eddiematos/iosolar/README.md

# iosolar
Design files for a modular solar power system. These files are licensed with an open-source hardware license based on the Apache License Version 2.0, known as the Solderpad Hardware Licence Version 2.
