eddiematos/iosolar/04 3D CAD/20141228_tooling/Draft Angle Images/B Grommet Draft.jpg

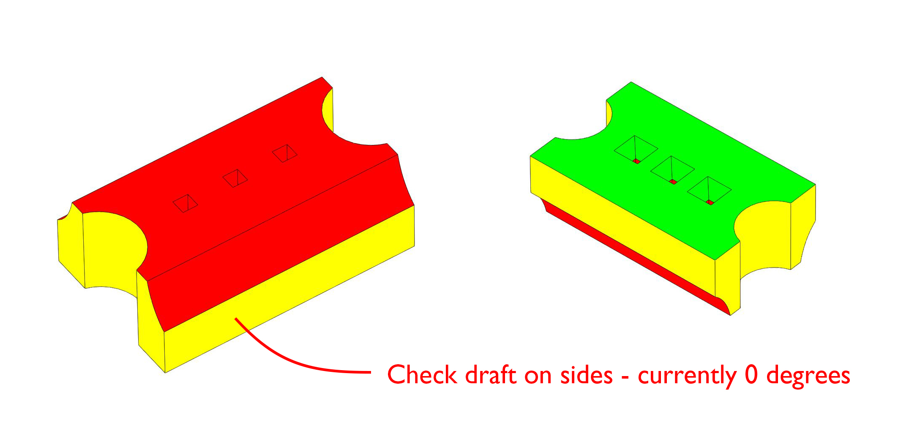
04 3D CAD/20141228_tooling/Draft Angle Images/B Grommet Draft.jpg
