eddiematos/iosolar/04 3D CAD/20141228_tooling/Draft Angle Images/Bottom Cover S 2.1.2 Draft.jpg

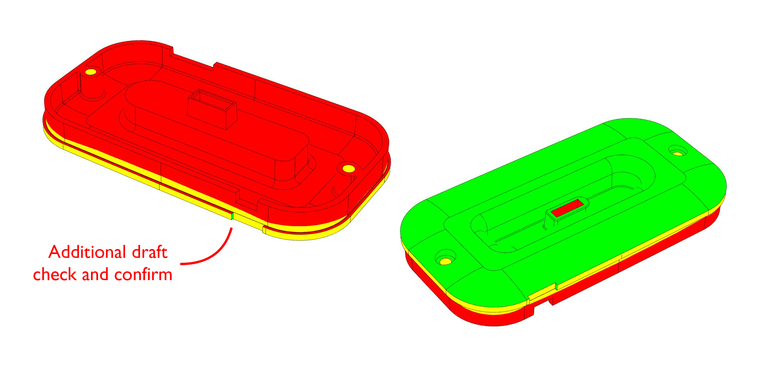
04 3D CAD/20141228_tooling/Draft Angle Images/Bottom Cover S 2.1.2 Draft.jpg
