eddiematos/iosolar/04 3D CAD/20141228_tooling/Draft Angle Images/Cross Section Across Pins.jpg

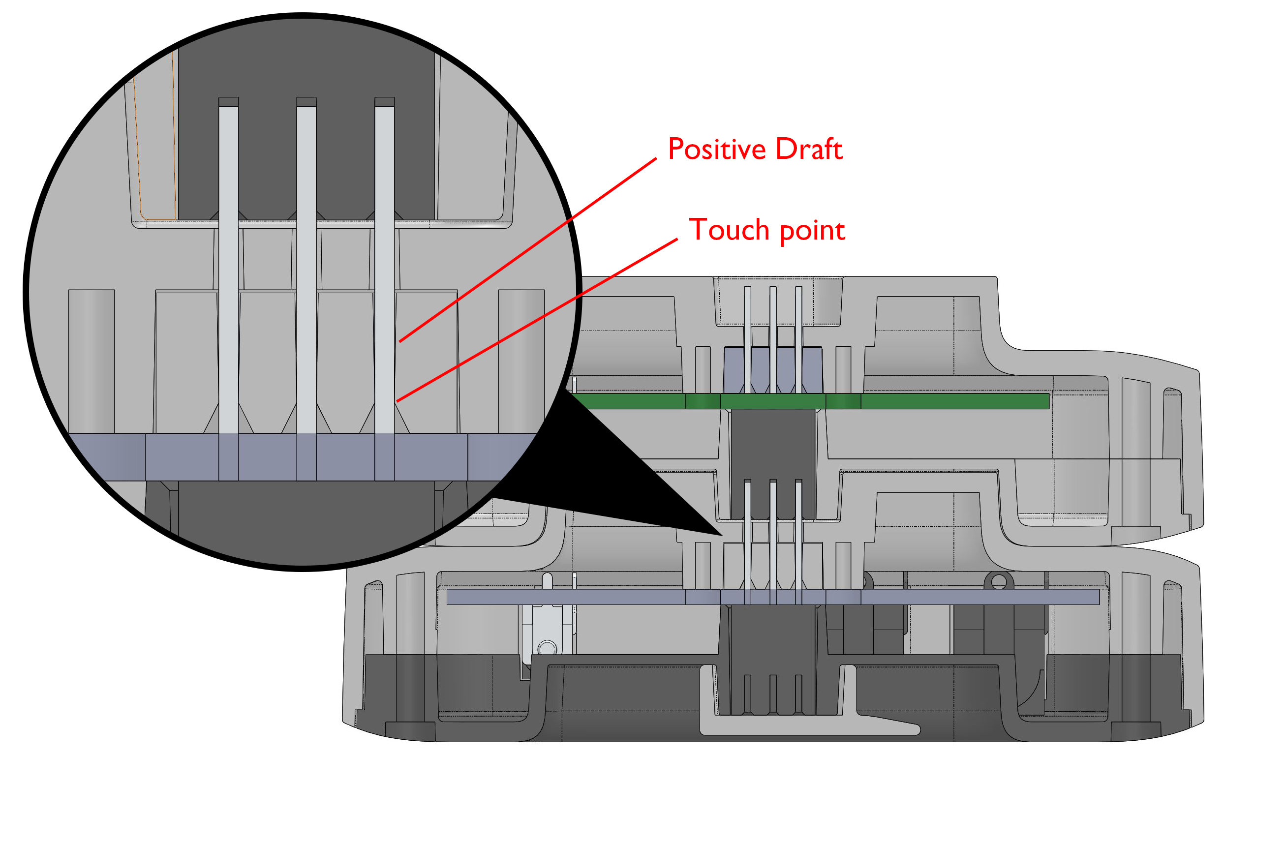
04 3D CAD/20141228_tooling/Draft Angle Images/Cross Section Across Pins.jpg
