eddiematos/iosolar/04 3D CAD/20141228_tooling/Draft Angle Images/Top Cover S 2.1.1 Draft.jpg

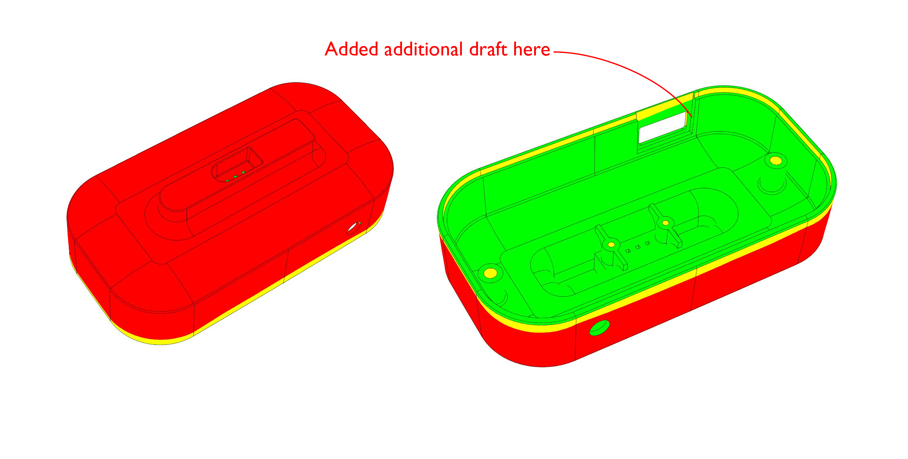
04 3D CAD/20141228_tooling/Draft Angle Images/Top Cover S 2.1.1 Draft.jpg
