eddiematos/iosolar/01 Printed Circuit Board/Charger/PCB extra cost to accomodate stacking connectors.xlsx

Estimate of extra cost of PCB space needed to be able to accommodate the stacking connectors.
PCB cost estimate
 | Cost | Size (mm²) | Cost/mm² | Doubled (because the copper thickness is double!)
Starter | £0.167 | 1925 | £0.0000867 | £0.0001733
Battery | £0.188 | 2275 | £0.0000825 | £0.0001650
Extra PCB space needed to accommodate stacking connectors
 | Size (mm²)
Without stacking connectors | 4788
With stacking connectors | 7740
Extra PCB space needed | 2952
Extra cost | £0.487
