eddiematos/iosolar/03 Bill of materials (electronics)/Battery 100/20150206 BOM_Battery100.xlsx

Sheet: PCB_spec
Part number | Part name | Spec ID | Spec description
B2.2.1 | Pre-assembled PCB-A | B2.2.1_handling | Normal precautions against electro-static discharge (ESD) shall be put into effect during handling and assembly of the PCB-As.
B2.2.2 | Pre-assembled PCB-A | B2.2.1_width | The width of the PCB shall be 35.0mm
B2.2.3 | Pre-assembled PCB-A | B2.2.1_length | The length of the PCB shall be 65.0mm.
B2.2.4 | Pre-assembled PCB-A | B2.2.4_thickness | The thickness of the PCB shall be 1.50mm.
B2.2.5 | Pre-assembled PCB-A | B2.2.5_material | The material of the PCB shall be FR4.
B2.2.6 | Pre-assembled PCB-A | B2.2.6_layers | The PCB shall have two layers (top and bottom)
B2.2.7 | Pre-assembled PCB-A | B2.2.7_copper | The copper layer thickness shall be 35 microns (1oz/ft²).
B2.2.8 | Pre-assembled PCB-A | B2.2.8_rohs | The PCB assembly shall be RoHS compliant.
B2.2.9 | Pre-assembled PCB-A | B2.2.9_soldermask | The soldermask colour shall be green.
B2.2.10 | Pre-assembled PCB-A | B2.2.10_silkscreen | The silkscreen printing shall be white.
B2.2.11 | Pre-assembled PCB-A | B2.2.11_coating | A basic protective conformal coating is desirable. Please advise with information about protective conformal coating options and their costs.

Sheet: BOM_spec
BOM Specification
Part ID | Part description | Manufacturer | Part number | Leadsintec spec (green - approved) | Replacable? | PCS | Spec 1 | Value (min) | Value (max) | Spec 2 | Value (min) | Value (max) | Spec 3 | Value (min) | Value (max) | Spec 4 | Value (min) | Value (max) | Spec 5 | Value (min) | Value (max)
C1 | Capacitor (MLCC) | Any | 0603 | 0603 1UF 10V X7R 10% (ROHS) | Yes | 1 | Capacitance (F) | 1e-06 |  | V_max (V) | 5 |  | Type | X7R
C12 | Capacitor (MLCC) | Any | 0805 | 0805 10UF 10V X5R 10% (ROHS) | Yes | 1 | Capacitance (F) | 1e-05 |  | V_max (V) | 5
C14 | Capacitor (MLCC) | Any | 0603 | 0603 1NF 50V 5% (ROHS) | Yes | 1 | Capacitance (F) | 1e-09 |  | V_max (V) | 5
C2 | Capacitor (MLCC) | Any | 0603 | 0603 2.2NF 50V X7R 10% (ROHS) | Yes | 1 | Capacitance (F) | 2.2e-09 |  | V_max (V) | 5
C3,7,8,9,10,13,15 | Capacitor (MLCC) | Any | 0603 | 0603 100NF 50V X7R 10% (ROHS) | Yes | 7 | Capacitance (F) | 1e-07 |  | V_max (V) | 5
C4 | Capacitor (MLCC) | Any | 0603 | 0603 100NF 50V X7R 10% (ROHS) | Yes | 1 | Capacitance (F) | 1e-07 |  | V_max (V) | 30 |  | Type | X7R
C6 | Capacitor (Aluminium electrolytic) | Lelon | VZH101M1VTR-0810 | 100UF 35V 20% 8*10.2MM PN:SANYO 35CE100AX (ROHS) | Yes | 1 | Capacitance (F) | 0.0001 |  | V_max (V) | 25 |  | Height (mm) |  | 11.0 | Lifetime (hours) | 5000
C11 | Capacitor (Aluminium electrolytic) | Lelon | VZH101M1VTR-0810 | 100UF 35V 20% 8*10.2MM PN:SANYO 35CE100AX (ROHS) | Yes | 1 | Capacitance (F) | 0.0001 |  | V_max (V) | 20 |  | Height (mm) |  | 11.0 | Lifetime (hours) | 5000 |  | Ir_max (RMS, mA, @50kHz) | 190
LED1 | Red/Green LED, common cathode | Multicomp | MCL039PURGW | MULTICOMP Red Green PN:MCL039PURGW (ROHS) | No | 1
D2,5,8 | Schottky diode, low Vf | NXP | PMEG3010BEA | NXP PMEG3010BEA SOD323 (ROHS) | Yes | 3 | V_f @ 0.2A, 85C (V) |  | 0.4 | I_fmax (av.) (A) | 0.5 |  | I_frm (A) | 1 |  | Vr_max (V) | 30
D3 | Schottky diode, low Vf, high I_fsm | Diodes Inc. | B340-13-F | DIODES B340-13-F SMC (ROHS) | Yes | 1 | V_f @ 0.2A, 85C (V) |  | 0.4 | I_f (av.) (A) | 2.5 |  | I_fsm (8.3mS) (A) | 20 |  | Vr_max (V) | 30
D6(A/B) | Dual schottky diode (common cathode) | Any | BAT54CWT1G | ON BAT54CWT1G SOT323 (ROHS) | Yes | 1 | I_f_max (A) | 0.2
F1 | PTC resettable fuse | Multicomp | MC36218 | MULTICOMP 750MAA 0.29R PN:MC36218 (ROHS) | Yes | 1 | V_max (V) | 20 |  | I_hold (A) | 0.75 |  | I_trip (A) |  | 1.5 | I_8.3ms (A) |  | 20
IC1 | 16-bit MCU | TI | MSP430G2332IPW20 | TI MSP430G2332IPW20 TSSOP-20 (ROHS) | No | 1
IC2 | MCU power supply, 3.3V | TI | TPS71533DCKR | TI TPS71533DCKR SC70 (ROHS) | No | 1
IC3 | DC/DC Converter controller | TI | MC33063AD | TI MC33063AD SOIC-8 (ROHS) | No | 1
J1,2 | DC barrel connector, 2.5mm, CUI, PJ-037BH | CUI | PJ-037BH | Socket ø2.5MM 90Degree 14.5*9*11MM PN:PJ-037BH (ROHS) | Yes | 2 | V_max (V) | 15 |  | I_max (A) | 3
J3 | DC barrel connector, 1.7mm, CUI, PJ-018 | CUI | PJ-017 | Socket ø1.65MM (PN:PJ-018）(ROHS) | Yes | 1 | V_max (V) | 25 |  | I_max (A) | 1
J4 | Right-angle JST connector, 5 way | JST | S5B-PH-K-S | JST BOX HEADER 5PIN 90Degree 2.0MM PN:S5B-PH-K-S (ROHS) | No | 1
J6 | Long header receptacle, Samtec, 3-way | Samtec | ESQ-103-14-T-S | SAMTEC 1*3PIN 2.54MM PN:ESQ-103-14-T-S/ESQ-103-14-L-S (ROHS) | No | 1
L1 | Inductor | NIC | NPIS65LS221MTRF | NPIS 220UH 20% 6*6*4.5MM PN:NPIS65LS221MTRF (ROHS) | Yes | 1 | Inductance (uH) | 220 |  | R_dc_max (Ω) |  | 1 | I_rms_max (A) | 0.4 |  | Diameter (mm) |  | 12.7 | Height (mm) |  | 11.0
Q1 | P-channel MOSFET, high surge current | Diodes Inc. | DMG3407SSN-7 | DIODES DMG3407SSN-7 SC59 (ROHS) | Yes | 1 | R_on_max (Ω) |  | 0.15 | I_max (av.) @ 70C (A) | 2.5 |  | I_max (8.3ms) (A) | 20 |  | Vds_max (V) | 17 |  | Vgs_max (V) | 17
Q2(A/B), Q5(A/B) | Dual NPN transistor | On Semi | BC846BDW1T1G | ON BC846BDW1T1G SOT-363 (ROHS) | Yes | 2 | Vceo_max (V) | 20 |  | Ic_max (mA) | 10
Q3(A/B), Q4(A/B) | Dual P-channel MOSFET | NXP | NX3008PBKV | NXP NX3008PBKV SOT666 (ROHS) | Yes | 2 | R_on_max (Ω) |  | 10 | I_max (av.) @ 70C (mA) | 60 |  | Vds_max (V) | 10 |  | Vgs_max (V) | 8
R1,3,5,7 | Resistor | Any | 0805 | 0805 1M 1% (ROHS) | Yes | 4 | Resistance (Ω) | 1000000 |  | Tolerance |  | 0.1%
R10 | Resistor | Any | 0603 | 0603 10K 5% (ROHS) | Yes | 1 | Resistance (Ω) | 10000 |  | Tolerance |  | 5%
R11 | Resistor | Any | 0603 | 0603 33K 5% (ROHS) | Yes | 1 | Resistance (Ω) | 33000 |  | Tolerance |  | 5%
R12 | Resistor | Any | 0603 | 0603 3.3K 5% (ROHS) | Yes | 1 | Resistance (Ω) | 3300 |  | Tolerance |  | 5%
R13 | Resistor | Any | 1206 | 1206 0.47R 5% (ROHS) | Yes | 1 | Resistance (Ω) | 0.47 |  | Tolerance |  | 5% | P_max (W) | 0.250
R14 | Resistor | Any | 0603 | 0603 9.1K 1% (ROHS) | Yes | 1 | Resistance (Ω) | 9100 |  | Tolerance |  | 1%
R15 | Resistor | Any | 0603 | 0603 1.3K 1% (ROHS) | Yes | 1 | Resistance (Ω) | 1300 |  | Tolerance |  | 1%
R16,21,30,31,32,33,34 | Resistor | Any | 0603 | 0603 100K 5% (ROHS) | Yes | 7 | Resistance (Ω) | 100000 |  | Tolerance |  | 5%
R17,19 | Resistor | Any | 0603 | 0603 1.2K 1% (ROHS) | Yes | 2 | Resistance (Ω) | 1200 |  | Tolerance |  | 1%
R2,4,6,8 | Resistor | Any | 0805 | 0805 100K 1% (ROHS) | Yes | 4 | Resistance (Ω) | 100000 |  | Tolerance |  | 0.1%
R20 | Resistor | Any | 0603 | 0603 1M 1% (ROHS) | Yes | 1 | Resistance (Ω) | 1000000 |  | Tolerance |  | 1%
R22 | Resistor | Any | 0603 | 0603 2.2K 1% (ROHS) | Yes | 1 | Resistance (Ω) | 2200 |  | Tolerance |  | 1%
R23 | Resistor | Any | 0603 | 0603 33K 1% (ROHS) | Yes | 1 | Resistance (Ω) | 33000 |  | Tolerance |  | 1%
R35,36,37,38 | Resistor | Any | 1206 | 1206 100R 1% (ROHS) | Yes | 4 | Resistance (Ω) | 100 |  | Tolerance |  | 1% | P_max (W) | 0.125
R9,18 | Resistor | Any | 0603 | 0603 47K 1% (ROHS) | Yes | 2 | Resistance (Ω) | 47000 |  | Tolerance |  | 1%

Sheet: BOM_EM
EM sourcing
Part ID | Part description | PCS | Spec 1 | Value | Spec 2 | Value | Spec 3 | Value | Spec 4 | Value | Spec 5 | Value | Source | Order code | Price (1000pcs) | Currency | Total component price (USD) | Assembly points (per unit) | Assembly type | Unit assembly cost (USD) | Total assembly price (USD) | Total price (USD) | Package size | Part number | CNY | 0.1612903226
C1 | Capacitor (MLCC) | 1 | Capacitance (F) | 1e-06 | V_max (V) | 10 | Type | X7R |  |  |  |  | Farnell | 2112849 | 0.080 | CNY | 0.0129 | 1.0 | smt | 0.007 | 0.007 | 0.020 | 0603 |  | GBP | 1.53 | 0.375
C12 | Capacitor (MLCC) | 1 | Capacitance (F) | 1e-05 | V_max (V) | 10 |  |  |  |  |  |  | Farnell | 1735335 | 0.147 | CNY | 0.0237 | 1.0 | smt | 0.007 | 0.007 | 0.031 | 0805 |  | USD | 1
C14 | Capacitor (MLCC) | 1 | Capacitance (F) | 1e-09 | V_max (V) | 50 |  |  |  |  |  |  | Farnell | 499134 | 0.023 | CNY | 0.0037 | 1.0 | smt | 0.007 | 0.007 | 0.011 | 0603
C2 | Capacitor (MLCC) | 1 | Capacitance (F) | 2.2e-09 | V_max (V) | 50 |  |  |  |  |  |  | Farnell | 2320806 | 0.024 | CNY | 0.0039 | 1.0 | smt | 0.007 | 0.007 | 0.011 | 0603
C3,7,8,9,10,13,15 | Capacitor (MLCC) | 7 | Capacitance (F) | 1e-07 | V_max (V) | 50 |  |  |  |  |  |  | Farnell | 1759016 | 0.018 | CNY | 0.0203 | 1.0 | smt | 0.007 | 0.049 | 0.069 | 0603
C4 | Capacitor (MLCC) | 1 | Capacitance (F) | 1e-07 | V_max (V) | 50 | Type | X7R |  |  |  |  | Farnell | 1759122 | 0.031 | CNY | 0.0050 | 1.0 | smt | 0.007 | 0.007 | 0.012 | 0603
C6 | Capacitor (Aluminium electrolytic) | 1 | Capacitance (F) | 0.0001 | V_max (V) | 35 | Height (mm) | 10.0 | Diameter (mm) | 8.0 | Ir_max (mA) | 450 | Arrow | - | 0.062 | USD | 0.0625 | 1.0 | smt | 0.007 | 0.007 | 0.070 | 8MM Radial Can SMD | VZH101M1VTR-0810
C11 | Capacitor (Aluminium electrolytic) | 1 | Capacitance (F) | 0.0001 | V_max (V) | 35 | Height (mm) | 10.0 | Diameter (mm) | 8.0 | Ir_max (mA) | 450 | Arrow | - | 0.062 | USD | 0.0625 | 1.0 | smt | 0.007 | 0.007 | 0.070 | 8MM Radial Can SMD | VZH101M1VTR-0810
LED1 | Red/Green LED, common cathode | 1 | Manufacturer | Multicomp | Model | MCL039PURGW |  |  |  |  |  |  | Farnell | 1581194 | 1.900 | CNY | 0.3065 | 3.0 | pth | 0.042 | 0.042 | 0.348 | 3MM (T1)
D2,5,8 | Schottky diode, low Vf | 3 | V_f @ 0.2A, 85C (V) | 0.24 | I_fmax (av.) (A) | 1 | I_frm (A) | 3.5 | Vr_max (V) | 30 |  |  | Farnell | 8737991 | 0.325 | CNY | 0.1573 | 1.5 | smt | 0.011 | 0.0315 | 0.189 | SOD-323 | PMEG3010BEA
D3 | Schottky diode, low Vf, high I_fsm | 1 | V_f @ 0.2A, 85C (V) | 0.25 | I_f (av.) (A) | 3 | I_fsm (8.3mS) (A) | 100 | Vr_max (V) | 40 |  |  | Farnell/Arrow | 1843695 | 0.083 | USD | 0.0825 | 1.5 | smt | 0.011 | 0.0105 | 0.093 | SMC (6mm x 7mm) | B340-13-F
D6(A/B) | Dual schottky diode (common cathode) | 1 |  |  |  |  |  |  |  |  |  |  | Farnell | 2322475 | 0.190 | CNY | 0.0306 | 1.5 | smt | 0.011 | 0.0105 | 0.041 | SOT-323 | BAT54CWT1G
F1 | PTC resettable fuse | 1 | V_max (V) | 24 | I_hold (A) | 0.75 | I_trip (A) | 1.5 | I_8ms (A) | 15 |  |  | Farnell | 1861163 | 0.900 | CNY | 0.1452 | 2.0 | smt | 0.014 | 0.014 | 0.159 | 1812 | MC36218
IC1 | 16-bit MCU | 1 | Manufacturer | TI | Model | MSP430G2332IPW20 |  |  |  |  |  |  | Farnell | 1866892 | 5.060 | CNY | 0.8161 | 10.0 | smt | 0.070 | 0.07 | 0.886 | TSSOP-20 | MSP430G2332IPW20
IC2 | MCU power supply, 3.3V | 1 | Manufacturer | TI | Model | TPS71533DCK |  |  |  |  |  |  | Farnell/Arrow | 1135383 | 0.364 | USD | 0.3643 | 2.5 | smt | 0.018 | 0.0175 | 0.382 | SC-70-5 | TPS71533DCKR
IC3 | DC/DC Converter controller | 1 | Manufacturer | TI | Model | MC33063AD |  |  |  |  |  |  | Farnell/Arrow | 1053587 | 1.600 | CNY | 0.2581 | 4.0 | smt | 0.028 | 0.028 | 0.286 | SOIC-08 | MC33063AD
J1,2 | DC barrel connector, 2.5mm, CUI, PJ-037BH | 2 | V_max (V) | 16 | I_max (A) | 5 |  |  |  |  |  |  | DigiKey | CP-037BH-ND | 2.939 | CNY | 0.9480 | 2.0 | pth | 0.028 | 0.056 | 1.004 | 11.4mm x 5.0mm | PJ-037BH
J3 | DC barrel connector, 1.7mm, CUI, PJ-018 | 1 | V_max (V) | 16 | I_max (A) | 2 |  |  |  |  |  |  | DigiKey | CP-018PJ-ND | 2.595 | CNY | 0.4185 | 3.0 | pth | 0.042 | 0.042 | 0.461 | 14.5mm x 9.0mm | PJ-018
J4 | Right-angle JST connector, 5 way | 1 | Manufacturer | JST | Model | S5B-PH-K-S |  |  |  |  |  |  | Farnell | 9492496 | 0.391 | CNY | 0.0631 | 5.0 | pth | 0.070 | 0.07 | 0.133 | 5 x 2.0mm
J6 | Long header connector, Samtec, 3-way | 1 | Manufacturer | Samtec | Model | ESQ-103-14-T-S |  |  |  |  |  |  | Samtec | - | 0.281 | GBP | 0.4299 | 3.0 | pth | 0.042 | 0.042 | 0.472 | 3 x 2.54mm | ESQ-103-14-T-S
L1 | Inductor | 1 | Inductance (uH) | 220uH | R_dc_max (Ω) | 0.834 | I_rms_max (A) | 0.59 | Diameter (mm) | 6.3 | Height (mm) | 4.5 | Arrow | - | 0.130 | USD | 0.1300 | 2.0 | smt | 0.014 | 0.014 | 0.144 | 6.3Lx6.3Wx4.5Hmm | NPIS65LS221MTRF
Q1 | P-channel MOSFET, high surge current | 1 | R_on_max (Ω) | 0.05 | I_max (av.) @ 70C (A) | 3.2 | I_max (10ms) (A) | 23 | Vds_max (V) | 30 | Vgs_max (V) | 20 | Arrow | - | 0.078 | USD | 0.0780 | 1.5 | smt | 0.011 | 0.0105 | 0.088 | SC-59 | DMG3407SSN-7
Q2(A/B), Q5(A/B) | Dual NPN transistor | 2 | Vceo_max (V) | 65 | Ic_max (mA) | 100 |  |  |  |  |  |  | Farnell/Arrow | 2317636 | 0.043 | USD | 0.0866 | 3.0 | smt | 0.021 | 0.042 | 0.129 | SOT-363 | BC846BDW1T1G
Q3(A/B), Q4(A/B) | Dual P-channel MOSFET | 2 | R_on_max (Ω) | 4.1 | I_max (av.) @ 70C (mA) | 140 | Vds_max (V) | 30 | Vgs_max (V) | 8 |  |  | Farnell | 2069550 | 0.690 | CNY | 0.2226 | 3.0 | smt | 0.021 | 0.042 | 0.265 | SOT-666 | NX3008PBKV
R1,3,5,7 | Resistor | 4 | Resistance (Ω) | 1000000 | Tolerance | 0.1% |  |  |  |  |  |  | Farnell | 1638448 | 0.300 | CNY | 0.1935 | 1.0 | smt | 0.007 | 0.028 | 0.222 | 0805
R10 | Resistor | 1 | Resistance (Ω) | 10000 | Tolerance | 5% |  |  |  |  |  |  | Farnell | 2073356 | 0.010 | CNY | 0.0016 | 1.0 | smt | 0.007 | 0.007 | 0.009 | 0603
R11 | Resistor | 1 | Resistance (Ω) | 33000 | Tolerance | 1% |  |  |  |  |  |  | Farnell | 2447342 | 0.070 | CNY | 0.0113 | 1.0 | smt | 0.007 | 0.007 | 0.018 | 0603
R12 | Resistor | 1 | Resistance (Ω) | 3300 | Tolerance | 5% |  |  |  |  |  |  | Farnell | 9233440 | 0.005 | CNY | 0.0009 | 1.0 | smt | 0.007 | 0.007 | 0.008 | 0603
R13 | Resistor | 1 | Resistance (Ω) | 0.47 | Tolerance | 5% | P_max (W) | 0.5 |  |  |  |  | Farnell | 2116435 | 0.350 | CNY | 0.0565 | 2.0 | smt | 0.014 | 0.014 | 0.070 | 1206
R14 | Resistor | 1 | Resistance (Ω) | 9100 | Tolerance | 1% |  |  |  |  |  |  | Farnell | 9331611 | 0.009 | CNY | 0.0015 | 1.0 | smt | 0.007 | 0.007 | 0.008 | 0603
R15 | Resistor | 1 | Resistance (Ω) | 1300 | Tolerance | 1% |  |  |  |  |  |  | Farnell | 9330550 | 0.011 | CNY | 0.0018 | 1.0 | smt | 0.007 | 0.007 | 0.009 | 0603
R16,21,30,31,32,33,34 | Resistor | 7 | Resistance (Ω) | 100000 | Tolerance | 5% |  |  |  |  |  |  | Farnell | 9233628 | 0.065 | CNY | 0.0734 | 1.0 | smt | 0.007 | 0.049 | 0.122 | 0603
R17,19 | Resistor | 2 | Resistance (Ω) | 1200 | Tolerance | 1% |  |  |  |  |  |  | Farnell | 9238492 | 0.009 | CNY | 0.0029 | 1.0 | smt | 0.007 | 0.014 | 0.017 | 0603
R2,4,6,8 | Resistor | 4 | Resistance (Ω) | 100000 | Tolerance | 0.10% |  |  |  |  |  |  | Farnell | 1638446 | 0.200 | CNY | 0.1290 | 1.0 | smt | 0.007 | 0.028 | 0.157 | 0805
R20 | Resistor | 1 | Resistance (Ω) | 1000000 | Tolerance | 1% |  |  |  |  |  |  | Farnell | 9238840 | 0.010 | CNY | 0.0016 | 1.0 | smt | 0.007 | 0.007 | 0.009 | 0603
R22 | Resistor | 1 | Resistance (Ω) | 2200 | Tolerance | 1% |  |  |  |  |  |  | Farnell | 1255637 | 0.009 | CNY | 0.0015 | 1.0 | smt | 0.007 | 0.007 | 0.008 | 0603
R23 | Resistor | 1 | Resistance (Ω) | 33000 | Tolerance | 1% |  |  |  |  |  |  | Farnell | 9238662 | 0.009 | CNY | 0.0015 | 1.0 | smt | 0.007 | 0.007 | 0.008 | 0603
R35,36,37,38 | Resistor | 4 | Resistance (Ω) | 100 | Tolerance | 1% | Pmax (W) | 0.125 |  |  |  |  | Farnell | 9335749 | 0.020 | CNY | 0.0129 | 2.0 | smt | 0.014 | 0.056 | 0.069 | 1206
R9,18 | Resistor | 2 | Resistance (Ω) | 47000 | Tolerance | 1% |  |  |  |  |  |  | Farnell | 9331255 | 0.006 | CNY | 0.0019 | 1.0 | smt | 0.007 | 0.014 | 0.016 | 0603
 |  |  |  |  |  |  |  |  |  |  |  |  |  |  |  |  | 5.2234 |  |  |  | 0.8995 | 6.123
 |  |  |  |  |  |  |  |  |  |  |  |  |  |  |  |  |  | smt points | 57.5
 |  |  |  |  |  |  |  |  |  |  |  |  |  |  |  |  |  | pth points | 16

Sheet: BOM_FP
FastPCB sourcing
Part ID | Part description | PCS | Spec 1 | Value | Spec 2 | Value | Spec 3 | Value | Spec 4 | Value | Spec 5 | Value | Source | Order code | Price (1000pcs) | Currency | Total price (USD) | Cost difference | Package size | Part number | Price | CNY | 0.1612903226
C1 | Capacitor (MLCC) | 1 | Capacitance (F) | 1e-06 | V_max (V) | 5V | Type | X7R |  |  |  |  |  |  | 0.060 | CNY | 0.010 | 0.010 | 0603 |  |  | USD | 1
C12 | Capacitor (MLCC) | 1 | Capacitance (F) | 1e-05 | V_max (V) | 5V |  |  |  |  |  |  |  |  | 0.080 | CNY | 0.013 | 0.018 | 0805
C14 | Capacitor (MLCC) | 1 | Capacitance (F) | 1e-09 | V_max (V) | 5V |  |  |  |  |  |  |  |  | 0.050 | CNY | 0.008 | 0.003 | 0603
C2 | Capacitor (MLCC) | 1 | Capacitance (F) | 2.2e-09 | V_max (V) | 5V |  |  |  |  |  |  |  |  | 0.050 | CNY | 0.008 | 0.003 | 0603
C3,7,8,9,10,13,15 | Capacitor (MLCC) | 7 | Capacitance (F) | 1e-07 | V_max (V) | 5V |  |  |  |  |  |  |  |  | 0.009 | CNY | 0.010 | 0.059 | 0603
C4 | Capacitor (MLCC) | 1 | Capacitance (F) | 1e-07 | V_max (V) | 50V | Type | X7R |  |  |  |  |  |  | 0.060 | CNY | 0.010 | 0.002 | 0603
C6 | Capacitor (Aluminium electrolytic) | 1 | Capacitance (F) | 0.0001 | V_max (V) | 50V | Height (mm) | 12.0 | Diameter (mm) | 8.0 | Ir_max (mA) |  |  |  | 0.800 | CNY | 0.129 | -0.060
C11 | Capacitor (Aluminium electrolytic) | 1 | Capacitance (F) | 0.0001 | V_max (V) | 50V | Height (mm) | 10.0 | Diameter (mm) | 8.0 | Ir_max (mA) |  |  |  | 0.800 | CNY | 0.129 | -0.060
LED1 | Red/Green LED, common cathode | 1 | Manufacturer | - | Model | - |  |  |  |  |  |  |  |  | 0.250 | CNY | 0.040 | 0.308
D2,5,8 | Schottky diode, low Vf | 3 | V_f @ 0.2A, 85C (V) | 0.24 | I_fmax (av.) (A) | 1 | I_frm (A) | 3.5 | Vr_max (V) | 30 |  |  |  |  | 0.380 | CNY | 0.184 | 0.005 | SOD-323 | PMEG3010BEA
D3 | Schottky diode, low Vf, high I_fsm | 1 | V_f @ 0.2A, 85C (V) | 0.25 | I_f (av.) (A) | 3 | I_fsm (8.3mS) (A) | 100 | Vr_max (V) | 40 |  |  |  |  | 0.390 | CNY | 0.063 | 0.030 | SMC (6mm x 7mm) | B340B-13-F
D6(A/B) | Dual schottky diode (common cathode) | 1 |  |  |  |  |  |  |  |  |  |  |  |  | 0.180 | CNY | 0.029 | 0.012 | SOT-323 | BAT54CWT1G
F1 | PTC resettable fuse | 1 | V_max (V) | 24 | I_hold (A) | 0.75 | I_trip (A) | 1.5 | I_8ms (A) | 15 |  |  |  |  | 0.970 | CNY | 0.156 | 0.003 | 1812 | MC36218
IC1 | 16-bit MCU | 1 | Manufacturer | TI | Model | MSP430G2332IPW20 |  |  |  |  |  |  |  |  | 4.500 | CNY | 0.726 | 0.160 | TSSOP-20 | MSP430G2332IPW20
IC2 | MCU power supply, 3.3V | 1 | Manufacturer | TI | Model | TPS71533DCK |  |  |  |  |  |  |  |  | 1.800 | CNY | 0.290 | 0.091 | SC-70 | TPS71533DCKR
IC3 | DC/DC Converter controller | 1 | Manufacturer | TI | Model | MC33063AD |  |  |  |  |  |  |  |  | 1.400 | CNY | 0.226 | 0.060 | SOIC-08 | MC33063AD
J1,2 | DC barrel connector, 2.5mm, CUI, PJ-037BH | 2 | V_max (V) | 16 | I_max (A) | 5 |  |  |  |  |  |  |  |  | 2.960 | CNY | 0.955 | 0.049 | 11.4mm x 5.0mm | PJ-037BH
J3 | DC barrel connector, 1.7mm, CUI, PJ-018 | 1 | V_max (V) | 16 | I_max (A) | 2 |  |  |  |  |  |  |  |  | 2.500 | CNY | 0.403 | 0.057 | 14.5mm x 9.0mm | PJ-018
J4 | Right-angle JST connector, 5 way | 1 | Manufacturer | JST | Model | S5B-PH-K-S |  |  |  |  |  |  |  |  | 0.500 | CNY | 0.081 | 0.052 | 5 x 2.0mm
J6 | Long header connector, Samtec, 3-way | 1 | Manufacturer | Samtec | Model | SSQ |  |  |  |  |  |  |  |  | 2.200 | CNY | 0.355 | 0.117 | 3 x 2.54mm | SSQ-103-04-T-S
L1 | Inductor | 1 | Inductance (uH) | 220uH | R_dc_max (Ω) | 0.834 | I_rms_max (A) | 0.59 | Diameter (mm) | 6.3 | Height (mm) | 4.5 |  |  | 0.910 | CNY | 0.147 | -0.003 | 6.3Lx6.3Wx4.5Hmm | NPIS65LS221MTRF
Q1 | P-channel MOSFET, high surge current | 1 | R_on_max (Ω) | 0.05 | I_max (av.) @ 70C (A) | 3.2 | I_max (10ms) (A) | 23 | Vds_max (V) | 30 | Vgs_max (V) | 20 |  |  | 0.700 | CNY | 0.113 | -0.024 | SC-59 | DMG3407SSN-7
Q2(A/B), Q5(A/B) | Dual NPN transistor | 2 | Vceo_max (V) | 65 | Ic_max (mA) | 100 |  |  |  |  |  |  |  |  | 0.150 | CNY | 0.048 | 0.080 | SOT-363 | BC846BDW1T1G
Q3(A/B), Q4(A/B) | Dual P-channel MOSFET | 2 | R_on_max (Ω) | 4.1 | I_max (av.) @ 70C (mA) | 140 | Vds_max (V) | 30 | Vgs_max (V) | 8 |  |  |  |  | 0.500 | CNY | 0.161 | 0.103 | SOT-666 | NX3008PBKV
R1,3,5,7 | Resistor | 4 | Resistance (Ω) | 1000000 | Tolerance | 0.1% |  |  |  |  |  |  |  |  | 0.186 | CNY | 0.120 | 0.102 | 0805
R10 | Resistor | 1 | Resistance (Ω) | 10000 | Tolerance | 5% |  |  |  |  |  |  |  |  | 0.010 | CNY | 0.002 | 0.007 | 0603
R11 | Resistor | 1 | Resistance (Ω) | 33000 | Tolerance | 5% |  |  |  |  |  |  |  |  | 0.010 | CNY | 0.002 | 0.017 | 0603
R12 | Resistor | 1 | Resistance (Ω) | 3300 | Tolerance | 5% |  |  |  |  |  |  |  |  | 0.010 | CNY | 0.002 | 0.006 | 0603
R13 | Resistor | 1 | Resistance (Ω) | 0.56 | Tolerance | 1% | P_max (W) | 0.25 |  |  |  |  |  |  | 0.150 | CNY | 0.024 | 0.046 | 1206
R14 | Resistor | 1 | Resistance (Ω) | 9100 | Tolerance | 1% |  |  |  |  |  |  |  |  | 0.010 | CNY | 0.002 | 0.007 | 0603
R15 | Resistor | 1 | Resistance (Ω) | 1300 | Tolerance | 1% |  |  |  |  |  |  |  |  | 0.010 | CNY | 0.002 | 0.007 | 0603
R16,21,30,31,32,33,34 | Resistor | 7 | Resistance (Ω) | 100000 | Tolerance | 1% |  |  |  |  |  |  |  |  | 0.004 | CNY | 0.005 | 0.118 | 0603
R17,19 | Resistor | 2 | Resistance (Ω) | 1200 | Tolerance | 1% |  |  |  |  |  |  |  |  | 0.010 | CNY | 0.003 | 0.014 | 0603
R2,4,6,8 | Resistor | 4 | Resistance (Ω) | 100000 | Tolerance | 0.10% |  |  |  |  |  |  |  |  | 0.186 | CNY | 0.120 | 0.037 | 0805
R20 | Resistor | 1 | Resistance (Ω) | 1000000 | Tolerance | 1% |  |  |  |  |  |  |  |  | 0.010 | CNY | 0.002 | 0.007 | 0603
R22 | Resistor | 1 | Resistance (Ω) | 2200 | Tolerance | 1% |  |  |  |  |  |  |  |  | 0.010 | CNY | 0.002 | 0.007 | 0603
R23 | Resistor | 1 | Resistance (Ω) | 33000 | Tolerance | 1% |  |  |  |  |  |  |  |  | 0.010 | CNY | 0.002 | 0.007 | 0603
R35,36,37,38 | Resistor | 4 | Resistance (Ω) | 100 | Tolerance | 1% | Pmax (W) | 0.125 |  |  |  |  |  |  | 0.004 | CNY | 0.003 | 0.066 | 1206
R9,18 | Resistor | 2 | Resistance (Ω) | 47000 | Tolerance | 1% |  |  |  |  |  |  |  |  | 0.010 | CNY | 0.003 | 0.013 | 0603
 |  |  |  |  |  |  |  |  |  |  |  |  |  |  |  |  | 4.585 | 1.538 | 33.55168338%
