eddiematos/iosolar/03 Bill of materials (electronics)/Charger/20160209 BOM_Charger.xlsx

Sheet: BOM_spec
BOM Specification
Part ID | Part description | Manufacturer | Part number | Package | Proto OC | Order margin | Est. unit cost (1000 units) | Replacable? | PCS | Est. total cost (1000 units) | Spec 1 | Value (min) | Value (max) | Spec 2 | Value (min) | Value (max) | Spec 3 | Value (min) | Value (max) | Spec 4 | Value (min) | Value (max) | Spec 5 | Value (min) | Value (max)
C1,13,14,19 | Capacitor (MLCC) | Any | 0603 | 0603 | 2211179 | 2 | £0.027 | Yes | 4 | £0.107 | Capacitance (F) | 1e-06 |  | V_max | 35 |  | Dielectric | X5R
C2,10 | Capacitor (MLCC) | Any | 0603 | 0603 | 2211179 | 2 | £0.007 | Yes | 2 | £0.013 | Capacitance (F) | 1e-06 |  | V_max | 15 |  | Dielectric | X5R
C3,12 | Capacitor (MLCC) | Any | 0603 | 0603 | 2309012 | 2 | £0.004 | Yes | 2 | £0.007 | Capacitance (F) | 2.2e-11 |  | V_max | 35 |  | Dielectric | X5R
C4,5 | Capacitor (MLCC) | Murata | GRM31CR6YA106KA12L | 1206 | 1797011 | 2 | £0.125 | No | 2 | £0.250 | Capacitance (F) | 1e-05 |  | V_max | 35 |  | Dielectric | X5R |  | I_rms_max (@600kHz) (A) | 0.267
C6,7 | Capacitor (MLCC) | Murata | GRM31CR6YA106KA12L | 1206 | 1797011 | 2 | £0.125 | No | 2 | £0.250 | Capacitance (F) | 1e-05 |  | V_max | 35 |  | Dielectric | X5R |  | I_rms_max (@600kHz) (A) | 1.667
C8,9,00 | Capacitor (MLCC) | Any | 0603 | 0603 | 1759037 | 2 | £0.003 | Yes | 3 | £0.009 | Capacitance (F) | 1e-07 |  | V_max | 15 |  | Dielectric | X5R
C11 | Capacitor (MLCC) | Any | 0603 | 0603 | 2211185 | 2 | £0.036 | Yes | 1 | £0.036 | Capacitance (F) | 2.2e-06 |  | V_max | 35 |  | Dielectric | X5R
C15 | Capacitor (MLCC) | Any | 0603 | 0603 | 2320814 | 2 | £0.018 | Yes | 1 | £0.018 | Capacitance (F) | 1e-06 |  | V_max | 6.3 |  | Dielectric | X5R
C16,18,20,21,22 | Capacitor (MLCC) | Any | 0603 | 0603 | 1759016 | 2 | £0.003 | Yes | 5 | £0.015 | Capacitance (F) | 1e-07 |  | V_max | 6.3 |  | Dielectric | X5R
C17 | Capacitor (MLCC) | Any | 0603 | 0603 | 1759093 | 2 | £0.005 | Yes | 1 | £0.005 | Capacitance (F) | 2.2e-09 |  | V_max | 6.3 |  | Dielectric | X5R
C23 | Capacitor (MLCC) | Any | 0603 | 0603 | 1759122 | 2 | £0.005 | Yes | 1 | £0.005 | Capacitance (F) | 1e-07 |  | V_max | 35 |  | Dielectric | X5R
LED1 | Red/Green LED, common cathode | Multicomp | MCL039PURGW | T1 - 3MM | 1581194 | 1.2 | £0.140 | No | 1 | £0.140
D1 | Power schottky diode | On Semi | MBRD835LG | 6.17x11.78MM DPAK | 9556249 | 1.2 | £0.166 | Yes | 1 | £0.166 | V_f @ 0.2A, 85C (V) |  | 0.4 | I_fmax (av.) (A) | 6.0 |  | Vr_max (V) | 30
D3,5 | Small-signal schottky diode | Fairchild | BAT54XV2 | SOD-523F | 2322476 | added 09/02/2013 | £0.025 | Yes | 2 | £0.049 | I_f_max (A) | 0.2 |  | V_r_repetitive (V) | 30
D4 | Power schottky diode | On Semi | NTS1545MFST | SO-8 FLAT | 2452050 | 1.2 | £0.180 | Maybe | 1 | £0.180
D2,6(A/B) | Dual schottky diode (common cathode) | Fairchild | BAT54C | SOT-23 | 1467518 | added 09/02/2013 | £0.026 | Yes | 2 | £0.052 | I_f_max (A) | 0.2 |  | V_r_repetitive (V) | 30
F1 | PTC resettable fuse | Bourns | MF-LSMF300/24X-2 | 2920 | 2057925 | 1.2 | £0.243 | No | 1 | £0.243
IC1 | Solar battery charge controller ASIC | TI | BQ24650 | QFN-16 | Digikey | 1.2 | £1.930 | No | 1 | £1.930
IC2 | 16bit - MCU | TI | MSP430G2432IPW20 | TSSOP-20 | 1866910 | 1.5 | £0.581 | No | 1 | £0.581
IC3 | Current sense monitor | TI | INA199A2DCKR | SC70-6 | Digikey | 1.2 | £0.274 | No | 1 | £0.274
IC4 | MCU power supply, 3.3V | TI | TPS71533DCKR | SC70-5 | 1135383 | added 09/02/2013 | £0.253 | No | 1 | £0.253
J1 | 6-pos terminal block, screw | Multicomp | MC000038 |  | 2008008 | 1.2 | £0.393 | Yes | 1 | £0.393 | Contacts | 6 |  | Current_max (A) | 15 |  | Min. wire size | 26AWG or thinner |  | Max. wire size | 12AWG or fatter
J2 | 3-pos male header | Samtec | TSW-103-17-T-S |  | Samtec | 2 | £0.104 | No | 1 | £0.104
J3,4 | 3-pos terminal block, screw | Multicomp | MC000027 |  | 2007996 | 1.2 | £0.183 | Yes | 2 | £0.366 | Contacts | 3 |  | Current_max (A) | 15 |  | Min. wire size | 26AWG or thinner |  | Max. wire size | 12AWG or fatter
L1 | Inductor | Any | 12.5mm x 12.5mm x 6.0mm | 12.5mm x 12.5mm x 6.0mm | 1864449 | 1.2 | £0.200 | Yes | 1 | £0.200 | Inductance (H) | 6.8e-06 |  | I_rms_max (A) | 4.5 |  | I_sat (A) | 5
Q1(A/B) | Dual N-channel Power MOSFET | Vishay Siliconix | Si7288DP | PowerPAK SO-8 | Digikey | 1.2 | £0.491 | No | 1 | £0.491
Q2,3 | Small-signal MOSFET | NXP | 2N7002 | SOT-23 | 1510761 | 1.2 | £0.019 | No | 2 | £0.038
Q4(A/B),5(A/B) | Dual NPN transistor | On Semi | BC846BDW1T1G | SOT-363 | 2317636 | 1.2 | £0.028 | No | 2 | £0.055
Q6 | P-channel Power MOSFET | Vishay | SI7157DP-T1-GE3 | PowerPAK SO-8 | 2471947 | 1.2 | £0.041 | Maybe | 1 | £0.041
R1 | Resistor | Any | 0603 | 0603 | 2059548 | 2 | £0.001 | Yes | 1 | £0.001 | Resistance (Ω) | 10 |  | Tolerance |  | 0.05
R2 | Resistor | Any | 0603 | 0603 | 9331620 | 2 | £0.005 | Yes | 1 | £0.005 | Resistance (Ω) | 91000 |  | Tolerance |  | 0.01
R3 | Resistor | Any | 0603 | 0603 | 2332014 | 2 | £0.004 | Yes | 1 | £0.004 | Resistance (Ω) | 6800 |  | Tolerance |  | 0.01
R4 | Resistor | Any | 0603 | 0603 | 1670209 | 2 | £0.037 | Yes | 1 | £0.037 | Resistance (Ω) | 300000 |  | Tolerance |  | 0.001
R5 | Resistor | Any | 0805 | 0805 | 1575985 | 2 | £0.039 | Yes | 1 | £0.039 | Resistance (Ω) | 53600 |  | Tolerance |  | 0.001
R6 | Resistor | Any | LRMAM1206-R01FT5 | 1206 | 2079442 | 2 | £0.081 | Yes | 1 | £0.081 | Resistance (Ω) | 0.01 |  | Tolerance |  | 0.01 | Power (W) | 1.0
R7,30 | Resistor | Any | 0603 | 0603 | 2059441 | 2 | £0.003 | Yes | 2 | £0.005 | Resistance (Ω) | 24000 |  | Tolerance |  | 0.01
R8 | Resistor | Any | 0603 | 0603 | 2303207 | 2 | £0.003 | Yes | 1 | £0.003 | Resistance (Ω) | 36000 |  | Tolerance |  | 0.01
R9 | Resistor | Any | 0603 | 0603 | 2447328 | 2 | £0.001 | Yes | 1 | £0.001 | Resistance (Ω) | 2.2 |  | Tolerance |  | 0.05
R10 | Resistor | Any | TLR3A20DR0015FTDG | 2010 | 2116014 | 2 | £0.255 | Yes | 1 | £0.255 | Resistance (Ω) | 0.0015 |  | Tolerance |  | 0.01 | Power (W) | 0.5
R11,12 | Resistor | Any | 0603 | 0603 | 2309107 | 2 | £0.002 | Yes | 2 | £0.004 | Resistance (Ω) | 100000 |  | Tolerance |  | 0.05
R13 | Resistor | Any | 0603 | 0603 | 2138612 | 2 | £0.003 | Yes | 1 | £0.003 | Resistance (Ω) | 1100000 |  | Tolerance |  | 0.01
R14 | Resistor | Any | 0603 | 0603 | 9238689 | 2 | £0.004 | Yes | 1 | £0.004 | Resistance (Ω) | 47000 |  | Tolerance |  | 0.01
R15 | Resistor | Any | 0603 | 0603 | 2502462 | 2 | £0.001 | Yes | 1 | £0.001 | Resistance (Ω) | 470 |  | Tolerance |  | 0.05
R16,20,21 | Resistor | Any | 0603 | 0603 | 2502463 | 2 | £0.001 | Yes | 3 | £0.004 | Resistance (Ω) | 4700 |  | Tolerance |  | 0.05
R17 | Resistor | Any | 0603 | 0603 | 2502453 | 2 | £0.001 | Yes | 1 | £0.001 | Resistance (Ω) | 3600 |  | Tolerance |  | 0.01
R18 | Resistor | Any | 0603 | 0603 | 2502431 | 2 | £0.001 | Yes | 1 | £0.001 | Resistance (Ω) | 2200 |  | Tolerance |  | 0.01
R19 | Resistor | Any | 0603 | 0603 | 2502414 | 2 | £0.001 | Yes | 1 | £0.001 | Resistance (Ω) | 15000 |  | Tolerance |  | 0.01
R22,23 | Resistor | Any | 0603 | 0603 | 2309107 | 2 | £0.002 | Yes | 2 | £0.004 | Resistance (Ω) | 100000 |  | Tolerance |  | 0.01
R24,25,26 | Resistor | Any | 0603 | 0603 | 2303192 | 2 | £0.003 | Yes | 3 | £0.010 | Resistance (Ω) | 10000 |  | Tolerance |  | 0.01
R27 | Resistor | Any | 0603 | 0603 | 2303145 | 2 | £0.003 | Yes | 1 | £0.003 | Resistance (Ω) | 1000 |  | Tolerance |  | 0.01
R28 | Resistor | Any | 0805 | 0805 | 1653287 | 2 | £0.057 | Yes | 1 | £0.057 | Resistance (Ω) | 1000000 |  | Tolerance |  | 0.001
R29 | Resistor | Any | 0603 | 0603 | 1653254 | 2 | £0.057 | Yes | 1 | £0.057 | Resistance (Ω) | 100000 |  | Tolerance |  | 0.001
Q6X | P-channel Power MOSFET | Vishay Siliconix | SI4425DDY-T1-GE3 |  | Digikey | 1 | £0.240 | Maybe | 1
Q6X | P-channel Power MOSFET | Alpha & Omega | AON6413 |  | Digikey | 1 | £0.160 | Maybe | 1
Q6X | P-channel Power MOSFET | Vishay Siliconix | SI7149ADP-T1-GE3 |  | Digikey | 1 | £0.240 | Maybe | 1
Q6X | P-channel Power MOSFET | IR | IRF9317PBF |  | 1831074 | 1 | £0.487 | Maybe | 1
 | Big testing resistor! |  |  |  | 1259469 | 1 |  |  | 2
 | LED washer |  |  |  | 7047526 | 1 |  |  | 1
 | LED for hallway |  |  |  | 2336358 | 1 |  |  | 1
 | Solder paste |  |  |  | Digikey | 1 |  |  | 1
 | Solder scraper |  |  |  | 7167131 | 1 |  |  | 1
 | Magnifier |  |  |  | 1702971 | 1 |  |  | 1
 | Temperature laser gun (for monitoring frying) |  |  |  | 1836064 | 1 |  |  | 1
 | Temperature probes (for monitoring air gun, and heat tests) |  |  |  | 1438760 | 1 |  |  | 4
 | Acetone or other solvent |  |  |  | 1206535 | 1 |  |  | 1
 | Anti static wristband |  |  |  | 1521281 | 1 |  |  | 1
 | Earth bonding plug |  |  |  | 1687854 | 1 |  |  | 1
 | Scalpel blades |  |  |  | 2132071 | 1 |  |  | 1
 | Heat gun |  |  |  | 1358645 | 1 |  |  | 1

Sheet: BOM_spec (Farnell)
BOM Specification
Part ID | Part description | Manufacturer | Part number | Proto OC | Order margin | Est. unit cost (1000 units) | Replacable? | PCS | Est. total cost (1000 units) | Spec 1 | Value (min) | Value (max) | Spec 2 | Value (min) | Value (max) | Spec 3 | Value (min) | Value (max) | Spec 4 | Value (min) | Value (max) | Spec 5 | Value (min) | Value (max)
C1,13,14,19 | Capacitor (MLCC) | Any | 0603 | 2211179 | 2 | £0.027 | Yes | 4 | £0.107 | Capacitance (F) | 1e-06 |  | V_max | 35 | 0 | Dielectric | X5R | 0 | 0 | 0 | 0.0 | 0 | 0 | 0
C2,10 | Capacitor (MLCC) | Any | 0603 | 2211179 | 2 | £0.007 | Yes | 2 | £0.013 | Capacitance (F) | 1e-06 |  | V_max | 15 | 0 | Dielectric | X5R | 0.0 | 0 | 0 | 0.0 | 0 | 0 | 0
C3,12 | Capacitor (MLCC) | Any | 0603 | 2309012 | 2 | £0.004 | Yes | 2 | £0.007 | Capacitance (F) | 2.2e-11 |  | V_max | 35 | 0 | Dielectric | X5R | 0 | 0 | 0 | 0 | 0 | 0 | 0
C4,5 | Capacitor (MLCC) | Murata | GRM31CR6YA106KA12L | 1797011 | 2 | £0.125 | No | 2 | £0.250 | Capacitance (F) | 1e-05 |  | V_max | 35 | 0 | Dielectric | X5R | 0 | I_rms_max (@600kHz) (A) | 0.267 | 0 | 0 | 0 | 0
C6,7 | Capacitor (MLCC) | Murata | GRM31CR6YA106KA12L | 1797011 | 2 | £0.125 | No | 2 | £0.250 | Capacitance (F) | 1e-05 |  | V_max | 35 | 0 | Dielectric | X5R | 0 | I_rms_max (@600kHz) (A) | 1.667 | 0 | 0 | 0 | 0
C8,9,00 | Capacitor (MLCC) | Any | 0603 | 1759037 | 2 | £0.003 | Yes | 3 | £0.009 | Capacitance (F) | 1e-07 |  | V_max | 15 | 0% | Dielectric | X5R | 0 | 0 | 0 | 0 | 0 | 0 | 0
C11 | Capacitor (MLCC) | Any | 0603 | 2211185 | 2 | £0.036 | Yes | 1 | £0.036 | Capacitance (F) | 2.2e-06 |  | V_max | 35 | 0% | Dielectric | X5R | 0 | 0 | 0 | 0 | 0 | 0 | 0
C15 | Capacitor (MLCC) | Any | 0603 | 2320814 | 2 | £0.018 | Yes | 1 | £0.018 | Capacitance (F) | 1e-06 |  | V_max | 6.3 | 0% | Dielectric | X5R | 0 | 0 | 0 | 0 | 0 | 0 | 0
C16,18,20,21,22 | Capacitor (MLCC) | Any | 0603 | 1759016 | 2 | £0.003 | Yes | 5 | £0.015 | Capacitance (F) | 1e-07 |  | V_max | 6.3 | 0% | Dielectric | X5R | 0 | 0 | 0 | 0 | 0 | 0 | 0
C17 | Capacitor (MLCC) | Any | 0603 | 1759093 | 2 | £0.005 | Yes | 1 | £0.005 | Capacitance (F) | 2.2e-09 |  | V_max | 6.3 | 0% | Dielectric | X5R | 0 | 0 | 0 | 0 | 0 | 0 | 0
C23 | Capacitor (MLCC) | Any | 0603 | 1759122 | 2 | £0.005 | Yes | 1 | £0.005 | Capacitance (F) | 1e-07 |  | V_max | 35 | 0% | Dielectric | X5R | 0 | 0 | 0 | 0 | 0 | 0 | 0
LED1 | Red/Green LED, common cathode | Multicomp | MCL039PURGW | 1581194 | 1.2 | £0.140 | No | 1 | £0.140 | 0 | 0 | 0 | 0 | 0 | 0 | 0 | 0 | 0 | 0 | 0 | 0.0 | 0 | 0 | 0.0
D1 | Power schottky diode | On Semi | MBRD835LG | 9556249 | 1.2 | £0.166 | Yes | 1 | £0.166 | V_f @ 0.2A, 85C (V) | 0 | 0.4 | I_fmax (av.) (A) | 6.0 | 0 | Vr_max (V) | 30 | 0 | 0 | 0 | 0 | 0 | 0 | 0
D3,5 | Small-signal schottky diode | Fairchild | BAT54XV2 | 2322476 | added 09/02/2013 | £0.025 | Yes | 2 | £0.049 | I_f_max (A) | 0.2 | 0 | V_r_repetitive (V) | 30 | 0 | 0 | 0 | 0 | 0 | 0 | 0.0 | 0 | 0 | 0.0
D4 | Power schottky diode | On Semi | NTS1545MFST | 2452050 | 1.2 | £0.180 | Maybe | 1 | £0.180 | 0 | 0 | 0 | 0 | 0 | 0 | 0 | 0 | 0 | 0 | 0 | 0.0 | 0 | 0 | 0.0
F1 | PTC resettable fuse | Bourns | MF-LSMF300/24X-2 | 2057925 | 1.2 | £0.243 | No | 1 | £0.243 | 0 | 0 | 0 | 0 | 0 | 0 | 0 | 0 | 0 | 0 | 0 | 0.0 | 0 | 0 | 0.0
IC2 | 16bit - MCU | TI | MSP430G2432IPW20 | 1866910 | 1.5 | £0.581 | No | 1 | £0.581 | 0 | 0 | 0 | 0 | 0 | 0 | 0 | 0 | 0 | 0 | 0 | 0.0 | 0 | 0 | 0.0
J1 | 6-pos terminal block, screw | Multicomp | MC000038 | 2008008 | 1.2 | £0.393 | Yes | 1 | £0.393 | Contacts | 6 |  | Current_max (A) | 15 | 0 | Min. wire size | 26AWG or thinner |  | Max. wire size | 12AWG or fatter |  | 0 | 0 | 0.0
J3,4 | 3-pos terminal block, screw | Multicomp | MC000027 | 2007996 | 1.2 | £0.183 | Yes | 2 | £0.366 | Contacts | 3 |  | Current_max (A) | 15 | 0 | Min. wire size | 26AWG or thinner |  | Max. wire size | 12AWG or fatter |  | 0 | 0 | 0.0
L1 | Inductor | Any | 12.5mm x 12.5mm x 6.0mm | 1864449 | 1.2 | £0.200 | Yes | 1 | £0.200 | Inductance (H) | 6.8e-06 | 0 | I_rms_max (A) | 4.5 | 0 | I_sat (A) | 5 | 0 | 0 | 0 | 0.0 | 0 | 0 | 0.0
Q2,3 | Small-signal MOSFET | NXP | 2N7002 | 1510761 | 1.2 | £0.019 | No | 2 | £0.038 | 0 | 0 | 0 | 0 | 0 | 0% | 0 | 0.000 | 0 | 0 | 0 | 0 | 0 | 0 | 0
Q4(A/B),5(A/B) | Dual NPN transistor | On Semi | BC846BDW1T1G | 2317636 | 1.2 | £0.028 | No | 2 | £0.055 | 0 | 0 | 0 | 0 | 0 | 0% | 0 | 0.000 | 0 | 0 | 0 | 0 | 0 | 0 | 0
Q6 | P-channel Power MOSFET | Vishay | SI7157DP-T1-GE3 | 2471947 | 1.2 | £0.041 | Maybe | 1 | £0.041 | 0 | 0 | 0 | 0 | 0 | 0% | 0 | 0.000 | 0 | 0 | 0 | 0 | 0 | 0 | 0
R1 | Resistor | Any | 0603 | 2059548 | 2 | £0.001 | Yes | 1 | £0.001 | Resistance (Ω) | 10 |  | Tolerance | 0 | 0.05 | 0 | 0 | 0.0 | 0 | 0 | 0.0 | 0 | 0 | 0
R2 | Resistor | Any | 0603 | 9331620 | 2 | £0.005 | Yes | 1 | £0.005 | Resistance (Ω) | 91000 |  | Tolerance | 0 | 0.01 | 0 | 0 | 0 | 0 | 0 | 0 | 0 | 0 | 0
R3 | Resistor | Any | 0603 | 2332014 | 2 | £0.004 | Yes | 1 | £0.004 | Resistance (Ω) | 6800 |  | Tolerance | 0 | 0.01 | 0 | 0 | 0 | 0 | 0 | 0 | 0 | 0 | 0
R4 | Resistor | Any | 0603 | 1670209 | 2 | £0.037 | Yes | 1 | £0.037 | Resistance (Ω) | 300000 |  | Tolerance | 0 | 0.001 | 0 | 0 | 0 | 0 | 0 | 0 | 0 | 0 | 0
R5 | Resistor | Any | 0805 | 1575985 | 2 | £0.039 | Yes | 1 | £0.039 | Resistance (Ω) | 53600 |  | Tolerance | 0 | 0.001 | 0 | 0 | 0 | 0 | 0 | 0 | 0 | 0 | 0
R6 | Resistor | Any | LRMAM1206-R01FT5 | 2079442 | 2 | £0.081 | Yes | 1 | £0.081 | Resistance (Ω) | 0.01 |  | Tolerance | 0 | 0.01 | Power (W) | 1 | 0 | 0 | 0 | 0 | 0 | 0 | 0
R7,30 | Resistor | Any | 0603 | 2059441 | 2 | £0.003 | Yes | 2 | £0.005 | Resistance (Ω) | 24000 |  | Tolerance | 0 | 0.01 | 0 | 0 | 0 | 0 | 0 | 0 | 0 | 0 | 0
R8 | Resistor | Any | 0603 | 2303207 | 2 | £0.003 | Yes | 1 | £0.003 | Resistance (Ω) | 36000 |  | Tolerance | 0 | 0.01 | 0 | 0 | 0 | 0 | 0 | 0 | 0 | 0 | 0
R9 | Resistor | Any | 0603 | 2447328 | 2 | £0.001 | Yes | 1 | £0.001 | Resistance (Ω) | 2.2 |  | Tolerance | 0 | 0.05 | 0 | 0 | 0 | 0 | 0 | 0 | 0 | 0 | 0
R10 | Resistor | Any | TLR3A20DR0015FTDG | 2116014 | 2 | £0.255 | Yes | 1 | £0.255 | Resistance (Ω) | 0.0015 |  | Tolerance | 0 | 0.01 | Power (W) | 0.5 | 0 | 0 | 0 | 0 | 0 | 0 | 0
R11,12 | Resistor | Any | 0603 | 2309107 | 2 | £0.002 | Yes | 2 | £0.004 | Resistance (Ω) | 100000 |  | Tolerance | 0 | 0.05 | 0 | 0 | 0 | 0 | 0 | 0 | 0 | 0 | 0
R13 | Resistor | Any | 0603 | 2138612 | 2 | £0.003 | Yes | 1 | £0.003 | Resistance (Ω) | 1100000 |  | Tolerance | 0 | 0.01 | 0 | 0 | 0 | 0 | 0 | 0 | 0 | 0 | 0
R14 | Resistor | Any | 0603 | 9238689 | 2 | £0.004 | Yes | 1 | £0.004 | Resistance (Ω) | 47000 |  | Tolerance | 0 | 0.01 | 0 | 0 | 0 | 0 | 0 | 0 | 0 | 0 | 0
R15 | Resistor | Any | 0603 | 2502462 | 2 | £0.001 | Yes | 1 | £0.001 | Resistance (Ω) | 470 |  | Tolerance | 0 | 0.05 | 0 | 0 | 0 | 0 | 0 | 0 | 0 | 0 | 0
R16,20,21 | Resistor | Any | 0603 | 2502463 | 2 | £0.001 | Yes | 3 | £0.004 | Resistance (Ω) | 4700 |  | Tolerance | 0 | 0.05 | 0 | 0 | 0 | 0 | 0 | 0 | 0 | 0 | 0
R17 | Resistor | Any | 0603 | 2502453 | 2 | £0.001 | Yes | 1 | £0.001 | Resistance (Ω) | 3600 |  | Tolerance | 0 | 0.01 | 0 | 0 | 0 | 0 | 0 | 0 | 0 | 0 | 0
R18 | Resistor | Any | 0603 | 2502431 | 2 | £0.001 | Yes | 1 | £0.001 | Resistance (Ω) | 2200 |  | Tolerance | 0 | 0.01 | 0 | 0 | 0 | 0 | 0 | 0 | 0 | 0 | 0
R19 | Resistor | Any | 0603 | 2502414 | 2 | £0.001 | Yes | 1 | £0.001 | Resistance (Ω) | 15000 |  | Tolerance | 0 | 0.01 | 0 | 0 | 0 | 0 | 0 | 0 | 0 | 0 | 0
#REF! | #REF! | #REF! | #REF! | #REF! | #REF! | #REF! | #REF! | #REF! | #REF! | #REF! | #REF! |  | #REF! | #REF! | #REF! | #REF! | #REF! | #REF! | #REF! | #REF! | #REF! | #REF! | #REF! | #REF!
R24,25,26 | Resistor | Any | 0603 | 2303192 | 2 | £0.003 | Yes | 3 | £0.010 | Resistance (Ω) | 10000 |  | Tolerance | 0 | 0.01 | 0 | 0 | 0 | 0 | 0 | 0 | 0 | 0 | 0
R22,23 | Resistor | Any | 0603 | 2309107 | 2 | £0.002 | Yes | 2 | £0.004 | Resistance (Ω) | 100000 |  | Tolerance | 0 | 0.01 | 0 | 0 | 0 | 0 | 0 | 0 | 0 | 0 | 0
R27 | Resistor | Any | 0603 | 2303145 | 2 | £0.003 | Yes | 1 | £0.003 | Resistance (Ω) | 1000 |  | Tolerance | 0 | 0.01 | 0 | 0 | 0 | 0 | 0 | 0 | 0 | 0 | 0
R28 | Resistor | Any | 0805 | 1653287 | 2 | £0.057 | Yes | 1 | £0.057 | Resistance (Ω) | 1000000 |  | Tolerance | 0 | 0.001 | 0 | 0 | 0 | 0 | 0 | 0 | 0 | 0 | 0
R29 | Resistor | Any | 0603 | 1653254 | 2 | £0.057 | Yes | 1 | £0.057 | Resistance (Ω) | 100000 |  | Tolerance | 0 | 0.001 | 0 | 0 | 0 | 0 | 0 | 0 | 0 | 0 | 0
 | P-channel Power MOSFET |  |  | 1831074 | 1 |  |  | 1
 | Big testing resistor! |  |  | 1259469 | 1 |  |  | 2
 | LED washer |  |  | 7047526 | 1 |  |  | 1
 | LED for hallway |  |  | 2336358 | 1 |  |  | 1
 | Solder scraper |  |  | 7167131 | 1 |  |  | 1
 | Magnifier |  |  | 1702971 | 1 |  |  | 1
 | Temperature laser gun (for monitoring frying) |  |  | 1836064 | 1 |  |  | 1
 | Temperature probes (for monitoring air gun, and heat tests) |  |  | 1438760 | 1 |  |  | 4
 | Acetone or other solvent |  |  | 1206535 | 1 |  |  | 1
 | Anti static wristband |  |  | 1521281 | 1 |  |  | 1
 | Earth bonding plug |  |  | 1687854 | 1 |  |  | 1
 | Scalpel blades |  |  | 2132071 | 1 |  |  | 1
 | Heat gun |  |  | 1358645 | 1 |  |  | 1

Sheet: Farnell Order
 | PCS w/Margin | Match? | Line No. | Order Code | RoHS Compliant? | Notes | Qty | Manufacturer Part Number | Manufacturer / Description | Availability | Unit Price | Line Price | Scaled price | Scale | 4
2211179 | 48 |  | 1 | 2211179 | YES |  | 50 | C1608X5R1H105K080AB | Product Range:C Series; Capacitance:1ÂµF; Capacitance Tolerance:Â± 10%; Dielectric Characteristic:X5R; Voltage Rating:50V; Ceramic Capacitor Case:0603 [1608 Metric]; Operating Temperature Mi | 77130 | 0.0536 | 2.68 | 2.68 | Total Farnell | #VALUE!
2309012 | 16 |  | 2 | 2309012 | YES |  | 16 | MC0603N220K500CT | Product Range:MC Series; Capacitance:22pF; Capacitance Tolerance:Â± 10%; Dielectric Characteristic:C0G / NP0; Voltage Rating:50V; Ceramic Capacitor Case:0603 [1608 Metric]; Operating T | 72406 | 0.0046 | 0.07 | 0.07 | Total Digikey | 65.32
1797011 | 32 |  | 3 | 1797011 | YES |  | 40 | GRM31CR6YA106KA12L | Product Range:GRM Series; Capacitance:10ÂµF; Capacitance Tolerance:Â± 10%; Dielectric Characteristic:X5R; Voltage Rating:35V; Ceramic Capacitor Case:1206 [3216 Metric]; Operating Temperatur | 26019 | 0.364 | 14.56 | 14.56 | Total | #VALUE!
1759037 | 24 |  | 4 | 1759037 | YES |  | 20 | MC0603B104K250CT | Product Range:MC Series; Capacitance:0.1ÂµF; Capacitance Tolerance:Â± 10%; Dielectric Characteristic:X7R; Voltage Rating:25V; Ceramic Capacitor Case:0603 [1608 Metric]; Operating Temperatu | 150266 | 0.0062 | 0.12 | 0.15
2211185 | 8 |  | 5 | 2211185 | YES |  | 10 | C1608X5R1V225K080AC | Product Range:C Series; Capacitance:2.2ÂµF; Capacitance Tolerance:Â± 10%; Dielectric Characteristic:X5R; Voltage Rating:35V; Ceramic Capacitor Case:0603 [1608 Metric]; Operating Temperatur | 62686 | 0.0851 | 0.85 | 0.85
2320814 | 8 |  | 6 | 2320814 | YES |  | 10 | MC0603B105K160CT | Product Range:MC Series; Capacitance:1ÂµF; Capacitance Tolerance:Â± 10%; Dielectric Characteristic:X7R; Voltage Rating:16V; Ceramic Capacitor Case:0603 [1608 Metric]; Operating Temperature M | 14577 | 0.0321 | 0.32 | 0.32
1759016 | 40 |  | 7 | 1759016 | YES |  | 30 | MC0603B104K160CT | Product Range:MC Series; Capacitance:0.1ÂµF; Capacitance Tolerance:Â± 10%; Dielectric Characteristic:X7R; Voltage Rating:16V; Ceramic Capacitor Case:0603 [1608 Metric]; Operating Temperatu | 6857 | 0.0062 | 0.19 | 0.25
1759093 | 8 |  | 8 | 1759093 | YES |  | 10 | MC0603B222K500CT | Product Range:MC Series; Capacitance:2200pF; Capacitance Tolerance:Â± 10%; Dielectric Characteristic:X7R; Voltage Rating:50V; Ceramic Capacitor Case:0603 [1608 Metric]; Operating Temperat | 86669 | 0.0085 | 0.09 | 0.09
1759122 | 8 |  | 9 | 1759122 | YES |  | 30 | MC0603B104K500CT | Product Range:MC Series; Capacitance:0.1ÂµF; Capacitance Tolerance:Â± 10%; Dielectric Characteristic:X7R; Voltage Rating:50V; Ceramic Capacitor Case:0603 [1608 Metric]; Operating Temperatu | 483850 | 0.0083 | 0.25 | 0.25
1581194 | 5 |  | 10 | 1581194 | YES |  | 5 | MCL039PURGW | Bulb Size:T-1 (3mm); LED Colour:Green, Red; Luminous Intensity / Colour:R 30mcd, G 10mcd; Viewing Angle:76Â°; Forward Voltage / Colour:R 1.8V, G 2.1V; Forward Current / Colour:R 20mA, G | 78010 | 0.252 | 1.26 | 1.26
9556249 | 5 |  | 11 | 9556249 | YES |  | 5 | MBRD835LG | Diode Configuration:Single; Repetitive Reverse Voltage Vrrm Max:35V; Forward Current If(AV):8A; Forward Voltage VF Max:510mV; Forward Surge Current Ifsm Max:75A; Operating Temperature Max:150Â°C; | 14807 | 0.395 | 1.98 | 1.98
2322476 | #VALUE! | ERR | 12 | 1431105 | YES |  | 15 | BAS19LT1G | Diode Configuration:-; Repetitive Reverse Voltage Vrrm Max:120V; Forward Current If(AV):200mA; Forward Voltage VF Max:1.25V; Reverse Recovery Time trr Max:50ns; Forward Surge Current Ifsm Max | 11505 | 0.0197 | 0.3 | #VALUE!
2452050 | 5 |  | 13 | 2452050 | YES |  | 5 | NTS1545MFST1G | Diode Configuration:Single; Repetitive Reverse Voltage Vrrm Max:45V; Forward Current If(AV):15A; Forward Voltage VF Max:570mV; Forward Surge Current Ifsm Max:210A; Operating Temperature Max:150Â°C; D | 2878 | 0.357 | 1.79 | 1.79
2057925 | 5 |  | 14 | 2057925 | YES |  | 5 | MF-LSMF300/24X-2 | Holding Current:3A; Tripping Current:5.2A; Carrying Current Max:20A; Initial Resistance Max:0.075ohm; Operating Voltage:24V; PTC Fuse Case Style:SMD; SVHC:No SVHC (17-Dec-2014); Appro | 3523 | 0.611 | 3.06 | 3.06
1866910 | 6 |  | 15 | 1866910 | YES |  | 6 | MSP430G2432IPW20 | TEXAS INSTRUMENTS-MSP430G2432IPW20-MCU, 16BIT, MSP430, 16MHZ, TSSOP-20 | 776 | 0.8815 | 5.29 | 5.29
2008008 | 5 |  | 16 | 2008008 | YES |  | 5 | MC000038 | MULTICOMP-MC000038-TERMINAL BLOCK, WIRE TO BRD, 6POS, 12AWG | 5778 | 0.625 | 3.13 | 3.13
2007996 | 10 |  | 17 | 2007996 | YES |  | 10 | MC000027 | MULTICOMP-MC000027-TERMINAL BLOCK, WIRE TO BRD, 3POS, 12AWG | 1077 | 0.653 | 6.53 | 6.53
1864449 | 5 |  | 18 | 1864449 | YES |  | 5 | MCSDRH125B-6R8MHF | Product Range:MCSDRH125B Series; Inductance:6.8ÂµH; Inductance Tolerance:Â± 20%; Inductor Construction:Shielded; DC Resistance Max:0.; Available until stocks are exhausted Alternative available | 340 (Available until stock is exhausted) | 0.28 | 1.4 | 1.40
1510761 | 10 |  | 19 | 1510761 | YES |  | 10 | 2N7002,215 | NXP-2N7002,215-MOSFET,N CH, 60V,0.3A,SOT23 | 170178 | 0.0235 | 0.24 | 0.24
2317636 | 10 |  | 20 | 2317636 | YES |  | 10 | BC846BDW1T1G | ON SEMICONDUCTOR-BC846BDW1T1G-TRANSISTOR, NPN, 65V, 100MA, SOT-363-6 | 14870 | 0.0384 | 0.38 | 0.38
2471947 | 5 |  | 21 | 2471947 | YES |  | 5 | SI7157DP-T1-GE3 | MSL:MSL 1 - Unlimited; Continuous Drain Current Id:-60A; Drain Source Voltage Vds:-20V; No. of Pins:8; On Resistance Rds(on):0.00125ohm; Operating Temperature Max:150Â°C; Power Dis | 6488 | 0.089 | 0.45 | 0.45
2059548 | 8 |  | 22 | 2059548 | YES |  | 50 | ERJ3GEYJ100V | Product Range:AEC-Q200 ERJ Series; Resistance:10ohm; Power Rating:100mW; Resistance Tolerance:Â± 5%; Voltage Rating:75V; Resistor Case Style:0603 [1608 Metric]; Packaging:Cut Tape; Resistor E | 150 | 0.006 | 0.3 | 0.30
9331620 | 8 |  | 23 | 9331620 | Y-EX |  | 10 | MC0063W0603191K | Product Range:MC Series; Resistance:91kohm; Power Rating:63mW; Resistance Tolerance:Â± 1%; Voltage Rating:50V; Resistor Case Style:0603 [1608 Metric]; Packaging:Cut Tape; Resistor Element | 1984 | 0.01 | 0.1 | 0.10
2332014 | 8 |  | 24 | 2332014 | YES |  | 10 | CRGH0603F6K8 | Product Range:CRG Series; Resistance:6.8kohm; Power Rating:200mW; Resistance Tolerance:Â± 1%; Voltage Rating:50V; Resistor Case Style:0603 [1608 Metric]; Packaging:Cut Tape; Resistor | 2300 | 0.0089 | 0.09 | 0.09
1670209 | 8 |  | 25 | 1670209 | YES |  | 10 | ERA3AEB304V | Product Range:AEC-Q200 ERA Series; Resistance:300kohm; Power Rating:100mW; Resistance Tolerance:Â± 0.1%; Voltage Rating:75V; Resistor Case Style:0603 [1608 Metric]; Packaging:Cut Tape; Re | 1166 | 0.177 | 1.77 | 1.77
1575985 | 8 |  | 26 | 1575985 | Y-EX |  | 10 | MCTC0525B5362T5E | Product Range:TC05 Series; Resistance:53.6kohm; Power Rating:100mW; Resistance Tolerance:Â± 0.1%; Voltage Rating:100V; Resistor Case Style:0805 [2012 Metric]; Packaging:Cut Tape; Resi | 2758 | 0.0568 | 0.57 | 0.57
2079442 | 8 |  | 27 | 2079442 | YES |  | 10 | LRMAM1206-R01FT5 | Product Range:AEC-Q200 LRMA Series; Resistance:0.01ohm; Power Rating:1W; Resistance Tolerance:Â± 1%; Voltage Rating:-; Resistor Case Style:1206 [3216 Metric]; Packaging:Each; Resistor Elem | 6411 | 0.236 | 2.36 | 2.36
2059441 | 16 |  | 28 | 2059441 | YES |  | 50 | ERJ3EKF2402V | Product Range:AEC-Q200 ERJ Series; Resistance:24kohm; Power Rating:100mW; Resistance Tolerance:Â± 1%; Voltage Rating:75V; Resistor Case Style:0603 [1608 Metric]; Packaging:Cut Tape; Resistor | 23799 | 0.007 | 0.35 | 0.35
2303207 | 8 |  | 29 | 2303207 | YES |  | 10 | ERJ3EKF3602V | Product Range:AEC-Q200 ERJ Series; Resistance:36kohm; Power Rating:100mW; Resistance Tolerance:Â± 1%; Voltage Rating:75V; Resistor Case Style:0603 [1608 Metric]; Packaging:Cut Tape; | 2165 | 0.007 | 0.07 | 0.07
2447328 | 8 |  | 30 | 2447328 | YES |  | 10 | MCWR06W2R20FTL | Product Range:MCWR Series; Resistance:2.2ohm; Power Rating:100mW; Resistance Tolerance:Â± 1%; Voltage Rating:50V; Resistor Case Style:0603 [1608 Metric]; Packaging:Cut Tape; Resistor Ele | 9000 | 0.0013 | 0.01 | 0.01
2116014 | 8 | ERR | 31 | 2332254 | YES |  | 8 | TLR2H15DR001FTDG | Product Range:TLR Series; Resistance:0.001ohm; Power Rating:1.5W; Resistance Tolerance:Â± 1%; Voltage Rating:-; Resistor Case Style:2010 [5025 Metric]; Packaging:Each; Resistor Eleme | 1087 | 0.396 | 3.17 | 3.17
2309107 | 32 |  | 32 | 2309107 | Y-EX |  | 32 | RC0603FR-13100KL | Product Range:RC Series; Resistance:100kohm; Power Rating:100mW; Resistance Tolerance:Â± 1%; Voltage Rating:50V; Resistor Case Style:0603 [1608 Metric]; Packaging:Cut Tape; Resist | 6069 | 0.0027 | 0.09 | 0.09
2138612 | 8 |  | 33 | 2138612 | Y-EX |  | 10 | CRCW06031M10FKEA | Product Range:AEC-Q200 CRCW Series; Resistance:1.1Mohm; Power Rating:100mW; Resistance Tolerance:Â± 1%; Voltage Rating:75V; Resistor Case Style:0603 [1608 Metric]; Packaging:Cut Tape | 1150 | 0.0076 | 0.08 | 0.08
9238689 | 8 |  | 34 | 9238689 | YES |  | 10 | RC0603FR-0747KL | Product Range:RC Series; Resistance:47kohm; Power Rating:100mW; Resistance Tolerance:Â± 1%; Voltage Rating:50V; Resistor Case Style:0603 [1608 Metric]; Packaging:Cut Tape; Resistor Element Materi | 67377 | 0.0057 | 0.06 | 0.06
2502462 | 8 | ERR | 35 | 2059614 | YES |  | 50 | ERJ3GEYJ332V | Product Range:AEC-Q200 ERJ Series; Resistance:3.3kohm; Power Rating:100mW; Resistance Tolerance:Â± 5%; Voltage Rating:75V; Resistor Case Style:0603 [1608 Metric]; Packaging:Cut Tape; Resistor | 9187 | 0.006 | 0.3 | 0.30
2502463 | 24 | ERR | 36 | 9238662 | YES |  | 10 | RC0603FR-0733KL | Product Range:RC Series; Resistance:33kohm; Power Rating:100mW; Resistance Tolerance:Â± 1%; Voltage Rating:50V; Resistor Case Style:0603 [1608 Metric]; Packaging:Cut Tape; Resistor Element Materi | 2756 | 0.0059 | 0.06 | 0.14
2502453 | 8 | ERR | 37 | 9331310 | Y-EX |  | 10 | MC0063W0603151K | Product Range:MC Series; Resistance:51kohm; Power Rating:63mW; Resistance Tolerance:Â± 1%; Voltage Rating:50V; Resistor Case Style:0603 [1608 Metric]; Packaging:Cut Tape; Resistor Element | 7038 | 0.01 | 0.1 | 0.10
2502431 | 8 | ERR | 38 | 2332019 | YES |  | 10 | CRGH0603F18K | Product Range:CRG Series; Resistance:18kohm; Power Rating:200mW; Resistance Tolerance:Â± 1%; Voltage Rating:50V; Resistor Case Style:0603 [1608 Metric]; Packaging:Cut Tape; Resistor E | 2700 | 0.0089 | 0.09 | 0.09
2502414 | 8 | ERR | 39 | 2138424 | Y-EX |  | 10 | CRCW060311K0FKEA | Product Range:AEC-Q200 CRCW Series; Resistance:11kohm; Power Rating:100mW; Resistance Tolerance:Â± 1%; Voltage Rating:75V; Resistor Case Style:0603 [1608 Metric]; Packaging:Cut Tape; Resistor Elem | 7770 | 0.0096 | 0.1 | 0.10
#REF! | #REF! | #REF! | 40 | 2332013 | YES |  | 10 | CRGH0603F5K6 | Product Range:CRG Series; Resistance:5.6kohm; Power Rating:200mW; Resistance Tolerance:Â± 1%; Voltage Rating:50V; Resistor Case Style:0603 [1608 Metric]; Packaging:Cut Tape; Resistor | 3558 | 0.0089 | 0.09 | #REF!
2303192 | 24 |  | 41 | 2303192 | YES |  | 40 | ERJ3EKF1002V | Product Range:AEC-Q200 ERJ Series; Resistance:10kohm; Power Rating:100mW; Resistance Tolerance:Â± 1%; Voltage Rating:75V; Resistor Case Style:0603 [1608 Metric]; Packaging:Cut Tape; | 110830 | 0.007 | 0.28 | 0.28
2303145 | 8 |  | 42 | 2303145 | YES |  | 10 | ERJ3EKF1001V | Product Range:AEC-Q200 ERJ Series; Resistance:1kohm; Power Rating:100mW; Resistance Tolerance:Â± 1%; Voltage Rating:75V; Resistor Case Style:0603 [1608 Metric]; Packaging:Cut Tape; Re | 38650 | 0.007 | 0.07 | 0.07
1653287 | 8 |  | 43 | 1653287 | YES |  | 8 | RR1220P-105-B-T5 | Product Range:RR Series; Resistance:1Mohm; Power Rating:100mW; Resistance Tolerance:Â± 0.1%; Voltage Rating:100V; Resistor Case Style:0805 [2012 Metric]; Packaging:Cut Tape; Resistor Element Mater | 6084 | 0.0812 | 0.65 | 0.65
1653254 | 8 |  | 44 | 1653254 | YES |  | 8 | RR0816P-104-B-T5 | Product Range:RR Series; Resistance:100kohm; Power Rating:63mW; Resistance Tolerance:Â± 0.1%; Voltage Rating:75V; Resistor Case Style:0603 [1608 Metric]; Packaging:Cut Tape; Resis | 26714 | 0.0812 | 0.65 | 0.65
1831074 | 4 |  | 45 | 1831074 | YES |  | 4 | IRF9317PBF | INTERNATIONAL RECTIFIER-IRF9317PBF-MOSFET,P CH,30V,16A,SO-8 | 3655 | 1.39 | 5.56 | 5.56
1259469 | 2 |  | 46 | 1259469 | YES |  | 2 | THS503R3J | Product Range:THS Series; Resistance:3.3ohm; Power Rating:50W; Resistance Tolerance:Â± 5%; Voltage Rating:1.25kV; Resistor Case Style:Axial Leaded; Resistor Element Material:Wirewound; Tempe | 133 | 3.48 | 6.96 | 6.96
7047526 | 1 |  | 47 | 7047526 | YES |  | 1 | 110770 | DURATOOL-0110770-WASHER, FLAT, NYLON, M8, PK50 | 99 | 2.45 | 2.45 | 2.45
2336358 | 1 |  | 48 | 2336358 | YES |  | 1 | LXR9-SW27 | Product Range:LUXEON M Series; LED Colour:White; CCT:2700K; Luminous Flux @ Test:610lm; Forward Current @ Test:700mA; Forward Current If Max:1.05A; Forward Voltage @ Test:12V; Vie | 354 | 7.96 | 7.96 | 7.96
7167131 | 1 |  | 49 | 7167131 | NA |  | 1 | T5075 2 | CK TOOLS-T5075 2-SCRAPER, PAINTERS, 2" | 3 | 12.61 | 12.61 | 12.61
1702971 | 1 |  | 50 | 1702971 | NA |  | 1 | OP5122 | DURATOOL-OP5122-10X MAG EYE GLASS | 50 | 3.18 | 3.18 | 3.18
1836064 | 1 |  | 51 | 1836064 | NA |  | 1 | 72-8730 | Temperature Measuring Range:-18Â°C to +280Â°C; Accuracy %:2%; Operating Temperature Min:-; Operating Temperature Max:-; SVHC:No SVHC (17-Dec-2014) | 105 | 36.29 | 36.29 | 36.29
1438760 | 4 |  | 52 | 1438760 | YES |  | 4 | TMP36GT9Z | IC Output Type:Voltage; Sensing Accuracy Range:Â± 3Â°C; Sensing Temperature Min:-40Â°C; Sensing Temperature Max:+125Â°C; Supply Voltage Min:2.7V; Supply Voltage Max:5.5V; Sensor Case Style:TO-92; N | 624 | 1.33 | 5.32 | 5.32
1206535 | 1 |  | 53 | 1206535 | NA |  | 1 | PPC103 | PRO POWER-PPC103-SOLVENT, IPA, AEROSOL, 400ML | 211 | 3.86 | 3.86 | 3.86
1521281 | 1 |  | 54 | 1521281 | NA |  | 1 | DY7010 | MULTICOMP-DY7010-WRIST STRAP, 6FT CORD | 2012 | 3.91 | 3.91 | 3.91
1687854 | 1 |  | 55 | 1687854 | YES |  | 1 | 070-0011 | End To Ground Resistance:-; No. of Studs:3; Lead Length:-; SVHC:No SVHC (17-Dec-2014) | 301 | 4.69 | 4.69 | 4.69
2132071 | 1 |  | 56 | 2132071 | NA |  | 1 | SM03 | Knife Type:Scalpel; Blade Material:-; Blade Length:79mm; SVHC:No SVHC (17-Dec-2014) | 70 | 1.88 | 1.88 | 1.88
1358645 | 1 |  | 57 | 1358645 | NA |  | 1 | 060329A042 | BOSCH-060329A042-HOT AIR GUN, 230V, UK PLUG | 82 | 24.23 | 24.23 | 24.23

Sheet: BOM_spec (Digikey)
BOM Specification
Part ID | Part description | Manufacturer | Part number | Proto OC | Order margin | Est. unit cost (1000 units) | Replacable? | PCS | Est. total cost (1000 units) | Spec 1 | Value (min) | Value (max) | Spec 2 | Value (min) | Value (max) | Spec 3 | Value (min) | Value (max) | Spec 4 | Value (min) | Value (max) | Spec 5 | Value (min) | Value (max)
IC1 | Solar battery charge controller ASIC | TI | BQ24650 | Digikey | 1.2 | £1.930 | No | 1 | £1.930 | 0 | 0 | 0 | 0 | 0 | 0 | 0 | 0 | 0 | 0 | 0 | 0.0 | 0 | 0 | 0.0
IC3 | Current sense monitor | TI | INA199A3DCKR | Digikey | 1.2 | £0.274 | No | 1 | £0.274 | 0 | 0 | 0 | 0 | 0 | 0 | 0 | 0 | 0 | 0 | 0 | 0.0 | 0 | 0 | 0.0
Q1(A/B) | Dual N-channel Power MOSFET | Vishay Siliconix | Si7288DP | Digikey | 1.2 | £0.491 | No | 1 | £0.491 | 0 | 0 | 0 | 0 | 0 | 0% | 0 | 0.000 | 0 | 0 | 0 | 0 | 0 | 0 | 0
Q6X | P-channel Power MOSFET | Vishay Siliconix | SI4425DDY-T1-GE3 | Digikey | 1 | £0.240 | Maybe | 1 | £0.000 | 0 | 0 | 0 | 0 | 0 | 0 | 0 | 0 | 0 | 0 | 0 | 0 | 0 | 0 | 0
Q6X | P-channel Power MOSFET | Alpha & Omega | AON6413 | Digikey | 1 | £0.160 | Maybe | 1 | £0.000 | 0 | 0 | 0 | 0 | 0 | 0 | 0 | 0 | 0 | 0 | 0 | 0 | 0 | 0 | 0
Q6X | P-channel Power MOSFET | Vishay Siliconix | SI7149ADP-T1-GE3 | Digikey | 1 | £0.240 | Maybe | 1 | £0.000 | 0 | 0 | 0 | 0 | 0 | 0 | 0 | 0 | 0 | 0 | 0 | 0 | 0 | 0 | 0
 | Solder paste |  |  | Digikey | 1

Sheet: Digikey
 | PCS | Scale-up? | PCS-scaled | Margin | PCS w/Margin | DKK/unit | Line price | w/ VAT | GBP
BQ24650 | 1 | YES | 4 | 1.2 | 5 | 43.15 | 215.75 | 258.9 | 27.25
INA199A3DCKR | 1 | YES | 4 | 1.2 | 5 | 12.07 | 60.35 | 72.42 | 7.62
Si7288DP | 1 | YES | 4 | 1.2 | 5 | 13.71 | 68.55 | 82.26 | 8.66
SI4425DDY-T1-GE3 | 1 | NO | 1 | 1 | 1 | 11.48 | 11.48 | 13.776 | 1.45
AON6413 | 1 | NO | 1 | 1 | 1 | 5.22 | 5.22 | 6.264 | 0.66
SI7149ADP-T1-GE3 | 1 | NO | 1 | 1 | 1 | 7.08 | 7.08 | 8.496 | 0.89
Solder paste | 1 | NO | 1 | 1 | 1 | 148.67 | 148.67 | 178.404 | 18.78
 |  |  |  |  |  |  |  |  | 65.32
BQ24650
INA199A3DCKR
Si7288DP
SI4425DDY-T1-GE3
AON6413
SI7149ADP-T1-GE3
