eddiematos/iosolar/03 Bill of materials (electronics)/Starter/20150218 BOM_Starter.xlsx

Sheet: PCB_spec
Part number | Part name | Spec ID | Spec description
B2.2.1 | Pre-assembled PCB-A | B2.2.1_handling | Normal precautions against electro-static discharge (ESD) shall be put into effect during handling and assembly of the PCB-As.
B2.2.2 | Pre-assembled PCB-A | B2.2.1_width | The width of the PCB shall be 35.0mm
B2.2.3 | Pre-assembled PCB-A | B2.2.1_length | The length of the PCB shall be 55.0mm.
B2.2.4 | Pre-assembled PCB-A | B2.2.4_thickness | The total thickness of the PCB shall be 1.50mm.
B2.2.5 | Pre-assembled PCB-A | B2.2.5_material | The material of the PCB shall be FR4.
B2.2.6 | Pre-assembled PCB-A | B2.2.6_layers | The PCB shall have two layers (top and bottom)
B2.2.7 | Pre-assembled PCB-A | B2.2.7_copper | The copper layer thickness shall be 35 microns (1oz/ft²).
B2.2.8 | Pre-assembled PCB-A | B2.2.8_rohs | The PCB assembly shall be RoHS compliant.
B2.2.9 | Pre-assembled PCB-A | B2.2.9_soldermask | The soldermask colour shall be green.
B2.2.10 | Pre-assembled PCB-A | B2.2.10_silkscreen | The silkscreen printing shall be white.
B2.2.11 | Pre-assembled PCB-A | B2.2.11_coating | A basic protective conformal coating is desirable. Please advise with information about protective conformal coating options and their costs.

Sheet: BOM_spec
BOM Specification
Part ID | Part description | Manufacturer | Part number | Leadsintec spec (green - approved) | Replacable? | PCS | Spec 1 | Value (min) | Value (max) | Spec 2 | Value (min) | Value (max) | Spec 3 | Value (min) | Value (max) | Spec 4 | Value (min) | Value (max) | Spec 5 | Value (min) | Value (max)
C1 | Capacitor (MLCC) | Any | 0603 | 0603 680PF 50V X5R 5% (ROHS) | Yes | 1 | Capacitance (F) | 6.8e-10 |  | V_max (V) | 5
C4 | Capacitor (MLCC) | Any | 0603 | 0603 10NF 25V 10% (ROHS) | Yes | 1 | Capacitance (F) | 1e-08 |  | V_max (V) | 25
C2 | Capacitor (Aluminium electrolytic) | Lelon | VZH101M1VTR-0810 | 100UF 35V 20% 8*10.2MM PN:SANYO 35CE100AX (ROHS) | Yes | 1 | Capacitance (F) | 0.0001 |  | V_max (V) | 25 |  | Height (mm) |  | 11.0
C3 | Capacitor (Aluminium electrolytic) | Lelon | VZH101M1VTR-0810 | 100UF 35V 20% 8*10.2MM PN:SANYO 35CE100AX (ROHS) | Yes | 1 | Capacitance (F) | 0.0001 |  | V_max (V) | 10 |  | Height (mm) |  | 11.0 | Lifetime (hours) | 5000 |  | Ir_max (mA) | 270
D1 | Schottky diode, low Vf | NXP | PMEG3010BEA | NXP PMEG3010BEA SOD323 (ROHS) | Yes | 1 | V_f @ 0.2A, 85C (V) |  | 0.4 | I_fmax (av.) (A) | 0.7 |  | I_frm (A) | 3 |  | Vr_max (V) | 10
D3,5,6 | Schottky diode, low Vf | NXP | PMEG3010BEA | NXP PMEG3010BEA SOD323 (ROHS) | Yes | 3 | V_f @ 0.2A, 85C (V) |  | 0.4 | I_fmax (av.) (A) | 0.5 |  |  |  |  | Vr_max (V) | 30
D2,4 | Small signal, TS4148 RY | Taiwan Semi | TS4148 RY | TAIWAN SEMI TS4148 RXG 1206 (ROHS) | No | 2
D7 | Zener diode, 15V, 2% | Any | BZX84-B15 | NXP BZX84-B15 SOT23 (ROHS) | No | 1
IC1 | DC/DC Converter controller | TI | MC33063AD | TI MC33063AD SOIC-8 (ROHS) | No | 1
J1 | DC barrel connector, 1.7mm, CUI, PJ-018 | CUI | PJ-018 | Power Socket ø1.65MM (PN:PJ-018）(ROHS) | Yes | 1 | V_max (V) | 25 |  | I_max (A) | 1
J2 | Long header connector, Samtec, 3-way | Samtec | ESQ-103-14-T-S | SAMTEC 180Degree 1*3PIN 2.54MM PN:ESQ-103-14-T-S/ESQ-103-14-L-S(ROHS) | No | 1
J3 | USB 2.0 type A, right-angle, through-hole | Samtec | USB-A-S-F-B-TH | USB2.0 Femal A 90 Degree PN:SAMTEC USB-A-S-F-B-TH (ROHS) | Yes | 1 | Connector type | USB 2.0, type A |  | Orientation | Right-angle |  | Mounting | Any
L1 | Inductor | NIC | NPIS65LS221MTRF | 220UH 20% 6*6*4.5MM PN:NIC COMPONENTS NPIS65LS221MTRF(ROHS) | Yes | 1 | Inductance (uH) | 220 |  | R_dc_max (Ω) |  | 1 | I_rms_max (A) | 0.6 |  | Diameter (mm) |  | 13.0 | Height (mm) |  | 11.0
Q1(A/B) | BC857BS Dual PNP transistor | NXP | BC857BS | NXP BC857BS SOT363 (ROHS) | No | 1
Q2 | BC847B NPN transistor | NXP | BC847B | NXP BC847B SOT-23 (ROHS) | No | 1
R1 | Resistor | Any | 1206 | 1206 0.33R 1% (ROHS) | Yes | 1 | Resistance (Ω) | 0.33 |  | Tolerance |  | 5% | P_max (W) | 0.250
R3 | Resistor | Any | 0603 | 0603 3.6K 1% (ROHS) | Yes | 1 | Resistance (Ω) | 3600 |  | Tolerance |  | 1%
R2 | Resistor | Any | 0603 | 0603 1.2K 1% (ROHS) | Yes | 1 | Resistance (Ω) | 1200 |  | Tolerance |  | 1%
R5,9,11,13 | Resistor | Any | 0603 | 0603 100K 1% (ROHS) | Yes | 4 | Resistance (Ω) | 100000 |  | Tolerance |  | 1%
R12 | Resistor | Any | 0603 | 0603 10K 1% (ROHS) | Yes | 1 | Resistance (Ω) | 10000 |  | Tolerance |  | 1%
R8 | Resistor | Any | 0603 | 0603 1K 1% (ROHS) | Yes | 1 | Resistance (Ω) | 1000 |  | Tolerance |  | 1%
R4,6 | Resistor | Any | 0603 | 0603 4.7K 1% (ROHS) | Yes | 2 | Resistance (Ω) | 4700 |  | Tolerance |  | 1%
R7 | Resistor | Any | 0603 | 0603 330R 1% (ROHS) | Yes | 1 | Resistance (Ω) | 330 |  | Tolerance |  | 1%
R10 | Resistor | Any | 0603 | 0603 470R 1% (ROHS) | Yes | 1 | Resistance (Ω) | 470 |  | Tolerance |  | 1%

Sheet: BOM_EM
EM sourcing
Part ID | Part description | PCS | Spec 1 | Value | Spec 2 | Value | Spec 3 | Value | Spec 4 | Value | Spec 5 | Value | Source | Order code | Price (1000pcs) | Currency | Total component price (USD) | Assembly points | Assembly type | Unit assembly cost (USD) | Total assembly price (USD) | Total price (USD) | Package size | Part number |  | CNY | 0.1612903226
C1 | Capacitor (MLCC) | 1 | Capacitance (F) | 6.8e-10 | V_max (V) | 50 |  |  |  |  |  |  | Farnell | 1759083 | 0.003 | GBP | 0.0050 | 1.0 | smt | 0.007 | 0.0070 | 0.012 | 0603 |  |  | GBP | 1.55
C4 | Capacitor (MLCC) | 1 | Capacitance (F) | 1e-06 | V_max (V) | 25 |  |  |  |  |  |  | Farnell | 1759039 | 0.007 | GBP | 0.0102 | 1.0 | smt | 0.007 | 0.0070 | 0.017 | 0603 |  |  | USD | 1
C2 | Capacitor (Aluminium electrolytic) | 1 | Capacitance (F) | 0.0001 | V_max (V) | 35 | Height (mm) | 7.7 | Diameter (mm) | 6.3 | Ir_max (mA) | 132 | Farnell | 2326172 | 0.102 | GBP | 0.1581 | 1.0 | smt | 0.007 | 0.0070 | 0.165 | 6.3MM Radial Can SMD | EEE1VA101XP | CA035M0100REH-0607
C3 | Capacitor (Aluminium electrolytic) | 1 | Capacitance (F) | 0.0001 | V_max (V) | 35 | Height (mm) | 7.7 | Diameter (mm) | 6.3 | Ir_max (mA) | 132 | Farnell | 2326172 | 0.102 | GBP | 0.1581 | 1.0 | smt | 0.007 | 0.0070 | 0.165 | 6.3MM Radial Can SMD | VZH101M1CTR-0606
D1 | Schottky diode, low Vf | 1 | V_f @ 0.2A, 85C (V) | 0.24 | I_fmax (av.) (A) | 1 | I_frm (A) | 3.5 | Vr_max (V) | 30 |  |  | Farnell | 8737991 | 0.077 | GBP | 0.1198 | 1.5 | smt | 0.011 | 0.0105 | 0.130 | SOD-323 | PMEG3010BEA
D3,5,6 | Schottky diode, low Vf | 3 | V_f @ 0.2A, 85C (V) | 0.24 | I_fmax (av.) (A) | 1 |  |  | Vr_max (V) | 30 |  |  | Farnell | 8737991 | 0.077 | GBP | 0.3594 | 1.5 | smt | 0.011 | 0.0315 | 0.391 | SOD-323 | PMEG3010BEA
D2,4 | Small signal, TS4148 RY | 2 | Manufacturer | Taiwan Semiconductor | Model | TS4148 RY |  |  |  |  |  |  | Farnell | 8150206 | 0.015 | GBP | 0.0481 | 1.0 | smt | 0.007 | 0.0140 | 0.062 | 0805 | TS4148 RY (0805)
D7 | Zener diode, 15V, 2% | 1 | Model | BZX84-B15 |  |  |  |  |  |  |  |  | Farnell | 2311211 | 0.022 | GBP | 0.0347 | 1.5 | smt | 0.011 | 0.0105 | 0.045 | SOT-23 | BZX84-B15
IC1 | DC/DC Converter controller | 1 | Manufacturer | TI | Model | MC33063AD |  |  |  |  |  |  | Farnell | 1053591 | 0.230 | GBP | 0.3565 | 4.0 | smt | 0.028 | 0.0280 | 0.385 | SOIC-8 | MC33063AD
J1 | DC barrel connector, 1.7mm, CUI, PJ-018 | 1 | V_max (V) | 25 | I_max (A) | 1 |  |  |  |  |  |  | DigiKey | CP-018PJ-ND | 2.595 | CNY | 0.4185 | 3.0 | pth | 0.042 | 0.0420 | 0.461 | 14.5mm x 9.0mm | PJ-018
J2 | Long header connector, Samtec, 3-way | 1 | Manufacturer | Samtec | Model | ESQ-103-14-T-S |  |  |  |  |  |  | Samtec | - | 0.375 | USD | 0.3750 | 3.0 | pth | 0.042 | 0.0420 | 0.417 | 3 x 2.54mm | ESQ-103-14-T-S
J3 | USB 2.0 type A, right-angle, through-hole | 1 |  |  |  |  |  |  |  |  |  |  | Farnell | 1696534 | 0.214 | GBP | 0.3317 | 6.0 | pth | 0.084 | 0.0840 | 0.416 | USB2.0A | A-USBSA
L1 | Inductor | 1 | Inductance (uH) | 0.00022 | R_dc_max (Ω) | 0.61 | I_rms_max (A) | 0.8 | Diameter (mm) | 13.0 | Height (mm) | 5.12 | Farnell | 1861782 | 0.158 | GBP | 0.2449 | 2.0 | smt | 0.014 | 0.0140 | 0.259 | Inductor, 12.95x9.40 | MCPD3316MT221 | NPIS65LS221MTRF
Q1(A/B) | BC857BS Dual PNP transistor | 1 | Manufacturer | NXP | Model | BC857BS |  |  |  |  |  |  | Farnell | 1081247 | 0.052 | GBP | 0.0814 | 3.0 | smt | 0.021 | 0.0210 | 0.102 | SOT-363 | BC857BS
Q2 | BC847B NPN transistor | 1 | Manufacturer | NXP | Model | BC847B |  |  |  |  |  |  | Farnell | 1081232 | 0.012 | GBP | 0.0192 | 1.5 | smt | 0.011 | 0.0105 | 0.030 | SOT-23 | BC847B
R1 | Resistor | 1 | Resistance (Ω) | 0.33 | Tolerance | 5% | P_max (W) | 0.25 |  |  |  |  | Farnell | 2328144 | 0.031 | GBP | 0.0484 | 2.0 | smt | 0.014 | 0.0140 | 0.062 | 1206
R3 | Resistor | 1 | Resistance (Ω) | 3600 | Tolerance | 1% |  |  |  |  |  |  | Farnell | 2073482 | 0.004 | GBP | 0.0068 | 1.0 | smt | 0.007 | 0.0070 | 0.014 | 0603
R2 | Resistor | 1 | Resistance (Ω) | 1200 | Tolerance | 1% |  |  |  |  |  |  | Farnell | 9238492 | 0.009 | CNY | 0.0015 | 1.0 | smt | 0.007 | 0.0070 | 0.008 | 0603 |  | already have!
R5,9,11,13 | Resistor | 4 | Resistance (Ω) | 100000 | Tolerance | 1% |  |  |  |  |  |  | Farnell | 2309107 | 0.001 | GBP | 0.0068 | 1.0 | smt | 0.007 | 0.0280 | 0.035 | 0603
R12 | Resistor | 1 | Resistance (Ω) | 10000 | Tolerance | 1% |  |  |  |  |  |  | Farnell | 2447230 | 0.001 | GBP | 0.0009 | 1.0 | smt | 0.007 | 0.0070 | 0.008 | 0603
R8 | Resistor | 1 | Resistance (Ω) | 1000 | Tolerance | 1% |  |  |  |  |  |  | Farnell | 2073348 | 0.004 | GBP | 0.0067 | 1.0 | smt | 0.007 | 0.0070 | 0.014 | 0603
R4,6 | Resistor | 2 | Resistance (Ω) | 4700 | Tolerance | 1% |  |  |  |  |  |  | Farnell | 2073509 | 0.004 | GBP | 0.0136 | 1.0 | smt | 0.007 | 0.0140 | 0.028 | 0603
R7 | Resistor | 1 | Resistance (Ω) | 330 | Tolerance | 1% |  |  |  |  |  |  | Farnell | 2447339 | 0.001 | GBP | 0.0009 | 1.0 | smt | 0.007 | 0.0070 | 0.008 | 0603
R10 | Resistor | 1 | Resistance (Ω) | 470 | Tolerance | 1% |  |  |  |  |  |  | Farnell | 2447374 | 0.001 | GBP | 0.0009 | 1.0 | smt | 0.007 | 0.0070 | 0.008 | 0603
 |  |  |  |  |  |  |  |  |  |  |  |  |  |  |  |  | 2.8072 |  |  |  | 0.4340 | 3.241
