eddiematos/iosolar/04 3D CAD/20150202_mods/SW Files/SCA_SHAMBA_Battery Brick ASSY 05.02.15.SLDASM

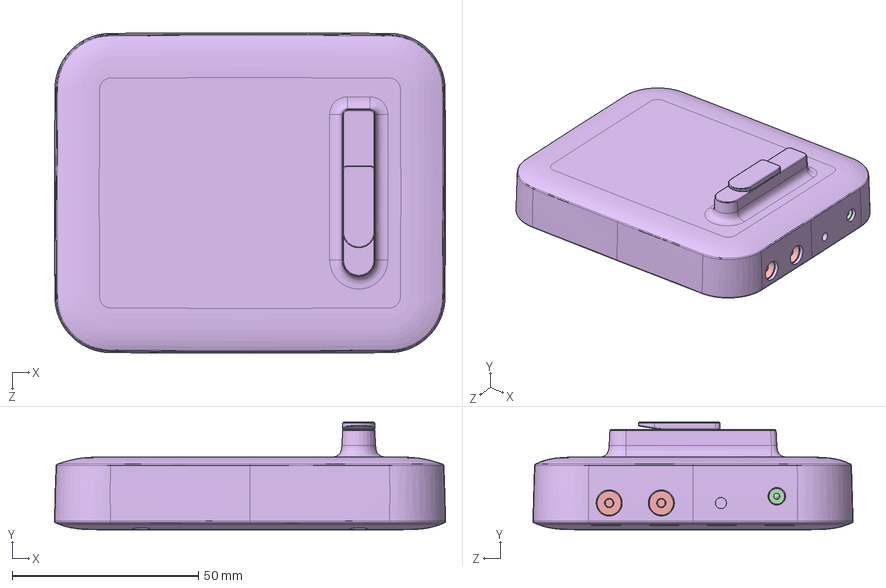
[picture p7: CAD file, 2018-09-25]
04 3D CAD/20150202_mods/SW Files/SCA_SHAMBA_Battery Brick ASSY 05.02.15.SLDASM
105.0 x 28.9 x 86.0 mm
SCA_SHAMBA_Battery-PCB 05.02.15
SCA_SHAMBA_Single Cell 05.02.15 x 4
SCA_SHAMBA_Stacking Connector 05.02.15
SCA_SHAMBA_Input Connector PJ-018 05.02.15
SCA_SHAMBA_Output Connector PJ-002B 05.02.15 x 2
SCA_SHAMBA_Battery Brick 2 05.02.15
