eddiematos/iosolar/04 3D CAD/20160330_charger/PCB-A/PCB-A.SLDASM

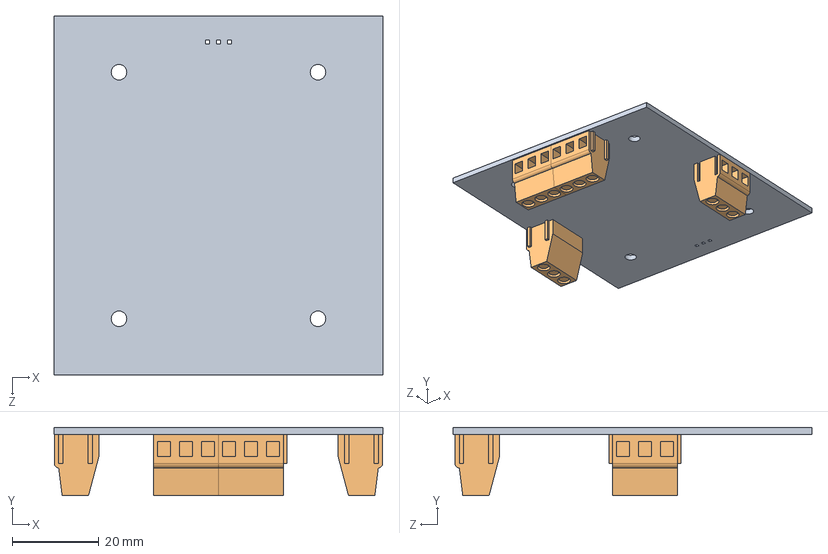
[picture p8: CAD file, 2018-09-25]
04 3D CAD/20160330_charger/PCB-A/PCB-A.SLDASM
76.0 x 15.8 x 83.0 mm
PCB
SCREW-TERMINAL-3 x 4
