eddiematos/iosolar/04 3D CAD/20160330_charger/CHARGER.SLDASM

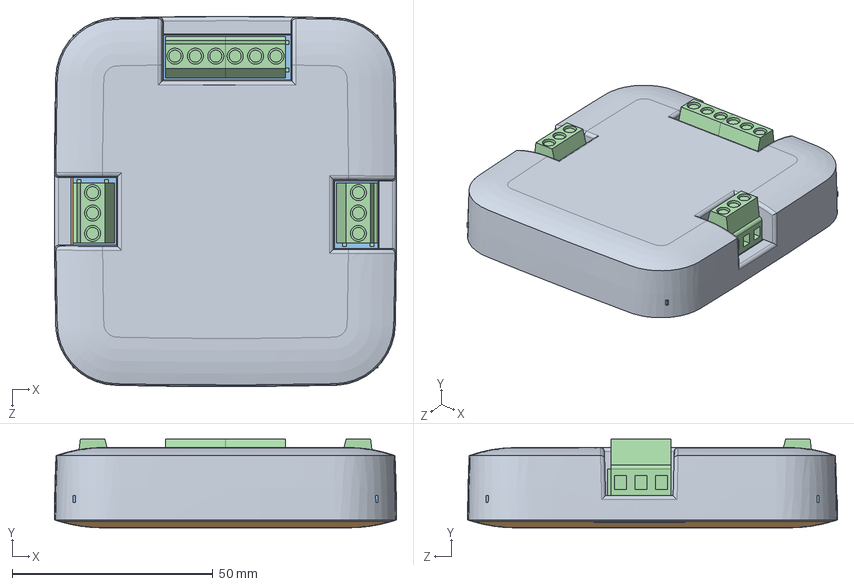
[picture p9: CAD file, 2018-09-25]
04 3D CAD/20160330_charger/CHARGER.SLDASM
85.2 x 22.1 x 92.1 mm
TOP
BOTTOM
PCB
SCREW-TERMINAL-3 x 4
