eddiematos/iosolar/04 3D CAD/20160330_charger/SCA-COPIES/CHARGER-sca.SLDASM

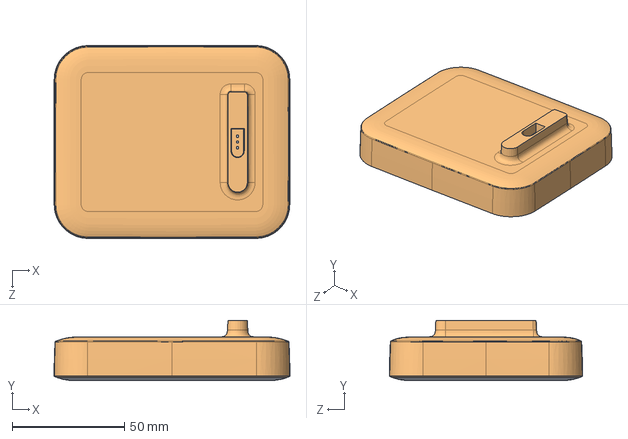
[picture p10: CAD file, 2018-09-25]
04 3D CAD/20160330_charger/SCA-COPIES/CHARGER-sca.SLDASM
105.0 x 26.9 x 86.0 mm
BOTTOM-sca
TOP-sca
