eddiematos/iosolar/04 3D CAD/20160330_charger/PCB-A/CONNECTOR.SLDASM

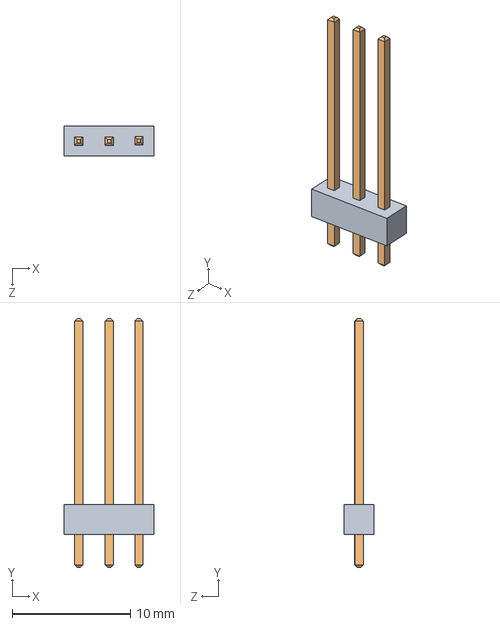
[picture p12: CAD file, 2018-09-25]
04 3D CAD/20160330_charger/PCB-A/CONNECTOR.SLDASM
7.62 x 21.1 x 2.54 mm
CONNECTOR-BRACE
CONNECTOR-PIN x 3
