eddiematos/iosolar/04 3D CAD/20141228_tooling/Solidworks Files/SCA_SHAMBA_Stacking ASSY 16.12.14.SLDASM

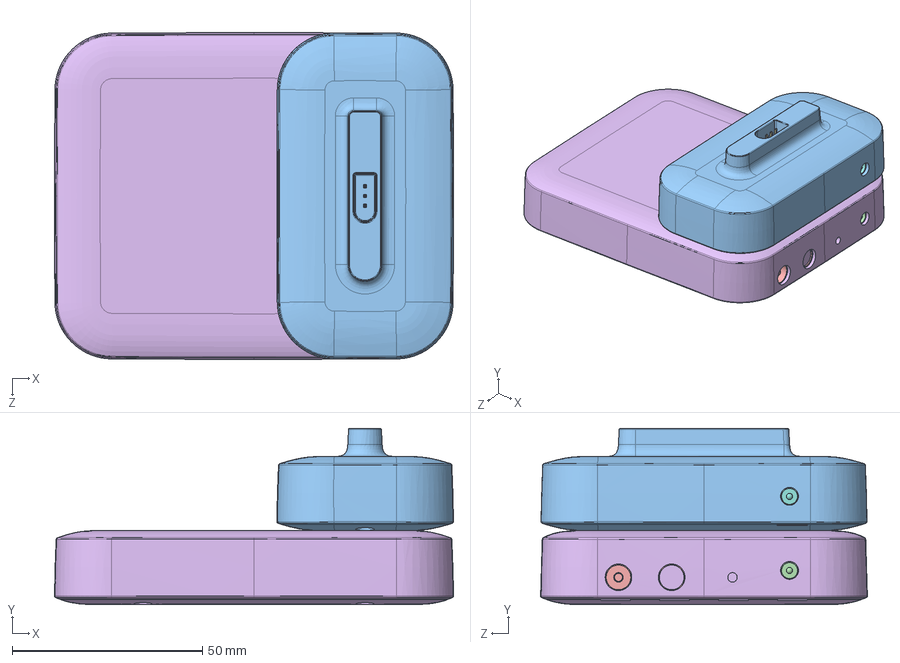
[picture p13: CAD file, 2018-09-25]
04 3D CAD/20141228_tooling/Solidworks Files/SCA_SHAMBA_Stacking ASSY 16.12.14.SLDASM
105.0 x 46.4 x 86.0 mm
Battery-PCB
Single Cell x 4
Stacking Connector
Input Connector PJ-018
Output Connector PJ-002B x 2
Battery Brick 2
STACKING CONN
INPUT CONN PJ-018
USB BRICK-PCB
USB-CONN SOCKET
USB BRICK 4
Grommet
