eddiematos/iosolar/04 3D CAD/20141228_tooling/Solidworks Files/SCA_SHAMBA_USB BRICK ASSY 16.12.14.SLDASM

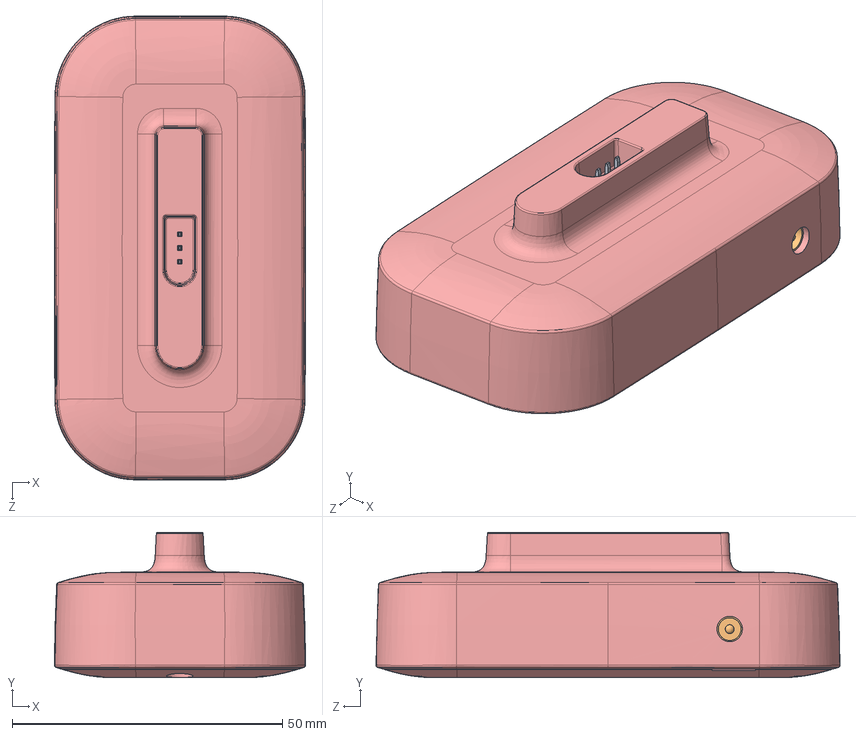
[picture p14: CAD file, 2018-09-25]
04 3D CAD/20141228_tooling/Solidworks Files/SCA_SHAMBA_USB BRICK ASSY 16.12.14.SLDASM
46.5 x 26.9 x 85.8 mm
STACKING CONN
INPUT CONN PJ-018
USB BRICK-PCB
USB-CONN SOCKET
USB BRICK 4
Grommet
