eddiematos/iosolar/01 Printed Circuit Board/Battery 100/Sketch-up/Enclosure fit.FCStd

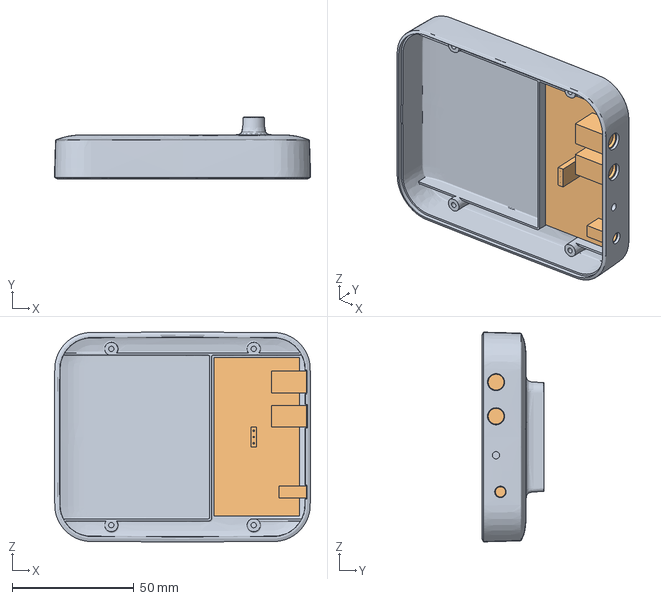
[picture p15: CAD file, 2018-09-25]
01 Printed Circuit Board/Battery 100/Sketch-up/Enclosure fit.FCStd
105.0 x 25.4 x 86.0 mm
Document
Untitled-54e371e002
