eddiematos/iosolar/01 Printed Circuit Board/Starter/Sketch-up/Enclosure fit.FCStd

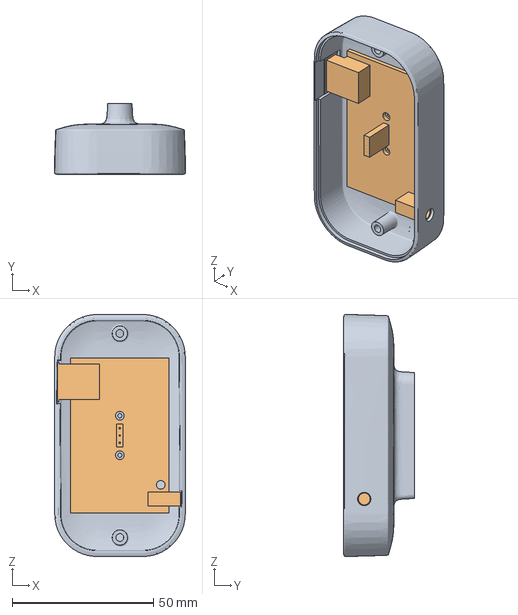
[picture p16: CAD file, 2018-09-25]
01 Printed Circuit Board/Starter/Sketch-up/Enclosure fit.FCStd
46.5 x 25.3 x 85.7 mm
Document
PCB model
