eddiematos/iosolar/04 3D CAD/20141228_tooling/Solidworks Files/SCA_SHAMBA_USB BRICK-PCB 16.12.14.SLDPRT

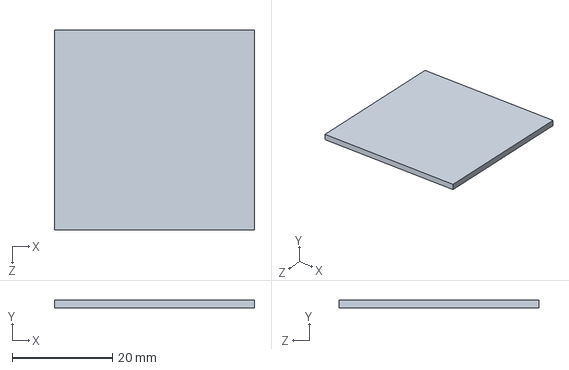
[picture p17: CAD file, 2018-09-25]
04 3D CAD/20141228_tooling/Solidworks Files/SCA_SHAMBA_USB BRICK-PCB 16.12.14.SLDPRT
40.0 x 1.50 x 40.0 mm
