eddiematos/iosolar/04 3D CAD/20141228_tooling/STEP Files/B2.4.0 Dust Cap.stp

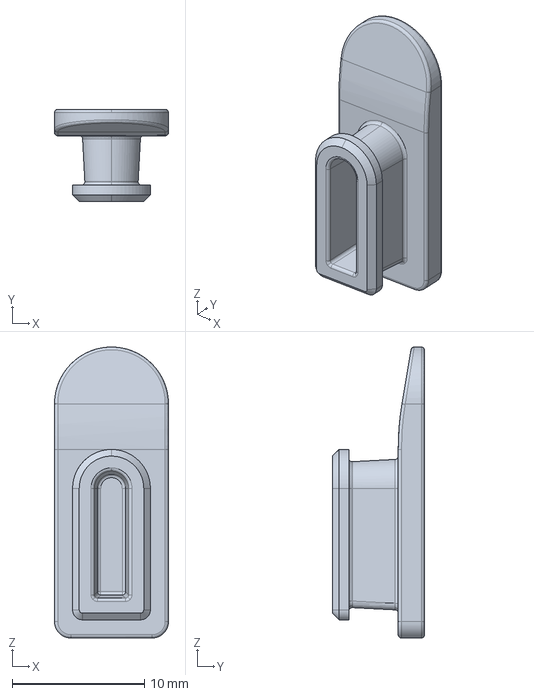
[picture p18: CAD file, 2018-09-25]
04 3D CAD/20141228_tooling/STEP Files/B2.4.0 Dust Cap.stp
8.63 x 6.98 x 22.0 mm
