eddiematos/iosolar/04 3D CAD/20150202_mods/B2.1.1 05.02.15.stp

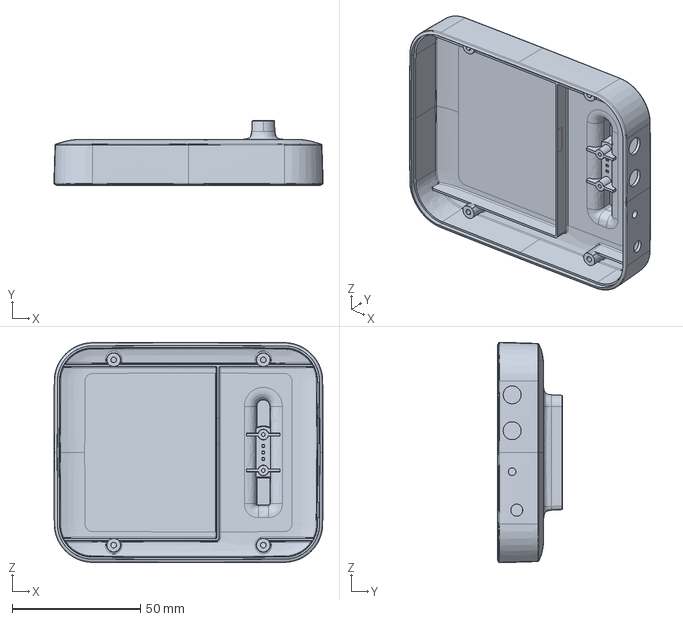
[picture p19: CAD file, 2018-09-25]
04 3D CAD/20150202_mods/B2.1.1 05.02.15.stp
105.0 x 25.4 x 86.0 mm
