eddiematos/iosolar/04 3D CAD/20160330_charger/BOTTOM.SLDPRT

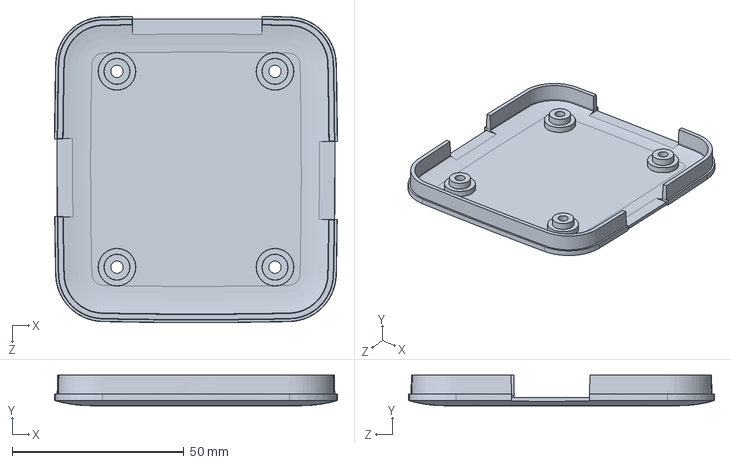
[picture p20: CAD file, 2018-09-25]
04 3D CAD/20160330_charger/BOTTOM.SLDPRT
82.4 x 8.90 x 89.2 mm
