eddiematos/iosolar/04 3D CAD/20160330_charger/SCA-COPIES/BOTTOM-sca.SLDPRT

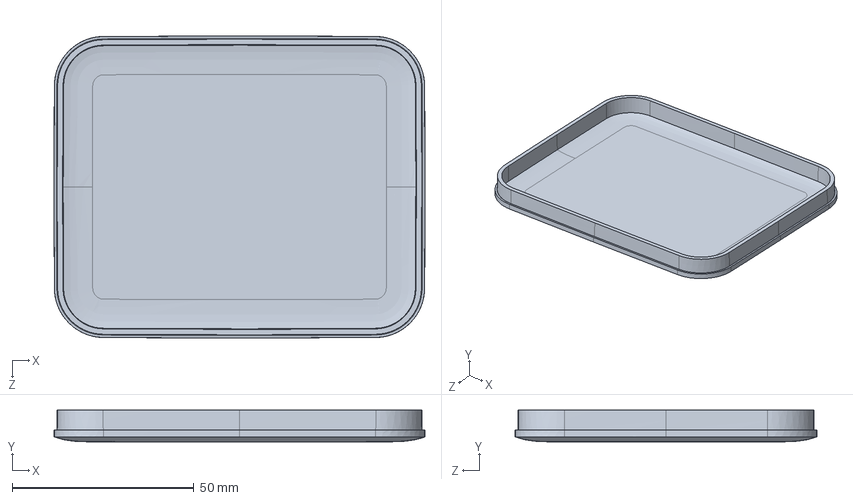
[picture p21: CAD file, 2018-09-25]
04 3D CAD/20160330_charger/SCA-COPIES/BOTTOM-sca.SLDPRT
102.1 x 8.70 x 83.1 mm
