eddiematos/iosolar/04 3D CAD/20141228_tooling/Solidworks Files/SCA_SHAMBA_USB-CONN SOCKET 16.12.14.SLDPRT

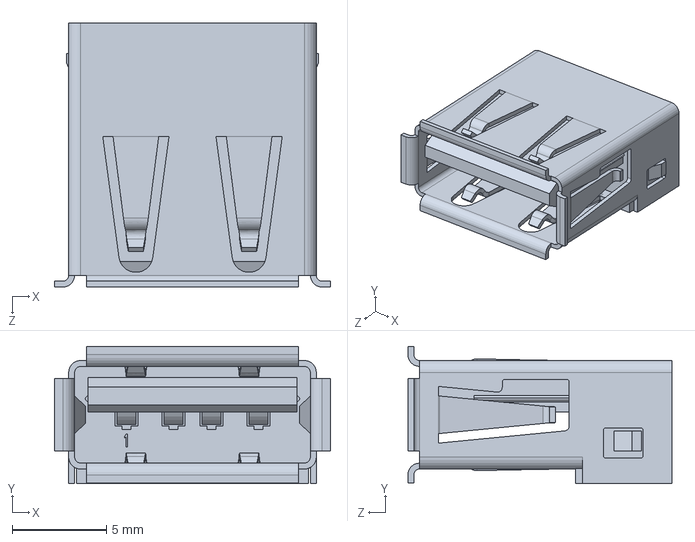
[picture p22: CAD file, 2018-09-25]
04 3D CAD/20141228_tooling/Solidworks Files/SCA_SHAMBA_USB-CONN SOCKET 16.12.14.SLDPRT
14.6 x 7.28 x 14.0 mm
