eddiematos/iosolar/04 3D CAD/20141228_tooling/STEP Files/B2.1.2 Bottom Cover.stp

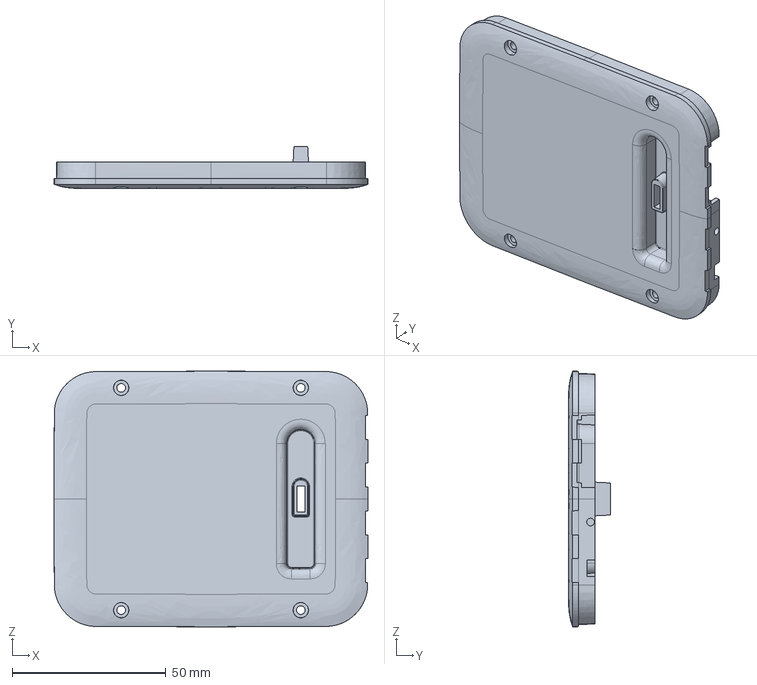
[picture p23: CAD file, 2018-09-25]
04 3D CAD/20141228_tooling/STEP Files/B2.1.2 Bottom Cover.stp
102.1 x 13.7 x 83.1 mm
