eddiematos/iosolar/04 3D CAD/20150202_mods/SW Files/SCA_SHAMBA_Battery-PCB 05.02.15.SLDPRT

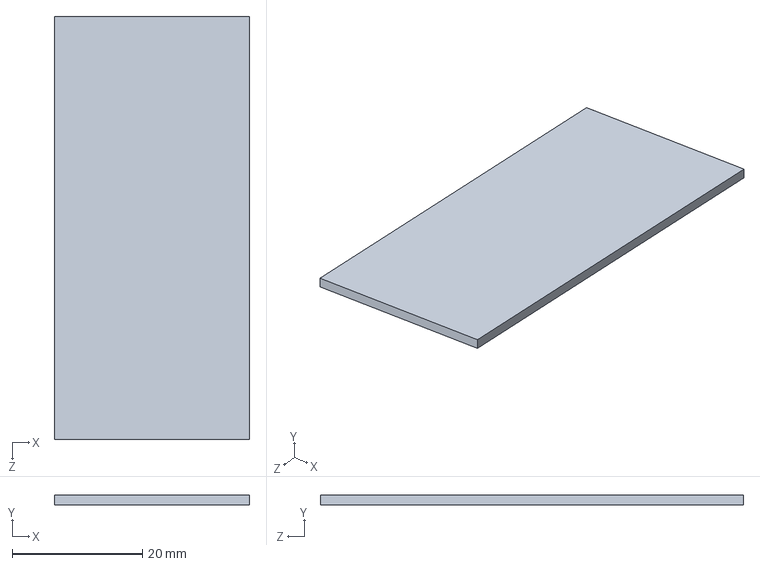
[picture p24: CAD file, 2018-09-25]
04 3D CAD/20150202_mods/SW Files/SCA_SHAMBA_Battery-PCB 05.02.15.SLDPRT
30.0 x 1.50 x 65.0 mm
