eddiematos/iosolar/04 3D CAD/20160330_charger/PCB-A/PCB.SLDPRT

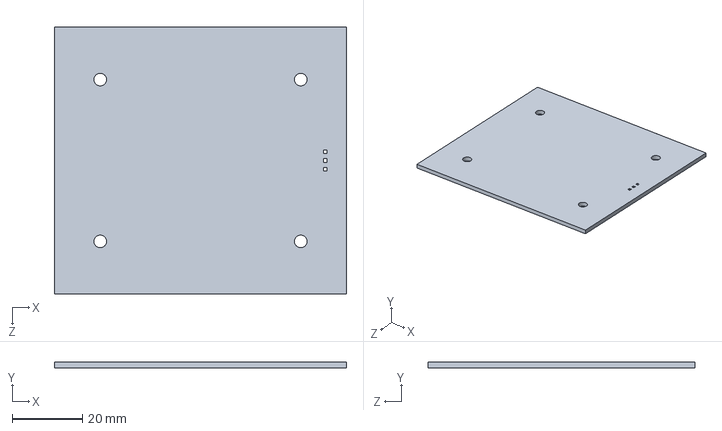
[picture p25: CAD file, 2018-09-25]
04 3D CAD/20160330_charger/PCB-A/PCB.SLDPRT
83.0 x 1.66 x 76.0 mm
