eddiematos/iosolar/04 3D CAD/20141228_tooling/STEP Files/S2.1.2 Bottom cover.stp

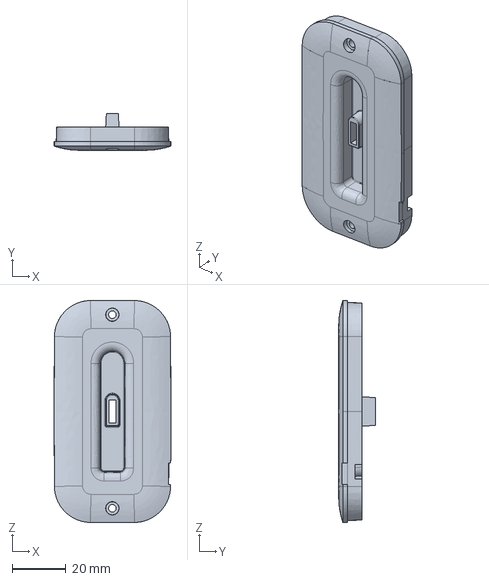
[picture p26: CAD file, 2018-09-25]
04 3D CAD/20141228_tooling/STEP Files/S2.1.2 Bottom cover.stp
43.6 x 13.7 x 82.9 mm
