eddiematos/iosolar/04 3D CAD/20150202_mods/SW Files/SCA_SHAMBA_Output Connector PJ-002B 05.02.15.SLDPRT

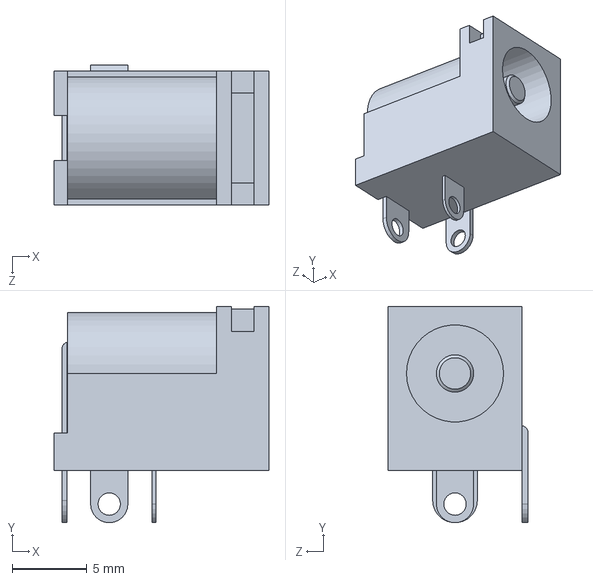
[picture p27: CAD file, 2018-09-25]
04 3D CAD/20150202_mods/SW Files/SCA_SHAMBA_Output Connector PJ-002B 05.02.15.SLDPRT
14.4 x 14.5 x 9.40 mm
