eddiematos/iosolar/04 3D CAD/20160330_charger/SCA-COPIES/TOP-sca.SLDPRT

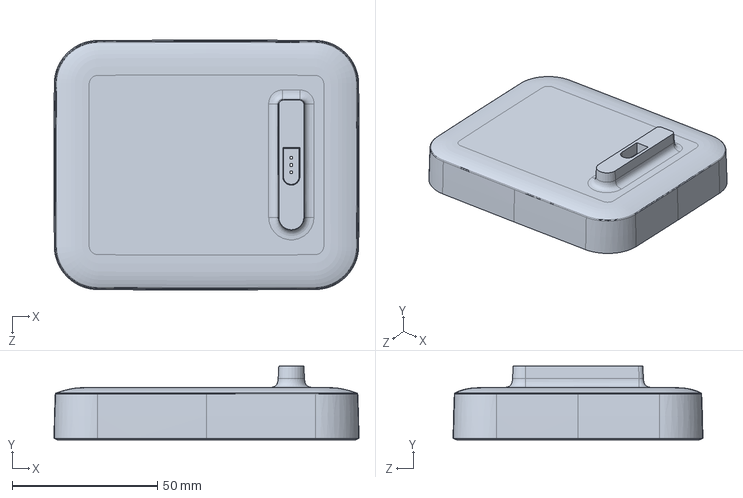
[picture p28: CAD file, 2018-09-25]
04 3D CAD/20160330_charger/SCA-COPIES/TOP-sca.SLDPRT
105.0 x 25.4 x 86.0 mm
