eddiematos/iosolar/04 3D CAD/20160330_charger/TOP.SLDPRT

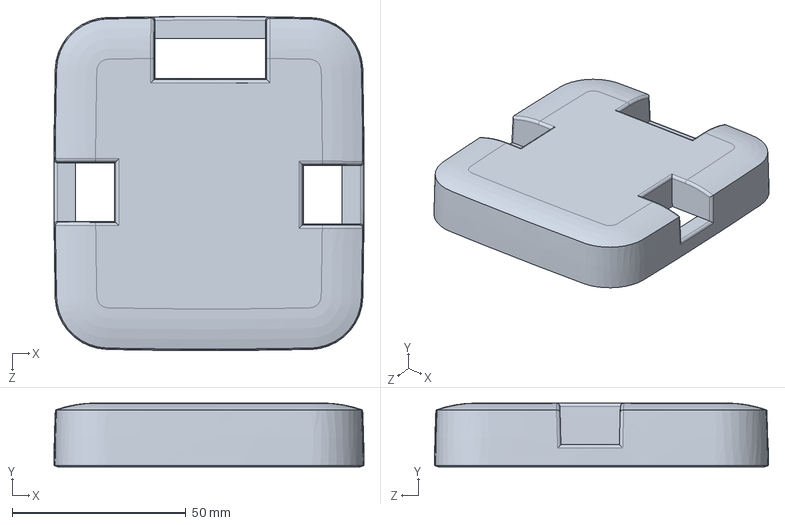
[picture p29: CAD file, 2018-09-25]
04 3D CAD/20160330_charger/TOP.SLDPRT
89.3 x 18.4 x 96.2 mm
