eddiematos/iosolar/04 3D CAD/20141228_tooling/Solidworks Files/SCA_SHAMBA_INPUT CONN PJ-018 16.12.14.SLDPRT

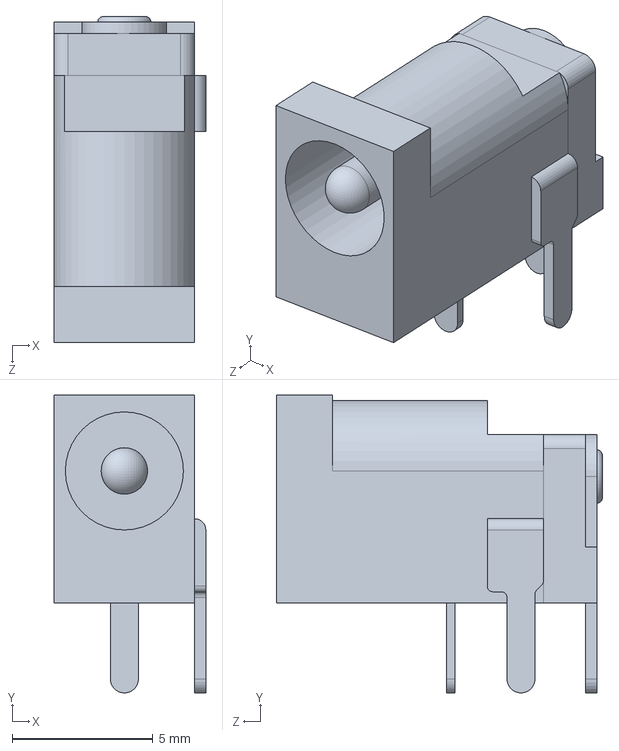
[picture p30: CAD file, 2018-09-25]
04 3D CAD/20141228_tooling/Solidworks Files/SCA_SHAMBA_INPUT CONN PJ-018 16.12.14.SLDPRT
5.40 x 10.6 x 11.6 mm
