eddiematos/iosolar/04 3D CAD/20141228_tooling/STEP Files/Stack-Align Grommet.stp

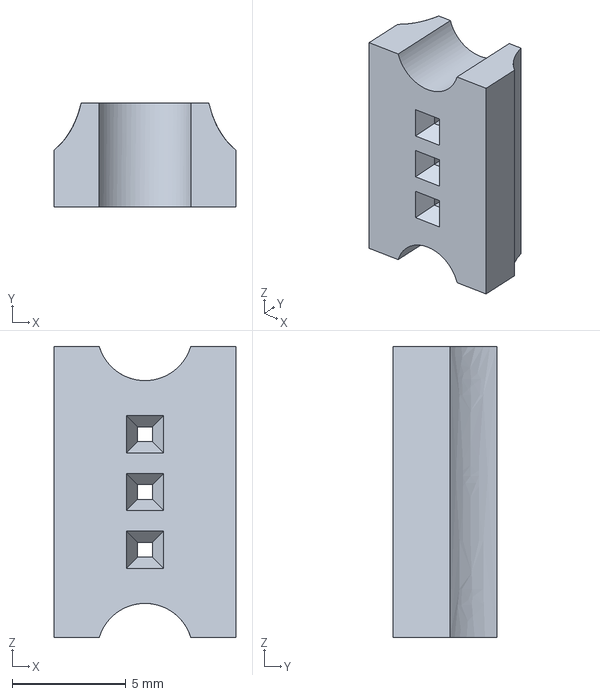
[picture p31: CAD file, 2018-09-25]
04 3D CAD/20141228_tooling/STEP Files/Stack-Align Grommet.stp
8.00 x 4.58 x 12.8 mm
