eddiematos/iosolar/04 3D CAD/20150202_mods/SW Files/SCA_SHAMBA_Single Cell 05.02.15.SLDPRT

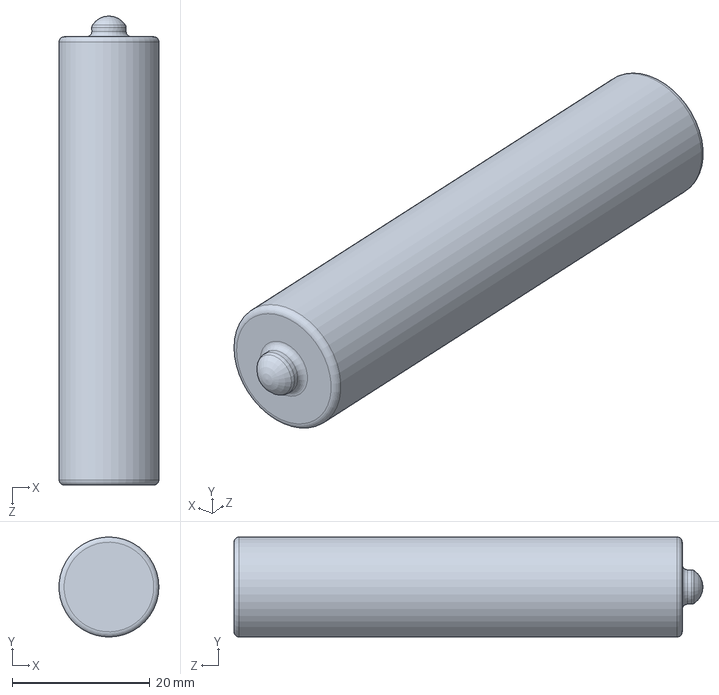
[picture p32: CAD file, 2018-09-25]
04 3D CAD/20150202_mods/SW Files/SCA_SHAMBA_Single Cell 05.02.15.SLDPRT
14.5 x 14.5 x 68.0 mm
