eddiematos/iosolar/04 3D CAD/20160330_charger/SOAP.SLDPRT

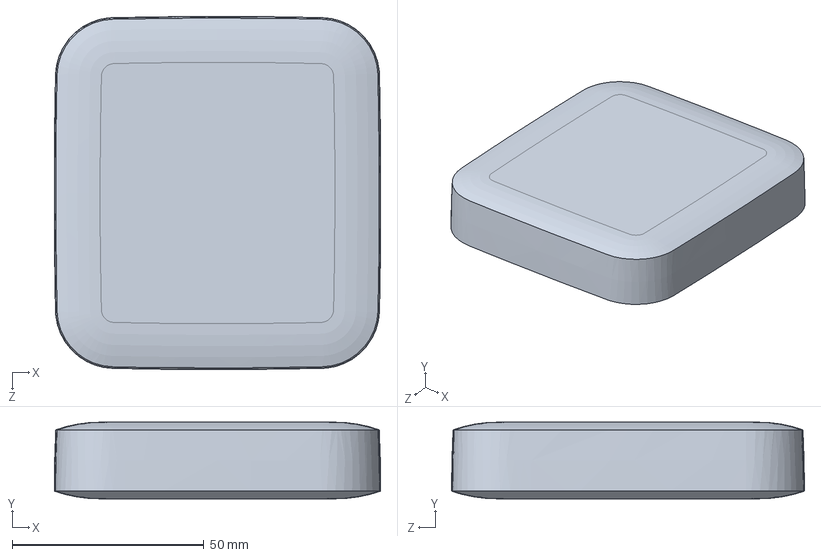
[picture p33: CAD file, 2018-09-25]
04 3D CAD/20160330_charger/SOAP.SLDPRT
85.2 x 20.0 x 92.1 mm
