eddiematos/iosolar/04 3D CAD/20141228_tooling/Solidworks Files/SCA_SHAMBA_STACKING CONN 16.12.14.SLDPRT

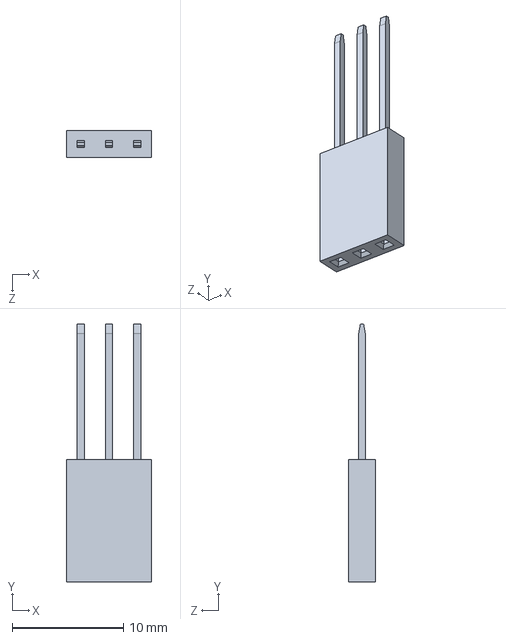
[picture p34: CAD file, 2018-09-25]
04 3D CAD/20141228_tooling/Solidworks Files/SCA_SHAMBA_STACKING CONN 16.12.14.SLDPRT
7.62 x 23.2 x 2.40 mm
