eddiematos/iosolar/04 3D CAD/20141228_tooling/STEP Files/B2.5.0 Dust Cap.stp

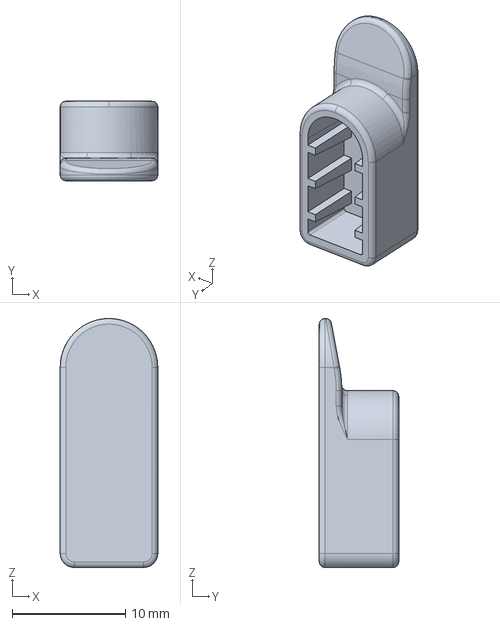
[picture p35: CAD file, 2018-09-25]
04 3D CAD/20141228_tooling/STEP Files/B2.5.0 Dust Cap.stp
8.63 x 7.03 x 22.0 mm
