eddiematos/iosolar/04 3D CAD/20160330_charger/PCB-A/CONNECTOR-PIN.SLDPRT

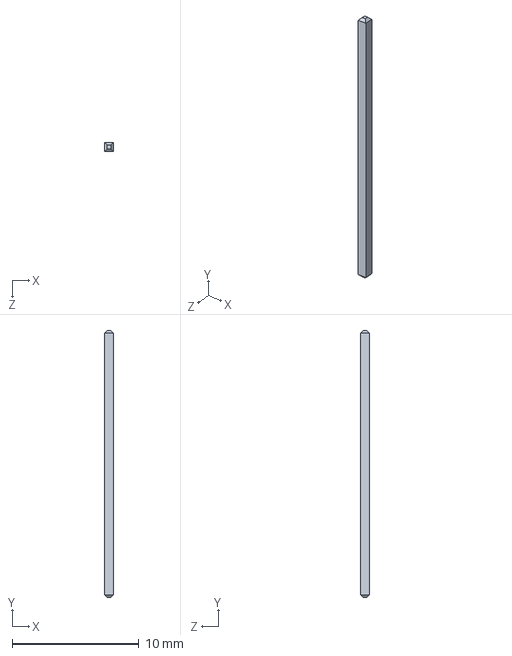
[picture p36: CAD file, 2018-09-25]
04 3D CAD/20160330_charger/PCB-A/CONNECTOR-PIN.SLDPRT
0.68 x 21.1 x 0.68 mm
