eddiematos/iosolar/04 3D CAD/20141228_tooling/Solidworks Files/Part2.SLDPRT

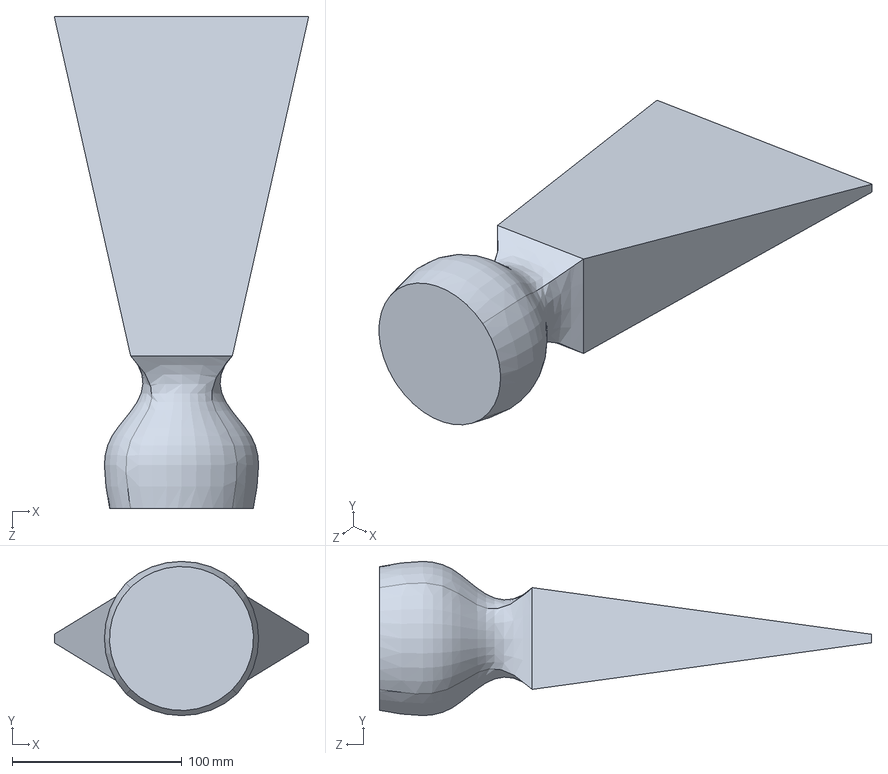
[picture p37: CAD file, 2018-09-25]
04 3D CAD/20141228_tooling/Solidworks Files/Part2.SLDPRT
150.0 x 90.9 x 290.0 mm
