eddiematos/iosolar/04 3D CAD/20141228_tooling/STEP Files/S2.1.1 Top cover.stp

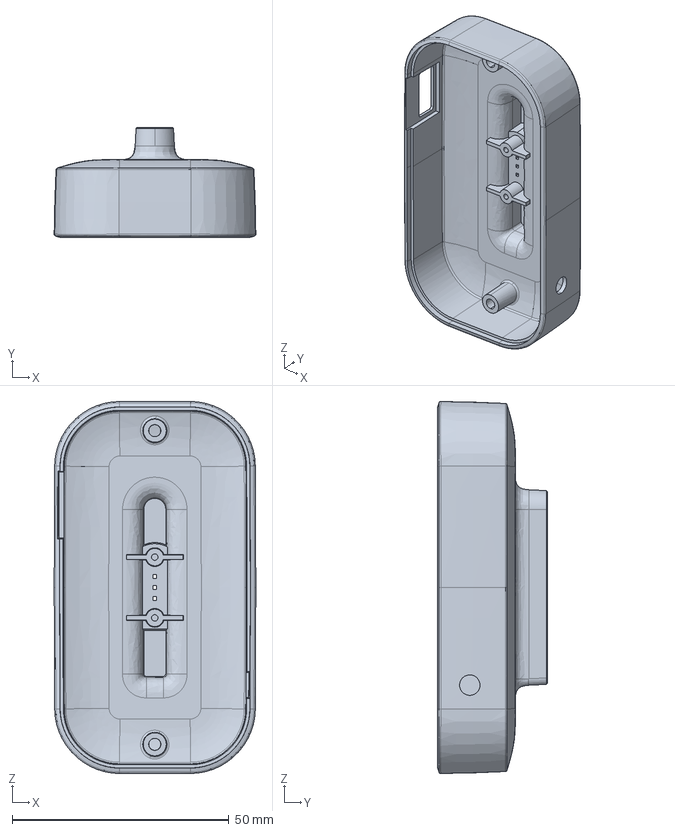
[picture p38: CAD file, 2018-09-25]
04 3D CAD/20141228_tooling/STEP Files/S2.1.1 Top cover.stp
46.5 x 25.3 x 85.7 mm
