eddiematos/iosolar/04 3D CAD/20160330_charger/PCB-A/CONNECTOR-BRACE.SLDPRT

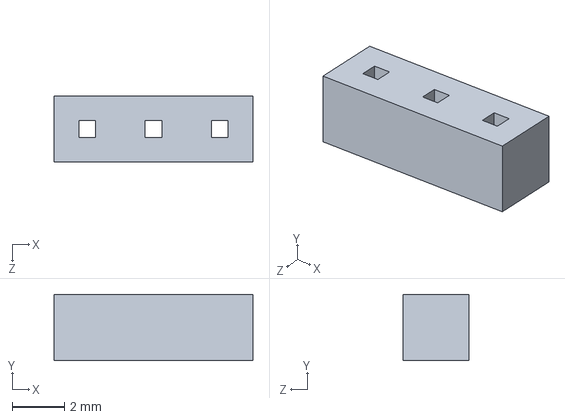
[picture p39: CAD file, 2018-09-25]
04 3D CAD/20160330_charger/PCB-A/CONNECTOR-BRACE.SLDPRT
7.62 x 2.54 x 2.54 mm
