eddiematos/iosolar/04 3D CAD/20141228_tooling/STEP Files/B2.1.1 Top Cover.stp

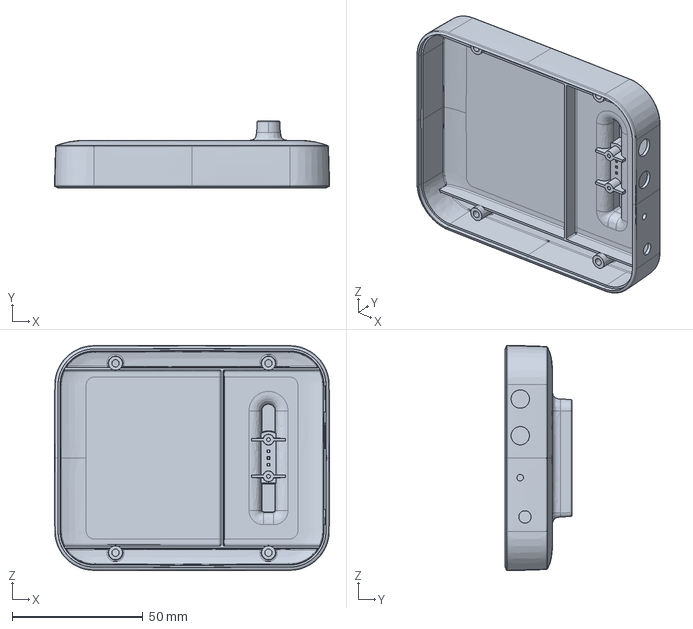
[picture p40: CAD file, 2018-09-25]
04 3D CAD/20141228_tooling/STEP Files/B2.1.1 Top Cover.stp
105.0 x 25.4 x 86.0 mm
