eddiematos/iosolar/(list of files, cad)

Other CAD files:
04 3D CAD/20150202_mods/SW Files/SCA_SHAMBA_Input Connector PJ-018 05.02.15.SLDPRT
04 3D CAD/20150202_mods/SW Files/SCA_SHAMBA_Stacking Connector 05.02.15.SLDPRT
04 3D CAD/20141228_tooling/Solidworks Files/SCA_SHAMBA_Grommet 16.12.14.sldprt
04 3D CAD/20141228_tooling/Solidworks Files/SCA_SHAMBA_Battery-PCB 16.12.14.SLDPRT
01 Printed Circuit Board/Battery 100/Sketch-up/PCB model.skp
01 Printed Circuit Board/Starter/Sketch-up/PCB model.skp
04 3D CAD/20160330_charger/PCB-A/SCREW-TERMINAL-3.SLDPRT
