eddiematos/iosolar/04 3D CAD/20150202_mods/tooling failures/Tolerance problem.pdf

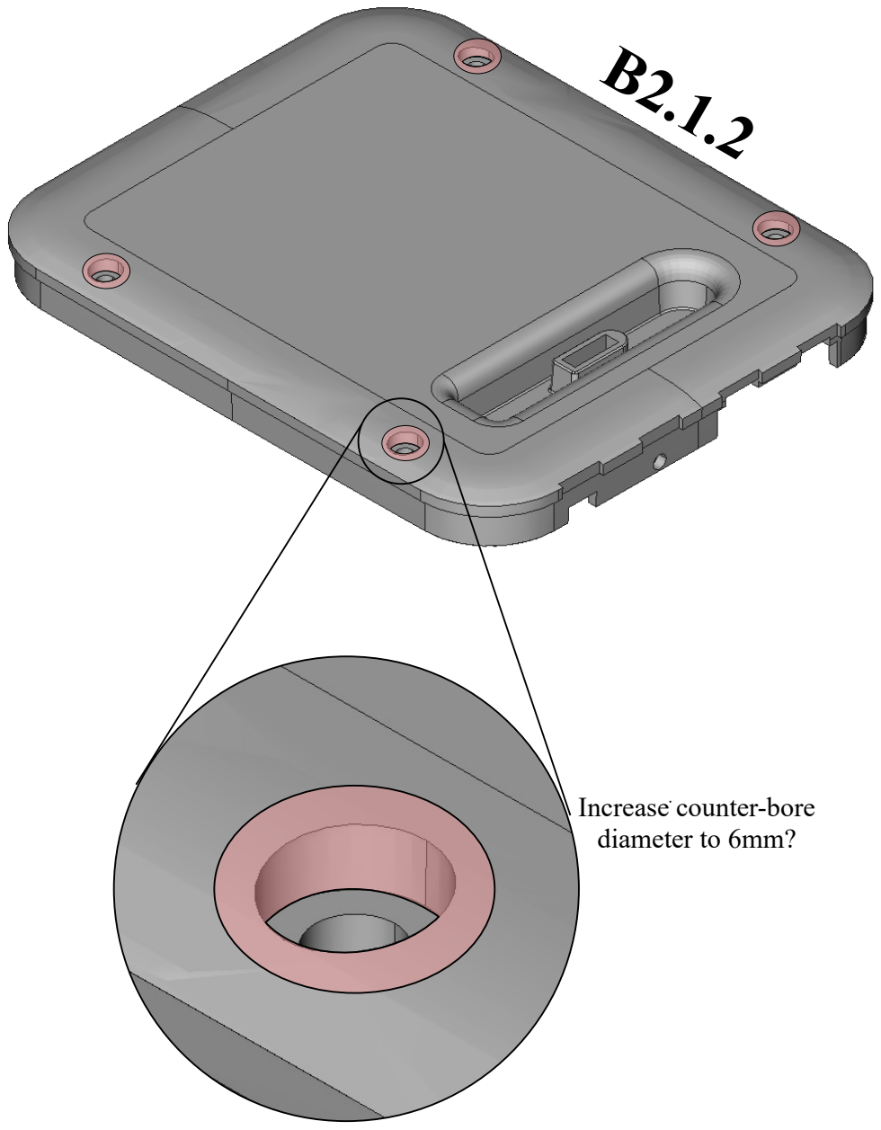
[picture p41: page 1]

Increase counter-bore
diameter to 6mm?

B2.1.2
