eddiematos/iosolar/04 3D CAD/20150202_mods/tooling failures/imperfect fit.png

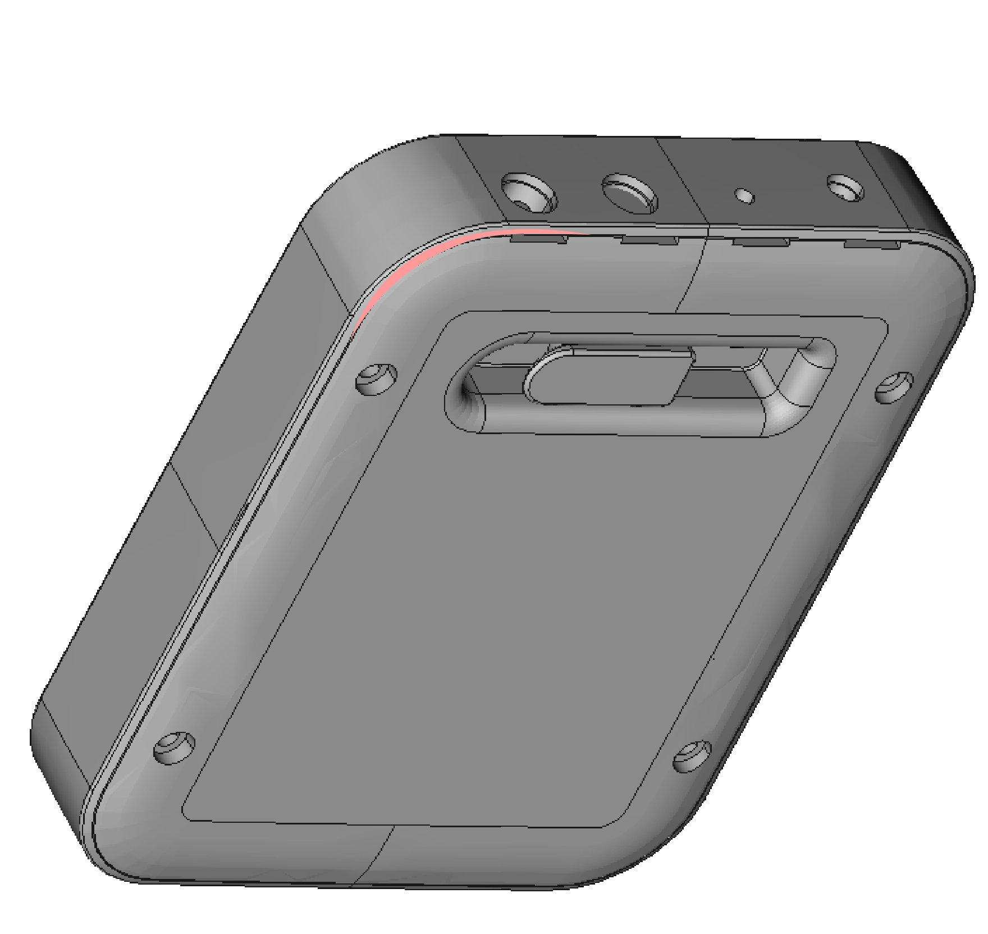
04 3D CAD/20150202_mods/tooling failures/imperfect fit.png
