eddiematos/iosolar/04 3D CAD/20150202_mods/design failures/B2.1.1_mod2.pdf

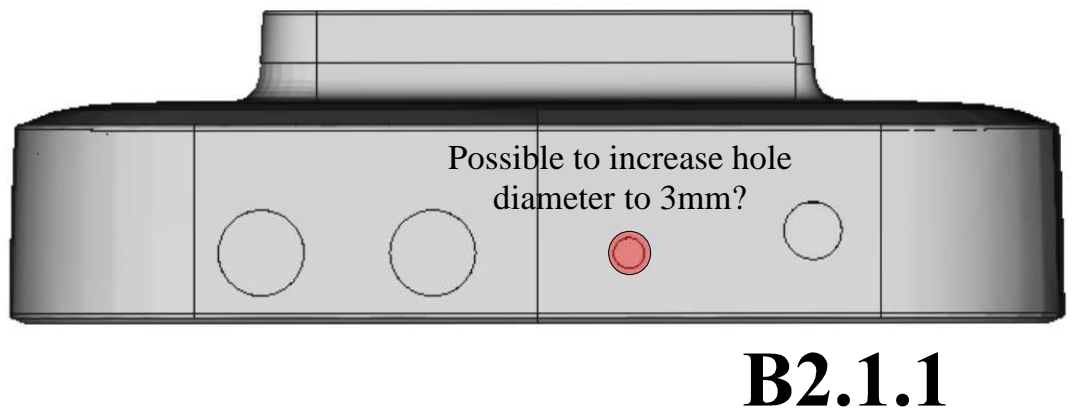
[picture p43: page 1]

Possible to increase hole
diameter to 3mm?
