eddiematos/iosolar/04 3D CAD/20150202_mods/design failures/B2.1.1_mod3.pdf

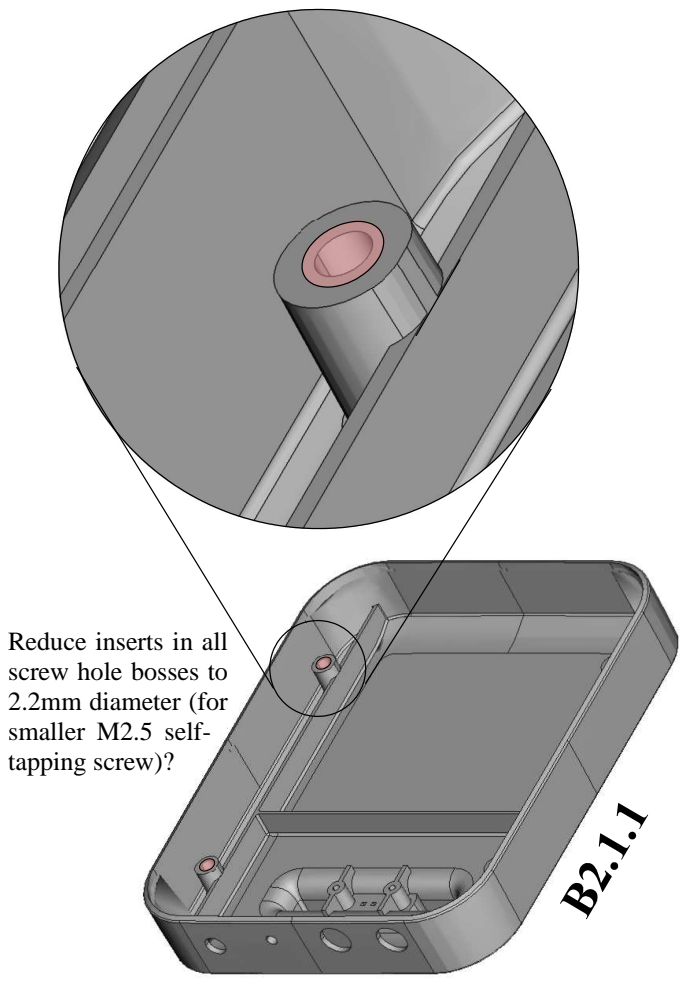
[picture p44: page 1]

Reduce inserts in all
screw hole bosses to
2.2mm diameter (for
smaller M2.5 self-
tapping screw)?
