eddiematos/iosolar/04 3D CAD/20150202_mods/design failures/SSB2.1.2_mod3.pdf

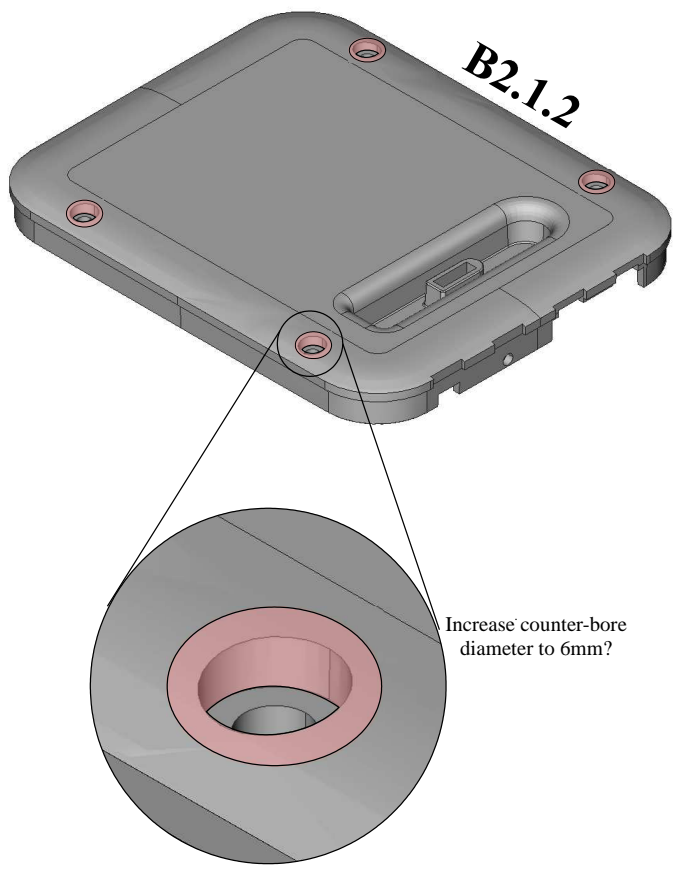
[picture p45: page 1]

Increase counter-bore
diameter to 6mm?
