eddiematos/iosolar/04 3D CAD/20150202_mods/design failures/B2.1.1_mod1.pdf

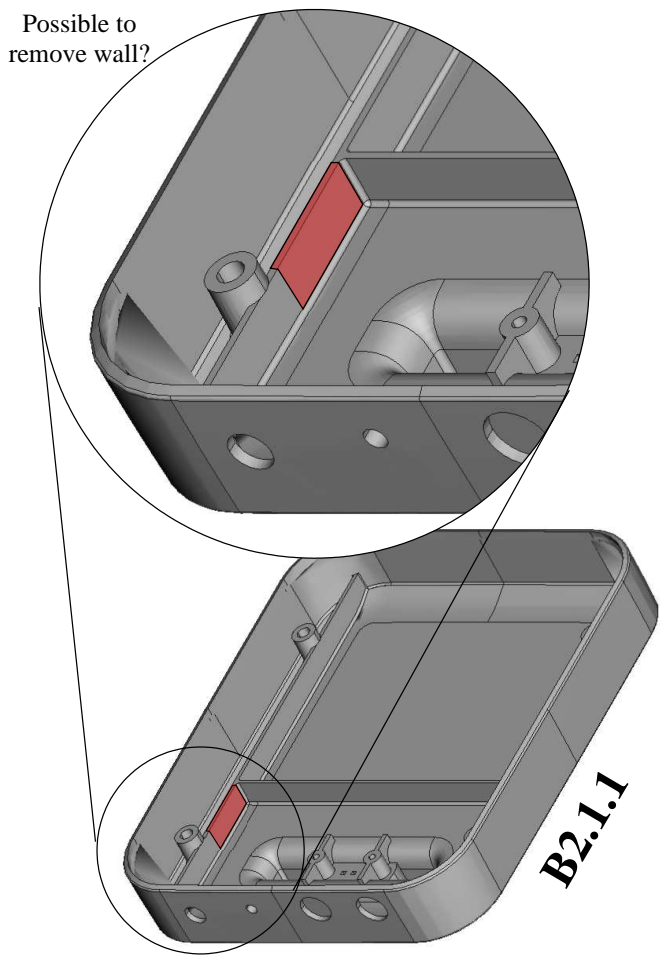
[picture p46: page 1]
Possible to remove wall?
