eddiematos/iosolar/04 3D CAD/20150202_mods/design failures/B2.1.2_mod1.pdf

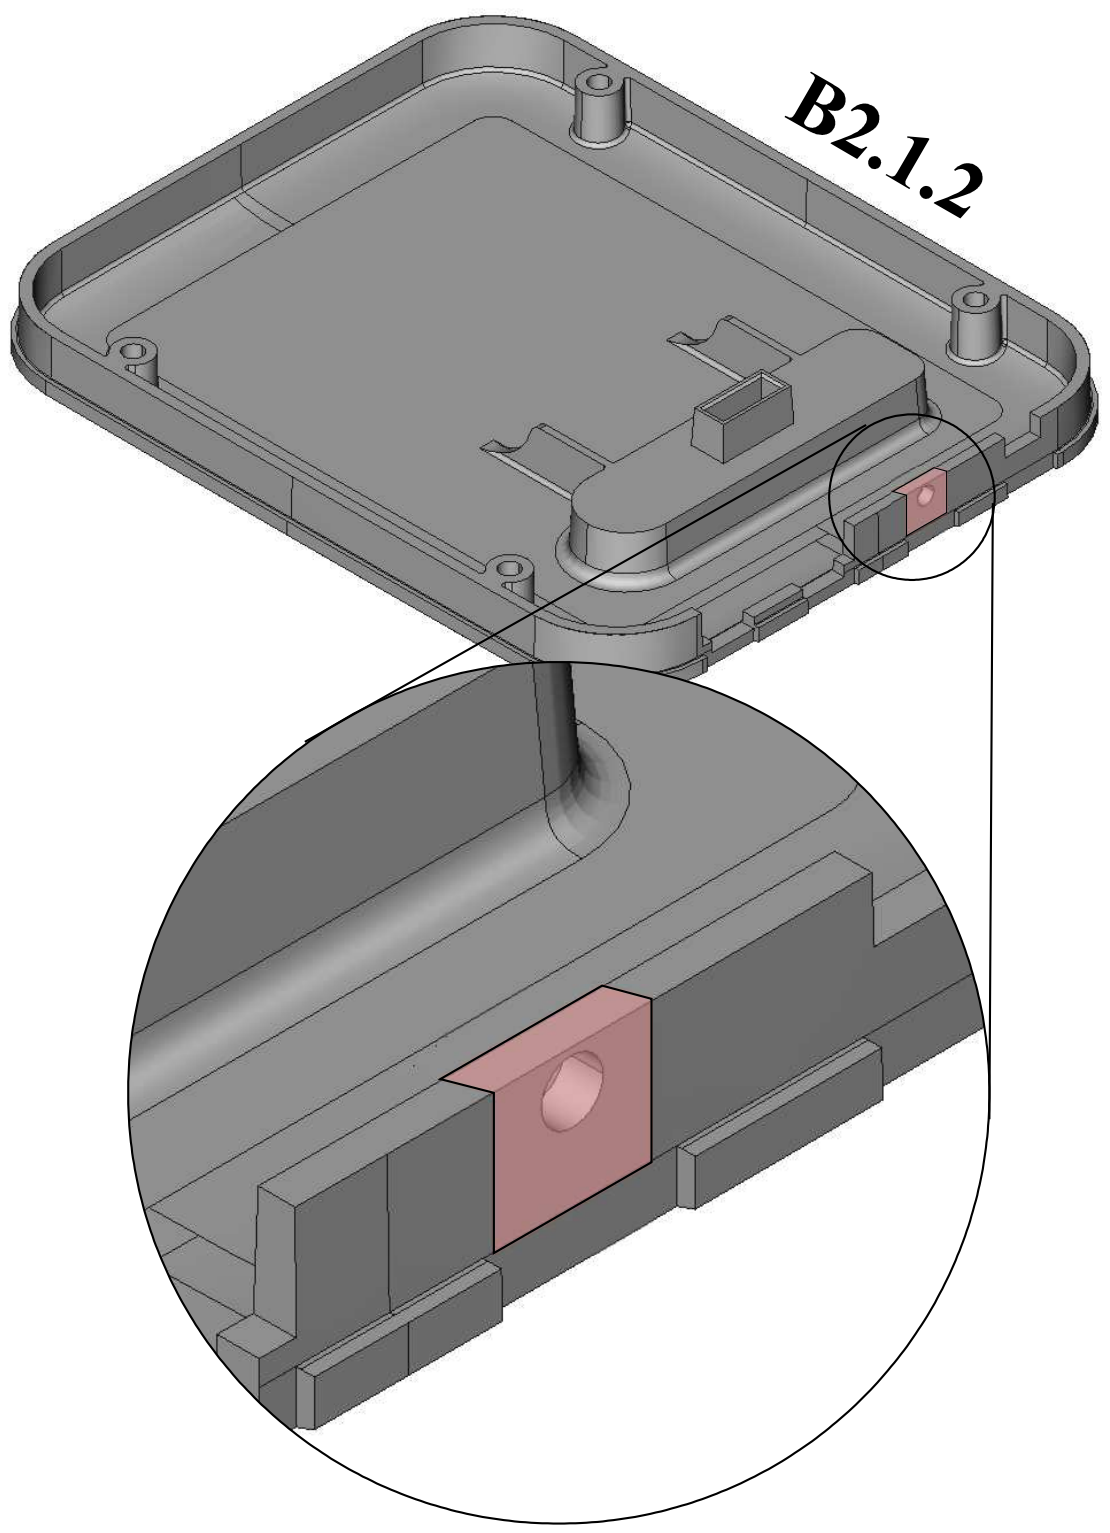
[picture p47: page 1]
