eddiematos/iosolar/04 3D CAD/20150202_mods/design failures/B2.1.2_mod2.pdf

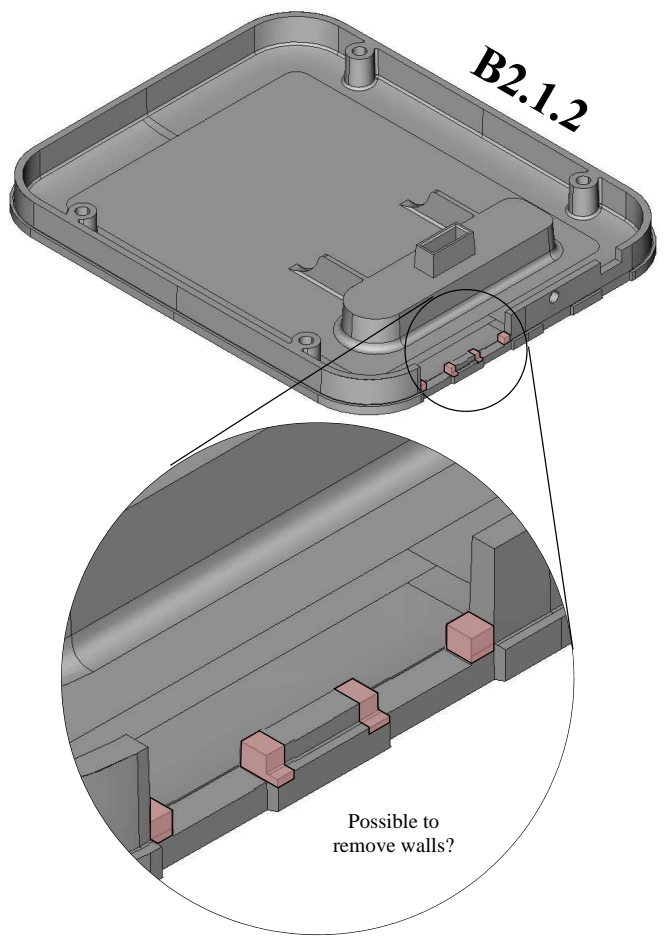
[picture p48: page 1]
Possible to remove walls?
