eddiematos/iosolar/01 Printed Circuit Board/Battery 100/battery_brick_2.12.brd

## EAGLE design 01 Printed Circuit Board/Battery 100/battery_brick_2.12.brd (2018-09-25)

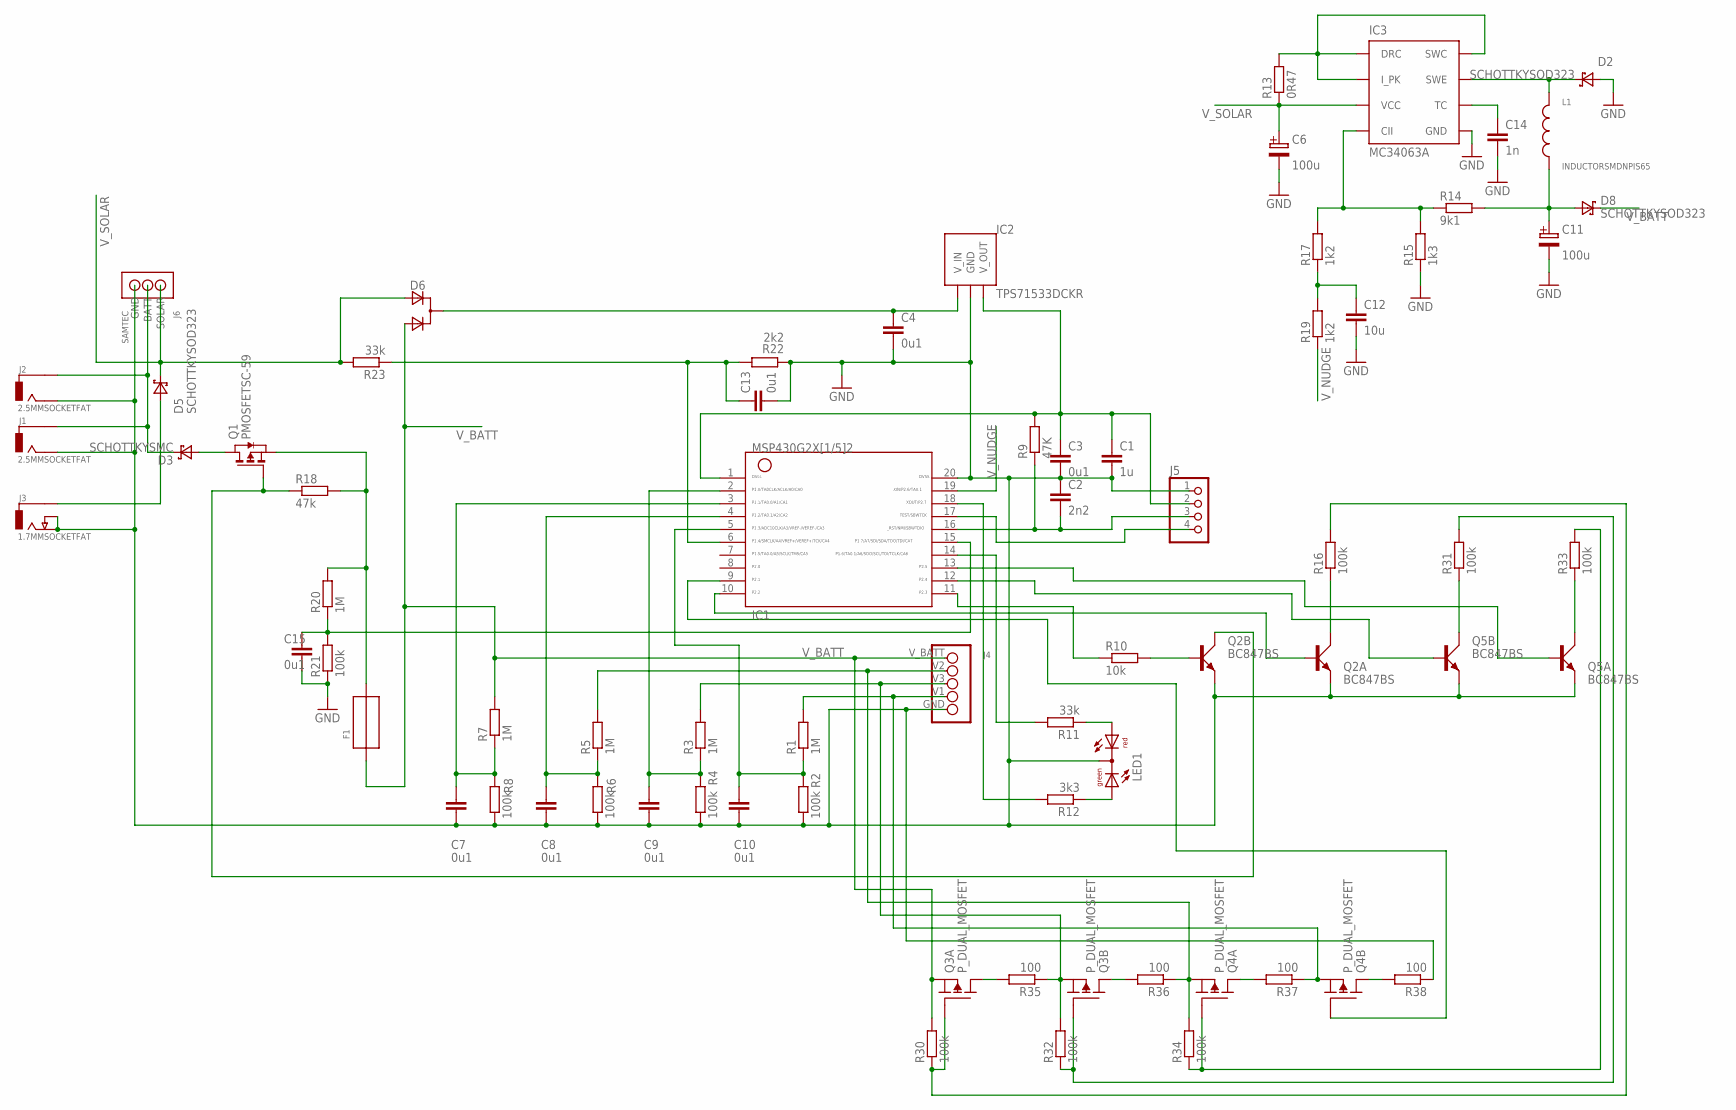
[picture p49: schematic battery_brick_2.12.sch]

Parts:
C1: 1u; C0603K
C2: 2n2; C0603K
C3: 0u1; C0603K
C4, C7, C8, C9, C10, C13, C15: 0u1; C0603
C6, C11: 100u; CAPCANVZH101
C12: 10u; C2012
C14: 1n; C0603
D2, D5, D8: SCHOTTKYSOD323; SOD323
D3: SCHOTTKYSMC; SMC
D6: D_2ASOT323; SOT323
F1: FUSE; 1812
IC1: G2X[1/5]2---PW20; PW20
IC2: TPS71533DCKR; SC70-5
IC3: MC34063A; SOIC8
J1, J2: 2.5MMSOCKETFAT; 2.5MMSOCKET-OBLONGFAT
J3: 1.7MMSOCKETFAT; 1.7MMSOCKET-OBLONGFAT
J4: S5B-PH-K-S
J5: PINHD-1X4; 1X04
J6: SAMTEC
L1: INDUCTORSMDNPIS65; INDUCTOR_NPIS65
LED1: DUOLED5MM
Q1: PMOSFETSC-59; SC-59
Q2, Q5: BC847BS; SOT363_PHILIPS
Q3, Q4: P_DUAL_MOSFET; SOT666
R1, R3, R5, R7: 1M; R0805
R2, R4, R6, R8: 100k; R0805
R9: 47K; R0603
R10: 10k; R0603
R11, R23: 33k; R0603
R12: 3k3; R0603
R13: 0R47; R1206
R14: 9k1; R0603
R15: 1k3; R0603
R16, R21, R30, R31, R32, R33, R34: 100k; R0603
R17, R19: 1k2; R0603
R18: 47k; R0603
R20: 1M; R0603
R22: 2k2; R0603
R35, R36, R37, R38: 100; M1206

Connections:
GND: C1.2, C2.1, C3.2, C4.2, C6.-VE, C7.2, C8.2, C9.2, C10.2, C11.-VE, C12.2, C13.2, C14.2, C15.2, D2.ANODE, IC1.20, IC2.GND, IC3.GND, J1.-VE, J2.-VE, J3.-VE, J3.P$3, J4.GND, J5.1, J6.GND, LED1.K (C), Q2.1 (E), Q2.4 (E), Q5.1 (E), Q5.4 (E), R2.1, R4.1, R6.1, R8.1, R15.1, R21.1, R22.1, R38.1
unnamed: IC1.17, J5.4
unnamed: C10.1, IC1.5, R1.1, R2.2
unnamed: F1.2, Q1.S, R18.2, R20.2
unnamed: C9.1, IC1.2, R3.1, R4.2
unnamed: D3.CATHODE, J1.+VE, J2.+VE, J6.BATT
unnamed: C8.1, IC1.4, R5.1, R6.2
unnamed: C7.1, IC1.3, R7.1, R8.2
unnamed: C15.1, IC1.15, R20.1, R21.2
unnamed: Q2.5 (B), R10.2
unnamed: IC1.14, R11.2
unnamed: J4.V1, Q4.4 (S), R1.2, R37.1
unnamed: D5.ANODE, J3.+VE
unnamed: LED1.AG, R12.1
unnamed: LED1.AR, R11.1
unnamed: J4.V3, Q3.4 (S), R3.2, R32.2, R35.1
unnamed: J4.V2, Q4.1 (S), R5.2, R34.2, R36.1
unnamed: IC3.DRC, IC3.I_PK, IC3.SWC, R13.2
unnamed: D3.ANODE, Q1.D
unnamed: Q1.G, Q2.3 (C), R18.1
unnamed: IC1.18, R12.2
unnamed: IC3.CII, R14.1, R15.2, R17.2
unnamed: D2.CATHODE, IC3.SWE, L1.P$1
unnamed: C13.1, IC1.6, R22.2, R23.1
unnamed: C12.1, R17.1, R19.2
unnamed: C11.+VE (P$1+), D8.ANODE, L1.P$2, R14.2
unnamed: C14.1, IC3.TC
unnamed: Q3.6 (D), R35.2
unnamed: Q5.3 (C), R31.1
unnamed: IC1.9, Q4.5 (G)
unnamed: C2.2, IC1.16, J5.3, R9.1
unnamed: Q3.2 (G), R16.2, R30.1
unnamed: Q3.5 (G), R31.2, R32.1
unnamed: Q4.2 (G), R33.2, R34.1
unnamed: Q5.6 (C), R33.1
unnamed: Q2.6 (C), R16.1
unnamed: Q4.3 (D), R38.2
unnamed: IC1.11, R10.1
unnamed: IC1.10, Q2.2 (B)
unnamed: IC1.12, Q5.5 (B)
unnamed: IC1.13, Q5.2 (B)
unnamed: Q3.3 (D), R36.2
unnamed: Q4.6 (D), R37.2
VCC: C1.1, C3.1, IC1.1, IC2.OUT (V_OUT), J5.2, R9.2
V_BATT: D6.3 (A2), D8.CATHODE, F1.1, J4.V_BATT, Q3.1 (S), R7.2, R30.2
V_NUDGE: IC1.19, R19.1
V_REGIN: C4.1, D6.1 (C), IC2.IN (V_IN)
V_SOLAR: C6.+VE (P$1+), D5.CATHODE, D6.2 (A1), IC3.VCC, J6.SOLAR, R13.1, R23.2

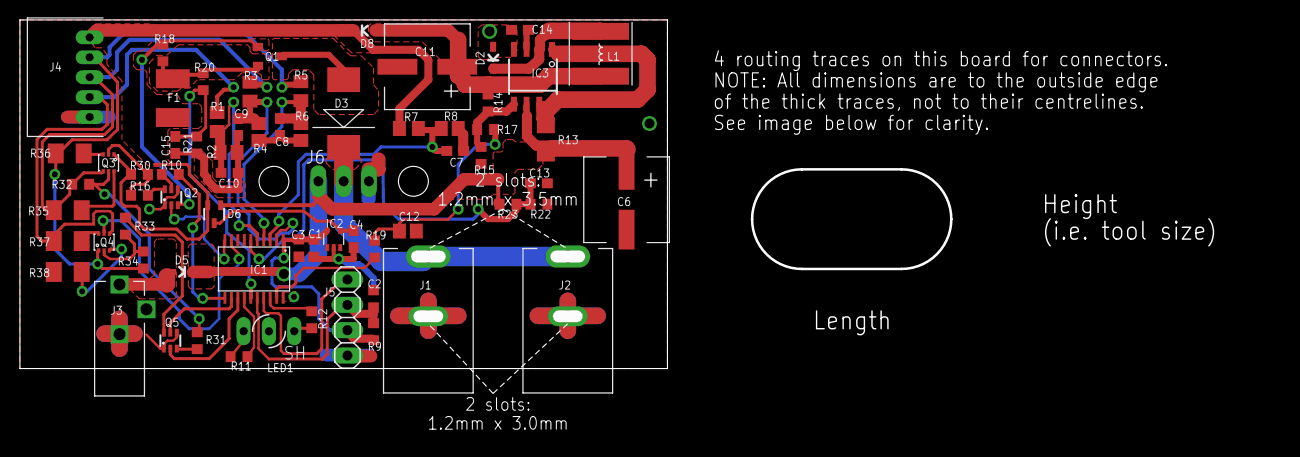
[picture p50: board battery_brick_2.12.brd from above]

Board: 2 copper layers, 65.0 x 35.0 mm, 68 parts (0 on the bottom side), 48 nets.
