eddiematos/iosolar/01 Printed Circuit Board/Charger/charger_1.2.brd

## EAGLE design 01 Printed Circuit Board/Charger/charger_1.2.brd (2018-09-25)

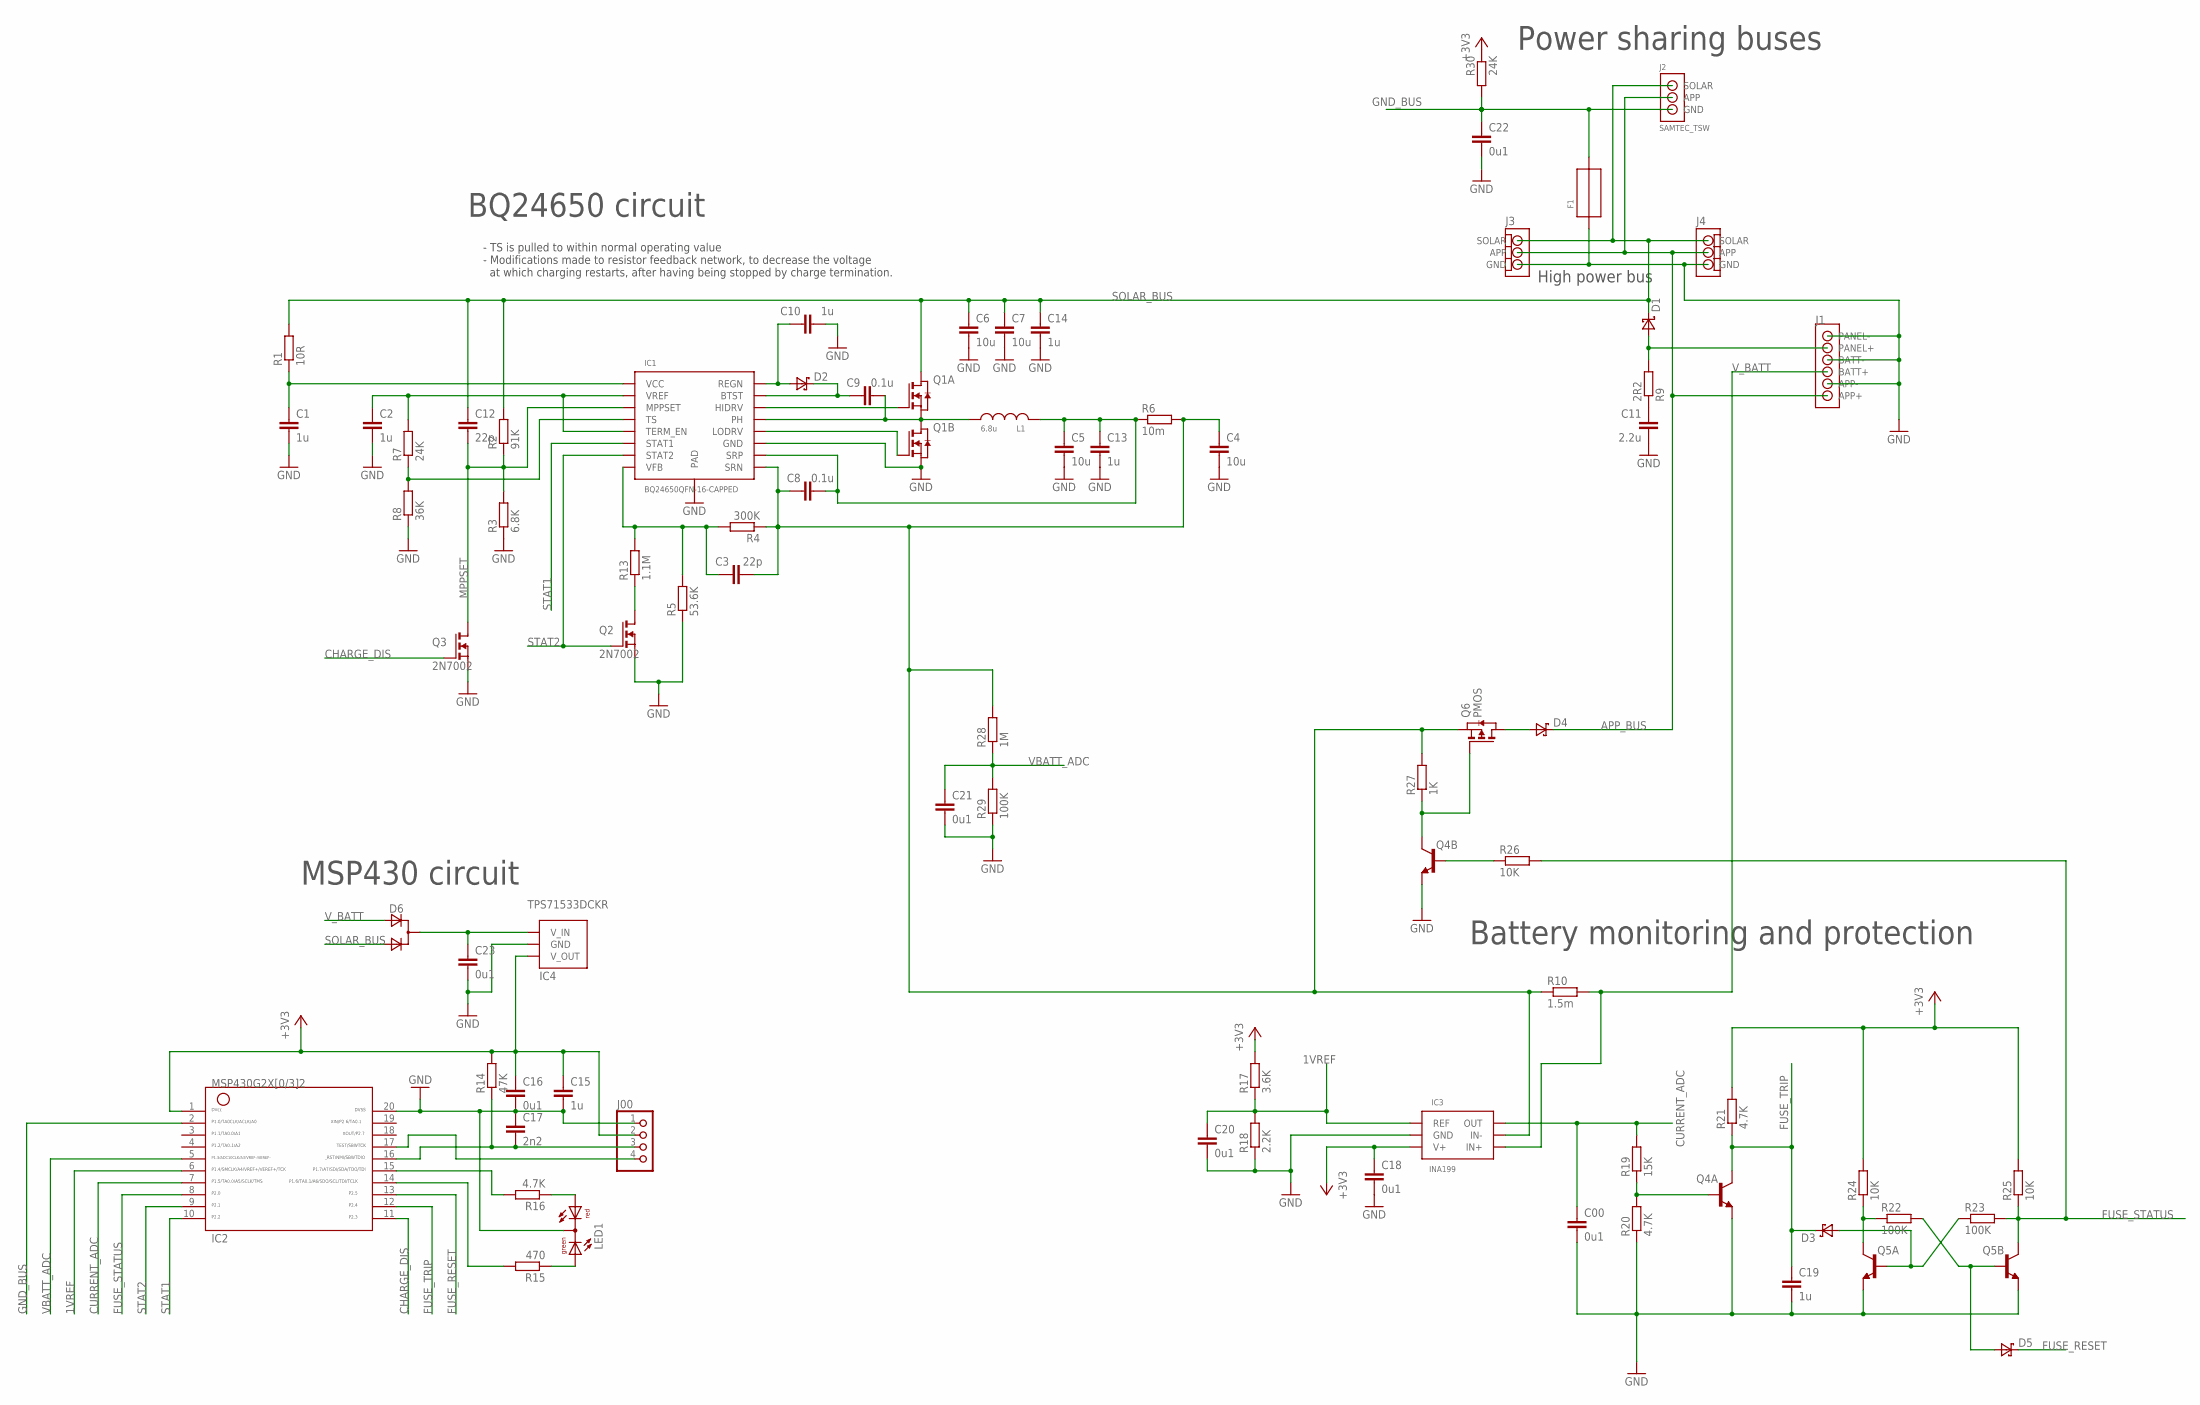
[picture p51: schematic charger_1.2.sch]

Parts:
C00, C16, C18, C20, C21, C22, C23: 0u1; C0603K
C1, C2, C10, C13, C14, C19: 1u; C0603
C3, C12: 22p; C0603
C4, C5, C6, C7: 10u; C1206
C8, C9: 0.1u; C0603
C11: 2.2u; C0603
C15: 1u; C0603K
C17: 2n2; C0603K
D1: SCHOTTKYDPAK; DPAK
D2: SCHOTTKYSOT23; SOT23
D3, D5: SCHOTTKYSOD-523F; SOD-523F
D4: SCHOTTKYSO8-FLAT; SO8-FLAT
D6: D_2ASOT23; SOT-23
F1: FUSE2920; 2920
IC1: BQ24650QFN-16-CAPPED; QFN-16-CAPPED
IC2: G2X[0/3]2---PW20; PW20
IC3: INA199; SC70-6
IC4: TPS71533DCKR; SC70-5
J00: PINHD-1X4; 1X04
J1: TERMINALBLOCK
J2: SAMTEC_TSW
J3: TERMINALBLOCK_3_REV
J4: TERMINALBLOCK_3
L1: 6.8u; INDUCTOR
LED1: DUOLED5MM
Q1: SI7288DP; POWERPAK-SO8-DUAL
Q2, Q3: 2N7002; SOT23
Q4, Q5: DUALNPN; SC70-6
Q6: PMOS; POWERPAK-SO8
R1: 10R; R0603
R2: 91K; R0603
R3: 6.8K; R0603
R4: 300K; R0603
R5: 53.6K; R0805
R6: 10m; R1206
R7, R30: 24K; R0603
R8: 36K; R0603
R9: 2R2; R0603
R10: 1.5m; R2010
R13: 1.1M; R0603
R14: 47K; R0603
R15: 470; R0603
R16, R20, R21: 4.7K; R0603
R17: 3.6K; R0603
R18: 2.2K; R0603
R19: 15K; R0603
R22, R23, R29: 100K; R0603
R24, R25, R26: 10K; R0603
R27: 1K; R0603
R28: 1M; R0805

Connections:
1VREF: C20.1, IC2.6, IC3.EMITTER-B-1 (REF), R17.1, R18.2
+3V3: C15.1, C16.1, C18.1, IC2.1, IC3.COLLECTOR-A-3 (V+), IC4.OUT (V_OUT), J00.2, R14.2, R17.2, R21.2, R24.2, R25.2, R30.1
APP_BUS: D4.CATHODE, J1.APP+, J2.APP, J3.APP, J4.APP
CHARGE_DIS: IC2.11, Q3.ANODE (G)
CURRENT_ADC: C00.1, IC2.7, IC3.COLLECTOR-B-6 (OUT), R19.2
FUSE_RESET: D5.CATHODE, IC2.13
FUSE_STATUS: IC2.8, Q5.COLLECTOR-B-6 (COLLECTOR), R23.2, R25.1, R26.2
FUSE_TRIP: C19.1, D3.CATHODE, IC2.12, Q4.COLLECTOR-A-3 (COLLECTOR), R21.1
GND: C00.2, C1.2, C2.2, C4.2, C5.2, C6.2, C7.2, C10.2, C11.2, C13.2, C14.2, C15.2, C16.2, C17.1, C18.2, C19.2, C20.2, C21.2, C22.2, C23.2, F1.P$1, IC1.GND-P11 (GND), IC1.P$17 (PAD), IC1.P$18 (PAD), IC1.P$19 (PAD), IC1.P$20 (PAD), IC2.20, IC3.BASE-B-2 (GND), IC4.GND, J00.1, J1.APP-, J1.BATT-, J1.PANEL-, J3.GND, J4.GND, LED1.K (C), Q1.S2 (S), Q2.NC (S), Q3.NC (S), Q4.EMITTER-B-1 (EMMITER), Q4.EMMITER-A-4 (EMMITER), Q5.EMITTER-B-1 (EMMITER), Q5.EMMITER-A-4 (EMMITER), R3.1, R5.1, R8.1, R18.1, R20.1, R29.1
GND_BUS: C22.1, F1.P$2, IC2.2, J2.GND, R30.2
MPPSET: C12.2, IC1.MPPSET-P2 (MPPSET), Q3.CATHODE (D), R2.1, R3.2
unnamed: IC2.15, R16.2
unnamed: IC1.HIDRV-P15 (HIDRV), Q1.G1 (G)
unnamed: Q2.CATHODE (D), R13.1
unnamed: LED1.AR, R16.1
unnamed: C9.2, IC1.PH-P14 (PH), L1.P$2, Q1.D2A (D), Q1.D2B (D), Q1.D2C (D), Q1.S1 (S)
unnamed: IC1.TS-P4 (TS), R7.1, R8.2
unnamed: C9.1, D2.CATHODE, IC1.BTST-P16 (BTST)
unnamed: IC1.LODRV-P13 (LODRV), Q1.G2 (G)
unnamed: C3.1, IC1.VFB-P8 (VFB), R4.2, R5.2, R13.2
unnamed: C10.1, D2.ANODE, IC1.REGN-P12 (REGN)
unnamed: IC2.17, J00.4
unnamed: Q4.BASE-A-5 (BASE), R19.1, R20.2
unnamed: LED1.AG, R15.1
unnamed: D5.ANODE, Q5.BASE-B-2 (BASE), R22.2
unnamed: Q5.COLLECTOR-A-3 (COLLECTOR), R22.1, R24.1
unnamed: C2.1, IC1.TERM_EN-P7 (TERM_EN), IC1.VREF-P6 (VREF), R7.2
unnamed: D3.ANODE, Q5.BASE-A-5 (BASE), R23.1
unnamed: Q4.COLLECTOR-B-6 (COLLECTOR), Q6.G, R27.1
unnamed: D4.ANODE1 (ANODE), D4.ANODE2 (ANODE), D4.ANODE3 (ANODE), Q6.D1 (D), Q6.D2 (D), Q6.D3 (D), Q6.D4 (D)
unnamed: IC2.14, R15.2
unnamed: Q4.BASE-B-2 (BASE), R26.1
unnamed: C23.1, D6.1 (C), IC4.IN (V_IN)
unnamed: C17.2, IC2.16, J00.3, R14.1
SOLAR_BUS: C6.1, C7.1, C12.1, C14.1, D1.CATHODE, D6.3 (A2), J2.SOLAR, J3.SOLAR, J4.SOLAR, Q1.D1A (D), Q1.D1B (D), Q1.D1C (D), R1.2, R2.2
SOLAR_IN: D1.ANODE1 (ANODE), D1.ANODE2 (ANODE), J1.PANEL+, R9.2
SRP: C5.1, C8.2, C13.1, IC1.SRP-P10 (SRP), L1.P$1, R6.1
STAT1: IC1.STAT1-P3 (STAT1), IC2.10
STAT2: IC1.STAT2-P5 (STAT2), IC2.9, Q2.ANODE (G)
VBATT_ADC: C21.1, IC2.5, R28.1, R29.2
VCC: C1.1, IC1.VCC-P1 (VCC), R1.1
VCC1: C11.1, R9.1
V_BATT: D6.2 (A1), IC3.EMMITER-A-4 (IN+), J1.BATT+, R10.2
V_CHARGE: C3.2, C4.1, C8.1, IC1.SRN-P9 (SRN), IC3.BASE-A-5 (IN-), Q6.S1 (S), Q6.S2 (S), Q6.S3 (S), R4.1, R6.2, R10.1, R27.2, R28.2

Notes on the sheet:
BQ24650 circuit
- TS is pulled to within normal operating value - Modifications made to resistor feedback network, to decrease the voltage at which charging restarts, after having being stopped by charge termination.
MSP430 circuit
High power bus
Power sharing buses
Battery monitoring and protection

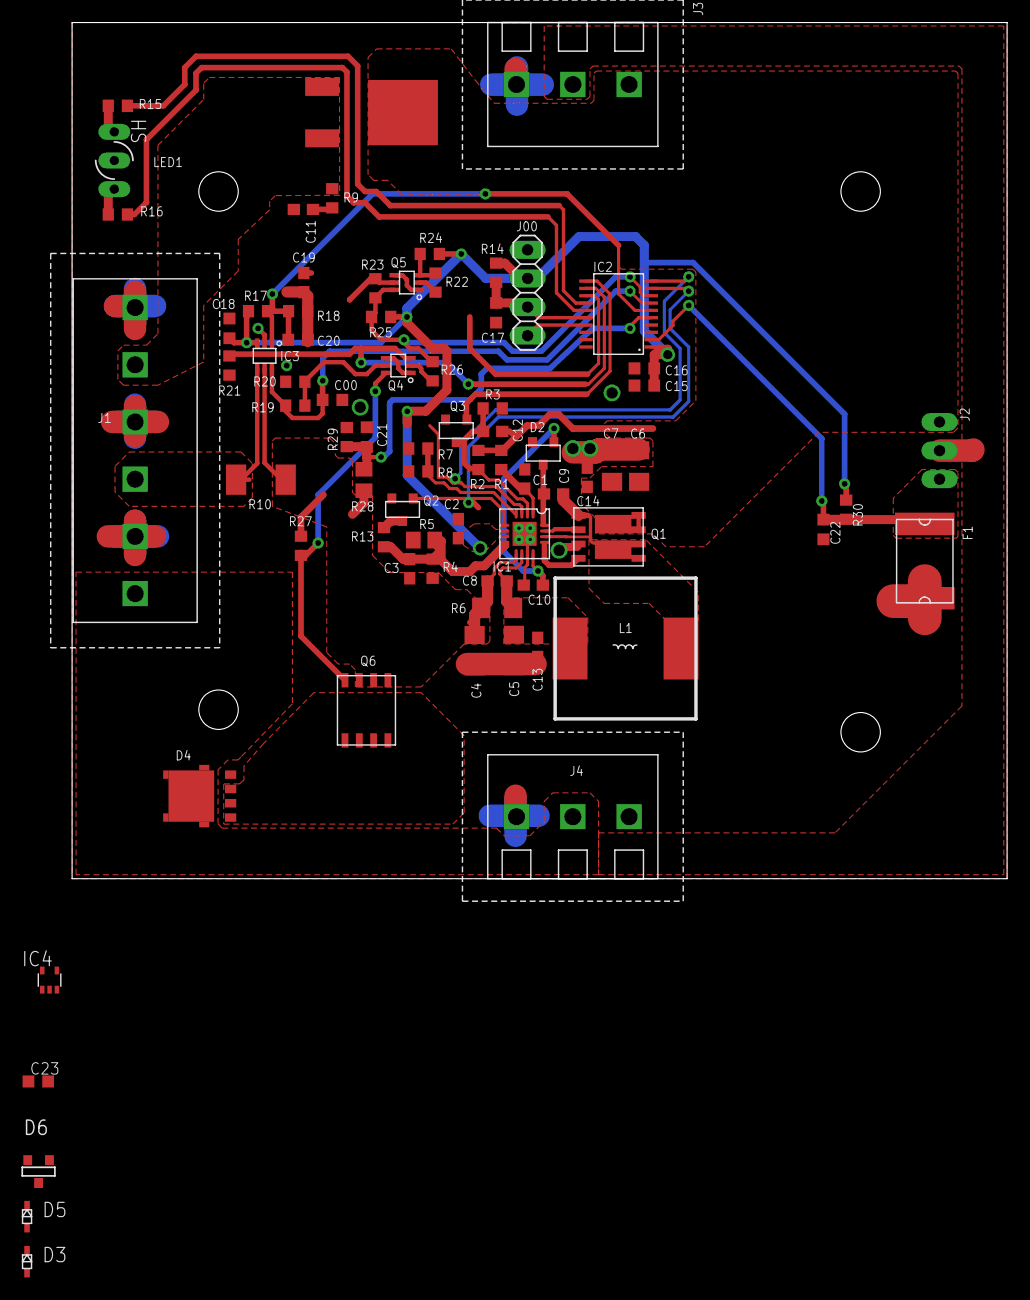
[picture p52: board charger_1.2.brd from above]

Board: 2 copper layers, 83.0 x 76.0 mm, 76 parts (0 on the bottom side), 44 nets.
