eddiematos/iosolar/01 Printed Circuit Board/Starter/usb-brick_2.03.brd

## EAGLE design 01 Printed Circuit Board/Starter/usb-brick_2.03.brd (2018-09-25)

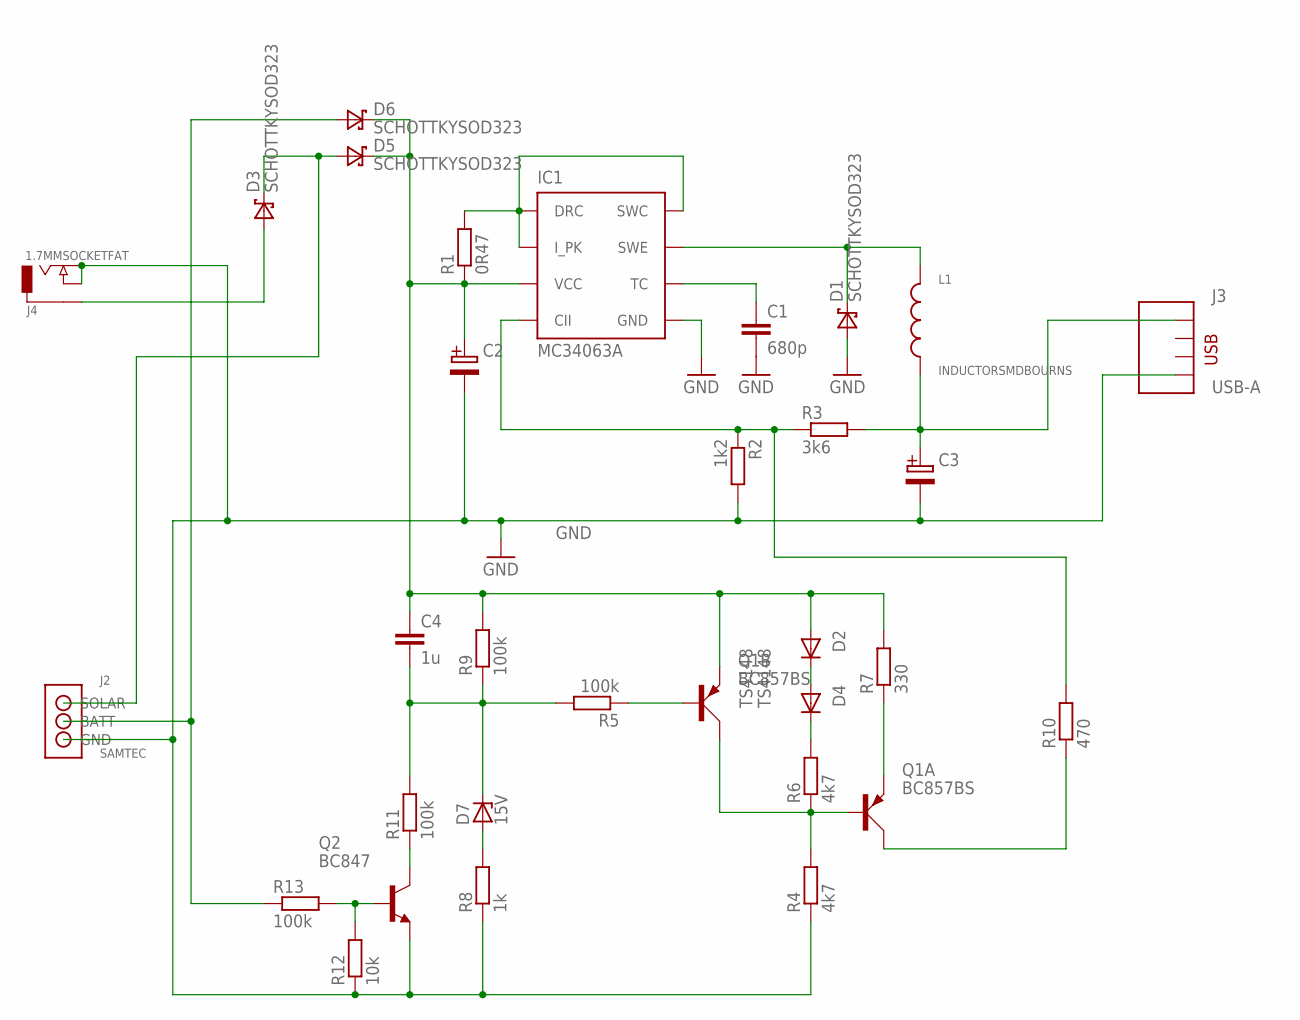
[picture p53: schematic usb-brick_2.03.sch]

Parts:
C1: 680p; C0603
C2, C3: ELEC_CAP_CANVZH101; CAPCANVZH101
C4: 1u; C0603
D1, D3, D5, D6: SCHOTTKYSOD323; SOD323
D2, D4: TS4148; 0805
D7: 15V; SOT23
IC1: MC34063A; SOIC8
J2: SAMTEC
J3: USB-A
J4: 1.7MMSOCKETFAT; 1.7MMSOCKET-OBLONGFAT
L1: INDUCTORSMDBOURNS; INDUCTOR_BOURNS
Q1: BC857BS; SOT363_PHILIPS
Q2: BC847; SOT23
R1: 0R47; R1206
R2: 1k2; R0603
R3: 3k6; R0603
R4, R6: 4k7; R0603
R5, R9, R11, R13: 100k; R0603
R7: 330; R0603
R8: 1k; R0603
R10: 470; R0603
R12: 10k; R0603

Connections:
C3: C3.+VE (P$1+), J3.5V, L1.P$2, R3.2
GND: C1.2, C2.-VE, C3.-VE, D1.ANODE, IC1.GND, J2.GND, J3.GND, J4.-VE, J4.P$3, Q2.2 (E), R2.2, R4.1, R8.1, R12.1
unnamed: D1.CATHODE, IC1.SWE, L1.P$1
unnamed: D3.CATHODE, D5.ANODE, J2.SOLAR
unnamed: C2.+VE (P$1+), C4.1, D2.A, D5.CATHODE, D6.CATHODE, IC1.VCC, Q1.4 (E), R1.1, R7.2, R9.2
unnamed: IC1.CII, R2.1, R3.1, R10.2
unnamed: C1.1, IC1.TC
unnamed: Q1.2 (B), Q1.3 (C), R4.2, R6.1
unnamed: Q1.6 (C), R10.1
unnamed: D3.ANODE, J4.+VE
unnamed: C4.2, D7.3 (C), R5.2, R9.1, R11.2
unnamed: D2.C, D4.A
unnamed: Q1.1 (E), R7.1
unnamed: IC1.DRC, IC1.I_PK, IC1.SWC, R1.2
unnamed: Q1.5 (B), R5.1
unnamed: D7.1 (A), R8.2
unnamed: D4.C, R6.2
unnamed: Q2.1 (B), R12.2, R13.2
unnamed: Q2.3 (C), R11.1
unnamed: D6.ANODE, J2.BATT, R13.1

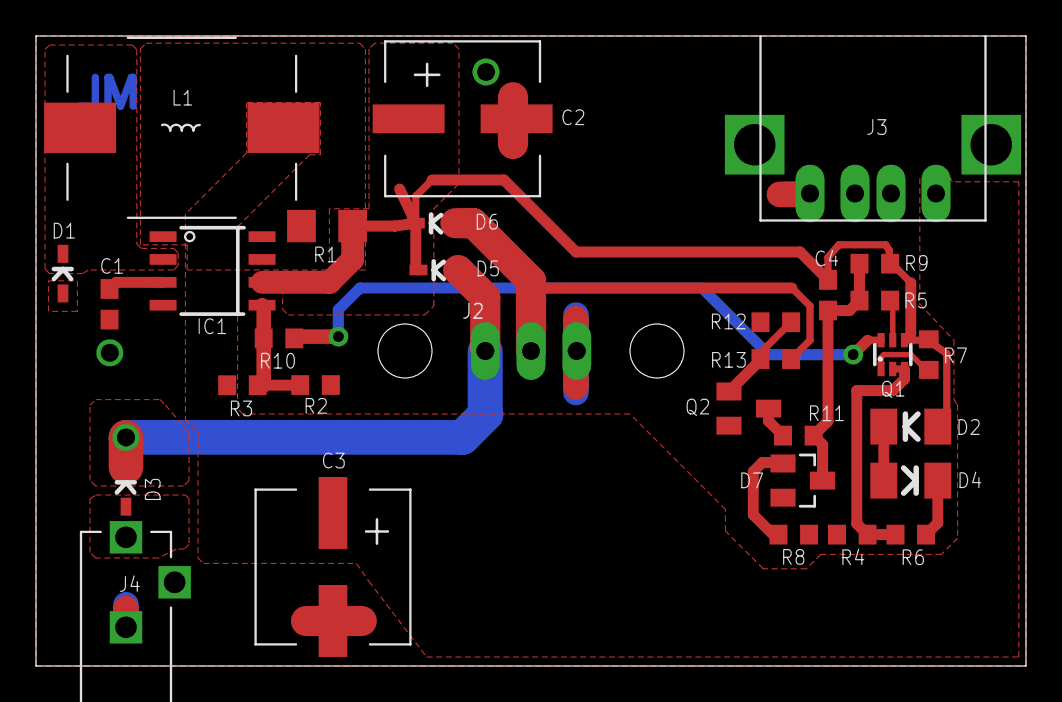
[picture p54: board usb-brick_2.03.brd from above]

Board: 2 copper layers, 55.0 x 35.0 mm, 31 parts (0 on the bottom side), 20 nets.
